highpeng/sub/electrical/bom.xlsx

Sheet: Sheet1
 |  | L | delta IL | Rsense |  | Rsense,comp | Psense | Id peak | fr | fc | Rcomp | Ccomp | Ccomp2
12.6 | 0.65 | 4.7775e-06 | 1.428571429 | 0.04958333333 |  |  |  |  | 293824.7585
9 | 0.75 | 2.8125e-06 | 2 | 0.03541666667 |  | 0.03225880592 | 0.0313985711 | 4 | 254648.124 | 20000 | 15085.78924 | 2.110000013e-09 | 100pF
Current |  |  |  |  | Vcs | 0.09000141667
0.5
 |  |  |  | 1919.937206
Mmin | Mmax | Rout
2.857142857 | 4

Sheet: BOM
 |  |  |  |  | Qty Required | Qty Ordered
v BT401, BT501 | Battery |  | ~ | 2
C201 | 0.01uF |  | ~ | 1
> C202, C204 | 10nF |  | ~ | 2
> C203, C206, C301, C302, C1101, C1103, C1105, C1107, C1109-C1115, C1117-C1120, C1124, C1125, C1202 | 0.1uF |  | ~ | 22
> C205, C207, C303, C1102, C1104, C1106, C1108, C1206, C1207 | 4.7uF |  | ~ | 9
> C208, C209 | 230nF |  | ~ | 2
> C210, C211 | 100pF, 50V |  | ~ | 2
> C401, C501, C1209, C1211-C1213 | C_Small |  | ~ | 6
> C601, C602, C611 | 22uF,35V | Capacitor_SMD:C_1210_3225Metric | 587-5853-1-ND | 3
> C603-C606, C612, C613 | 0.1uF | Capacitor_SMD:C_0402_1005Metric | 1276-1044-1-ND | 6
> C607-C610, C614, C615 | 22uF | Capacitor_SMD:C_1210_3225Metric | 1276-1851-1-ND | 6
> C701-C704, C1123 | 1.0uF |  | ~ | 5
C901 | 10uF, 25V |  | ~ | 1
C902 | 0.01uF, 16V |  | ~ | 1
> C903, C904 | 1uF, 16V |  | ~ | 2
> C1116, C1121, C1122 | 2.2uF |  | ~ | 3
C1201 | 22uF, 25V |  | ~ | 1
C1203 | 33nF |  | ~ | 1
C1204 | 6.8nF |  | ~ | 1
C1205 | 22uF, 63V, X7R |  | ~ | 1
C1208 | 0.1uF, 50V |  | ~ | 1
C1210 | CP1 |  | ~ | 1
> D201-D203, D1101 | LED |  | ~ | 4
D901 | BZX84C11 |  | ~ | 1
D902 | CMDSH-3 |  | ~ | 1
D903 | SS13 |  | ~ | 1
D1201 | 50V,4A |  | ~ | 1
D1202 | D |  | ~ | 1
F101 | 6A |  | ~ | 1
> FB201, FB202 | FB |  | ~ | 2
FL201 | 2.2mH |  | ~ | 1
J201 | Ethernet |  | ~ | 1
J301 | RS485 |  | ~ | 1
> J401-J404, J501-J504, J913 | Conn_01x02 |  | ~ | 9
> J701-J704 | PTC thermistor |  | ~ | 4
J705 | water sensor |  | ~ | 1
J706 | IMU |  | ~ | 1
> J801, J1101, J1102 | USB_B_Micro |  | ~ | 3
J802 | Cam0 |  | ~ | 1
> J803, J1104 | Micro_SD_Card_Det |  | https://www.hirose.com/product/en/download_file/key_name/DM3/category/Catalog/doc_file_id/49662/?item_id=195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 | 2
J804 | Cam1 |  | ~ | 1
> J901-J912 | Conn_01x03 |  | ~ | 12
J1001 | Raspberry_Pi_Zero |  | https://www.raspberrypi.org/documentation/hardware/raspberrypi/schematics/rpi_SCH_3bplus_1p0_reduced.pdf | 1
J1103 | JTAG |  | ~ | 1
J1201 | lidar |  | ~ | 1
J1202 | barometer |  | ~ | 1
J1203 | pinger |  | ~ | 1
J1204 | depth |  | ~ | 1
L601 | 2.0uH | holo:NR8040 | 587-1997-1-ND | 1
L602 | 3.6uH | holo:NR8040 | 587-1998-1-ND | 1
L603 | 4.7uH | holo:NR8040 | 587-1999-1-ND | 1
L901 | 6.8uH, 1.5A |  | ~ | 1
L1201 | 13.3uH, 4A |  | ~ | 1
Q1201 | 2N7002K | Package_TO_SOT_SMD:SOT-23 | https://www.diodes.com/assets/Datasheets/ds30896.pdf | 1
> R101-R104, R801, R802, R1201, R1209-R1211, R1213 | 4.7K |  | ~ | 11
R105 | 0R |  | ~ | 1
> R201, R204 | 50R |  | ~ | 2
> R202, R203 | 2K |  | ~ | 2
> R205-R207 | 470R |  | ~ | 3
> R301, R1203 | 40K |  | ~ | 2
R302 | 120R |  | ~ | 1
> R401, R501 | 0m5 |  | WSLP4026 | 2
> R601, R602, R608 | 100K | Resistor_SMD:R_0402_1005Metric | RMCS0402JT100KCT-ND | 3
R603 | 47K | Resistor_SMD:R_0402_1005Metric | 541-3966-1-ND | 1
R604 | 5.0K | Resistor_SMD:R_0402_1005Metric | 541-3972-1-ND | 1
R605 | 10.31K | Resistor_SMD:R_0402_1005Metric | RR12P10.2KDCT-ND | 1
> R606, R609 | 75K | Resistor_SMD:R_0402_1005Metric | 541-5078-1-ND | 2
R607 | 27.6K | Resistor_SMD:R_0402_1005Metric | ‎311-27.4KLRCT-ND‎ | 1
R610 | 14.46K | Resistor_SMD:R_0402_1005Metric |  | 1
> R701-R704 | SOT |  | ~ | 4
R705 | 1.0M |  | ~ | 1
> R706, R707 | 100K |  | ~ | 2
> R803-R806 | 1.8K |  | ~ | 4
> R901, R1205 | 10K |  | ~ | 2
R902 | 0R2, 0.5W |  | ~ | 1
R1101 | 8.06K, 1% |  | ~ | 1
R1102 | 330R |  | ~ | 1
R1202 | 66.5K |  | ~ | 1
R1204 | 276K |  | ~ | 1
R1206 | 10R |  | ~ | 1
> R1207, R1208 | NIP |  | ~ | 2
R1212 | 1.0K |  | ~ | 1
RL1201 | G2RL-2-ASI-DC5 | Relay_THT:Relay_DPDT_Omron_G2RL | https://omronfs.omron.com/en_US/ecb/products/pdf/en-g2rl.pdf | 1
T1201 | Transformer_SP_1S |  | ~ | 1
U201 | DP83TD510E |  |  | 1 | 2 | stock-3
U301 | MAX22500E |  |  | 1 | 0 | 0
> U401, U501 | LTC2943 |  |  | 2 | 1 | 2
> U601-U603 | RT7263A | holo:SOP-EP-8_3.9x4.9mm_P1.27mm | 1028-1217-1-ND | 3 | 5 | 10
U701 | TLV7011 |  |  | 1 | 1 | 2
U801 | RaspberryPi-CM3+ |  | https://www.raspberrypi.org/documentation/hardware/computemodule/datasheets/rpi_DATA_CM3plus_1p0.pdf | 1
> U901-U903 | 74HCT125 |  | 1727-2834-1-ND | 3 | 3 | 5
U904 | LM3405A |  |  | 1 | 1 | 2
U1101 | USB3318 |  |  | 1 | 2 | 3
U1102 | STM32F217IETx | Package_QFP:LQFP-176_24x24mm_P0.5mm | http://www.st.com/st-web-ui/static/active/en/resource/technical/document/datasheet/CD00263874.pdf | 1 | 2 | stock -3
U1201 | MP3426 |  |  | 1 | 1 | 2
U1202 | ADP165 |  |  | 1 | 1 | 2
U1203 | TUSS44x0 |  |  | 1
X1101 | ASE-13MHz | Oscillator:Oscillator_SMD_Abracon_ASE-4Pin_3.2x2.5mm | http://www.abracon.com/Oscillators/ASV.pdf | 1
X1102 | ASE-25MHz | Oscillator:Oscillator_SMD_Abracon_ASE-4Pin_3.2x2.5mm | http://www.abracon.com/Oscillators/ASV.pdf | 1

Sheet: BOM - sub, base
> BT401, BT501 | Battery | sub:AMASS_XT60-M | ~ | 2
> C1211, C1214 | SOT | Capacitor_SMD:C_0603_1608Metric | ~ | 2
C1216 | NIP | Capacitor_SMD:C_0603_1608Metric | ~ | 1
C1217 | SOT | Capacitor_SMD:C_0402_1005Metric | ~ | 1
> J401-J404, J501-J504 | thruster_esc | sub:AMASS_XT30U-F_1x02_P5.0mm_Vertical | ~ | 8
J901 | thruster_esc0 | Connector_PinHeader_2.54mm:PinHeader_1x03_P2.54mm_Vertical | ~ | 1
J902 | thruster_esc1 | Connector_PinHeader_2.54mm:PinHeader_1x03_P2.54mm_Vertical | ~ | 1
J903 | thruster_esc2 | Connector_PinHeader_2.54mm:PinHeader_1x03_P2.54mm_Vertical | ~ | 1
J904 | thruster_esc3 | Connector_PinHeader_2.54mm:PinHeader_1x03_P2.54mm_Vertical | ~ | 1
J905 | thruster_esc4 | Connector_PinHeader_2.54mm:PinHeader_1x03_P2.54mm_Vertical | ~ | 1
J906 | thruster_esc5 | Connector_PinHeader_2.54mm:PinHeader_1x03_P2.54mm_Vertical | ~ | 1
J907 | thruster_esc6 | Connector_PinHeader_2.54mm:PinHeader_1x03_P2.54mm_Vertical | ~ | 1
J908 | thruster_esc7 | Connector_PinHeader_2.54mm:PinHeader_1x03_P2.54mm_Vertical | ~ | 1
J909 | servo0 | Connector_PinHeader_2.54mm:PinHeader_1x03_P2.54mm_Vertical | ~ | 1
J910 | servo1 | Connector_PinHeader_2.54mm:PinHeader_1x03_P2.54mm_Vertical | ~ | 1
J911 | servo2 | Connector_PinHeader_2.54mm:PinHeader_1x03_P2.54mm_Vertical | ~ | 1
J912 | servo3 | Connector_PinHeader_2.54mm:PinHeader_1x03_P2.54mm_Vertical | ~ | 1
J1101 | nRPIBoot | Connector_PinHeader_1.27mm:PinHeader_1x02_P1.27mm_Vertical | ~ | 1
R105 | 0R | sub:AMASS_XT30U-F_1x02_P5.0mm_Vertical | ~ | 1
> R1101, R1103 | DNP | Resistor_SMD:R_0402_1005Metric | ~ | 2
> R1207, R1208 | NIP | Resistor_SMD:R_1206_3216Metric | ~ | 2
R1211 | NIP | Resistor_SMD:R_0603_1608Metric | ~ | 1
BT701 | Battery | sub:AMASS_XT60-M | ~ | 1
J702 | Battery charge | Connector_JST:JST_XH_B3B-XH-AM_1x03_P2.50mm_Vertical | ~ | 1
J801 | nRPIBoot | Connector_PinHeader_1.27mm:PinHeader_1x02_P1.27mm_Vertical | ~ | 1
> R801, R803 | DNP | Resistor_SMD:R_0402_1005Metric | ~ | 2
TH701 | 103AT | Connector_Hirose:Hirose_DF13C_CL535-0402-2-51_1x02-1MP_P1.25mm_Vertical | ~ | 1
> U601-U603 | RT7263A | sub:SOP-EP-8_3.9x4.9mm_P1.27mm | 1028-1217-1-ND | 3
> U601-U603 | RT7263A | sub:SOP-EP-8_3.9x4.9mm_P1.27mm | 1028-1217-1-ND | 3
BZ201 | Buzzer | sub:CPI-1375-80T | 102-CPI-1375-80T-ND | 1
> R706, R708-R710, R1102, R1213 | 1.0K | Resistor_SMD:R_0402_1005Metric | 118-CR0402AFX-1001GLFCT-ND | 6
> R209, R210, R802 | 1.0K | Resistor_SMD:R_0402_1005Metric | 118-CR0402AFX-1001GLFCT-ND | 3
> C206, C207, C303, C705, C801, C901, C902, C905, C1206, C1208, C1302, C1304, C1306, C1308, C1330 | 4.7uF | Capacitor_SMD:C_0603_1608Metric | 1276-1044-1-ND | 15
> C202, C204, C206, C208, C306, C307, C403, C501, C703 | 4.7uF | Capacitor_SMD:C_0603_1608Metric | 1276-1044-1-ND | 9
> C1316, C1321, C1322, C1326 | 2.2uF | Capacitor_SMD:C_0603_1608Metric | 1276-1134-1-ND | 4
> C211, C219, C232, C233 | 2.2uF | Capacitor_SMD:C_0603_1608Metric | 1276-1134-1-ND | 4
> C601, C606, C607, C616-C618, C907, C1201, C1218 | 10uF,25V | Capacitor_SMD:C_1206_3216Metric | 1276-1181-1-ND | 9
> C601, C602, C607-C610, C701 | 10uF,25V | Capacitor_SMD:C_1206_3216Metric | 1276-1181-1-ND | 7
> C604, C605, C612-C615 | 22uF | Capacitor_SMD:C_1210_3225Metric | 1276-1851-1-ND | 6
> C605, C606, C615-C618, C704, C707 | 22uF, 16V | Capacitor_SMD:C_1210_3225Metric | 1276-1851-1-ND | 8
> C401, C501, C701-C704, C910, C911, C1102, C1323 | 1.0uF, 16V | Capacitor_SMD:C_0603_1608Metric | 1276-6524-1-ND | 10
> C213, C214, C234, C705, C706, C801 | 1.0uF | Capacitor_SMD:C_0603_1608Metric | 1276-6524-1-ND | 6
C908 | 0.1uF,25V | Capacitor_SMD:C_01005_0402Metric | 1276-CL05B104KA54PNCCT-ND | 1
> C204, C205, C301, C302, C602, C603, C608-C611, C706, C903, C904, C906, C1103, C1202, C1301, C1303, C1305, C1307, C1309-C1315, C1317-C1320, C1324, C1325, C1327-C1329 | 0.1uF | Capacitor_SMD:C_0402_1005Metric | 1292-1630-1-ND | 36
> C201, C203, C205, C207, C209, C210, C212, C215-C218, C220-C222, C225, C235-C237, C304, C305, C401, C402, C603, C604, C611-C614, C702, C802 | 0.1uF | Capacitor_SMD:C_0402_1005Metric | 1292-1630-1-ND | 30
> C212, C213 | 100pF, 50V | Capacitor_SMD:C_0603_1608Metric | 13-CC0603KPX7R9BB101CT-ND | 2
> C312, C313 | 100pF, 50V | Capacitor_SMD:C_0603_1608Metric | 13-CC0603KPX7R9BB101CT-ND | 2
> JY201-JY204 | joystick | sub:XDCR_COM-09032 | 1568-1526-ND | 4
U1201 | MP3426 | Package_DFN_QFN:DFN-14-1EP_3x4mm_P0.5mm_EP1.7x3.3mm | 1589-1644-1-ND | 1
U204 | MP6513 | Package_TO_SOT_SMD:TSOT-23-6 | 1589-1709-1-ND | 1
U701 | MP2672A | sub:QFN-18 | 1589-MP2672AGD-0000-ZCT-ND | 1
D1202 | 1N4148 | Diode_SMD:D_SOD-123 | 1655-1360-1-ND | 1
> D703-D705 | 1N4148 | Diode_SMD:D_SOD-123 | 1655-1360-1-ND | 3
> U901-U903 | 74HCT125 | Package_SO:SO-14_3.9x8.65mm_P1.27mm | 1727-2834-1-ND | 3
U1205 | 74LVC2G17 | Package_TO_SOT_SMD:SOT-363_SC-70-6 | 1727-4122-1-ND | 1
F101 | 6A | sub:2920L | 18-2920L600/16MRCT-ND | 1
> D201-D203, D1101, D1301 | LED | LED_SMD:LED_0402_1005Metric | 1830-IN-S42BCT-ND | 5
> D201, D301-D303, D701, D702, D801 | LED | LED_SMD:LED_0402_1005Metric | 1830-IN-S42BCT-ND | 7
X1301 | 13MHz | sub:831056290 | 1923-831056290CT-ND | 1
X201 | 13MHz | sub:831056290 | 1923-831056290CT-ND | 1
> R205, R208 | 50R | Resistor_SMD:R_0402_1005Metric | 2019-RN731ETTP50R0F50CT-ND | 2
> R305, R308 | 50R | Resistor_SMD:R_0402_1005Metric | 2019-RN731ETTP50R0F50CT-ND | 2
BT201 | Battery_Cell | sub:BH-49C-1-BK | 2057-BH-49C-1-BK-ND | 1
J1303 | JTAG | Connector_IDC:IDC-Header_2x10_P2.54mm_Vertical | 2057-BHR-20-VUA-ND | 1
J206 | JTAG | Connector_IDC:IDC-Header_2x10_P2.54mm_Vertical | 2057-BHR-20-VUA-ND | 1
> J803, J1104, J1304 | Micro_SD_Card_Det | sub:MEM2061 | 2073-MEM2061-01-188-00-ACT-ND | 3
> J503, J804 | Micro_SD_Card_Det | sub:MEM2061 | 2073-MEM2061-01-188-00-ACT-ND | 2
U701 | TLV4082 | Package_TO_SOT_SMD:SOT-23-6 | 296-TLV4082QDBVRQ1CT-ND | 1
Q1201 | 2N7002K | Package_TO_SOT_SMD:SOT-23 | 2N7002KCT-ND | 1
Y201 | Crystal_Small | sub:CMJ206T | 300-8189-1-ND | 1
L701 | 2.5uH, 5A | sub:CDRH8D38 | 308-2141-1-ND | 1
> C210, C211 | 220nF,16V | Capacitor_SMD:C_0603_1608Metric | 311-1426-1-ND | 2
> C310, C311 | 220nF,16V | Capacitor_SMD:C_0603_1608Metric | 311-1426-1-ND | 2
> C1204, C1213 | 6.8nF | Capacitor_SMD:C_0402_1005Metric | 311-1719-1-ND | 2
C709 | 6.8nF | Capacitor_SMD:C_0402_1005Metric | 311-1719-1-ND | 1
R1209 | 3K, 1/4W | Resistor_SMD:R_1206_3216Metric | 311-3.00KFRCT-ND | 1
> C201-C203, C909 | 10nF, 16V | Capacitor_SMD:C_0402_1005Metric | 311-3267-1-ND | 4
> C301-C303 | 10nF, 16V | Capacitor_SMD:C_0402_1005Metric | 311-3267-1-ND | 3
R1301 | 8.06K, 1% | Resistor_SMD:R_0402_1005Metric | 311-8.06KLRCT-ND | 1
R208 | 8.06K, 1% | Resistor_SMD:R_0402_1005Metric | 311-8.06KLRCT-ND | 1
D901 | RB720M-30 | Diode_SMD:SOD-923 | 3757-RB720M-30_R1_00001CT-ND | 1
C1212 | 100uF, 63V | sub:CP_MS10 | 399-A780MS107M1JLAS030CT-ND | 1
C1210 | 0.1uF, 63V | Capacitor_SMD:C_1206_3216Metric | 399-C1206C104MMREC7210CT-ND | 1
RL1201 | EA2-5NJ | sub:EA2-5NJ | 399-EA2-5NJ-ND | 1
L901 | 6.8uH, 1.5A | Inductor_SMD:L_TDK_VLS3012 | 445-175072-1-ND | 1
> C1207, C1209 | 1nF | Capacitor_SMD:C_0402_1005Metric | 445-4924-1-ND | 2
C708 | 1nF | Capacitor_SMD:C_0402_1005Metric | 445-4924-1-ND | 1
C1203 | 33nF | Capacitor_SMD:C_0402_1005Metric | 478-12621-1-ND | 1
> C208, C209, C1101 | 10uF | Capacitor_SMD:C_0805_2012Metric | 490-10517-1-ND | 3
> C308, C309, C803 | 10uF | Capacitor_SMD:C_0805_2012Metric | 490-10517-1-ND | 3
> FB201, FB202 | FB | Resistor_SMD:R_0603_1608Metric | 490-5213-1-ND | 2
> FB301, FB302 | FB | Resistor_SMD:R_0603_1608Metric | 490-5213-1-ND | 2
> C1205, C1219 | 10uF, 63V, X7R | Capacitor_SMD:C_1210_3225Metric | 490-9971-1-ND | 2
T1201 | B78416A2232A003 | sub:XFRMR_B78416 | 495-6812-1-ND | 1
X1302 | 25MHz | sub:ASFL1 | 535-10819-1-ND | 1
X202 | 25MHz | sub:ASFL1 | 535-10819-1-ND | 1
> R206, R207 | 2K | Resistor_SMD:R_2512_6332Metric | 541-2.0KXCT-ND | 2
> R306, R307 | 2K | Resistor_SMD:R_2512_6332Metric | 541-2.0KXCT-ND | 2
R701 | 28.7K | Resistor_SMD:R_0402_1005Metric | 541-28.7KLCT-ND | 1
R603 | 5.0K | Resistor_SMD:R_0402_1005Metric | 541-3972-1-ND | 1
R603 | 5.0K | Resistor_SMD:R_0402_1005Metric | 541-3972-1-ND | 1
R610 | 14.46K | Resistor_SMD:R_0402_1005Metric | 541-4465-1-ND | 1
R610 | 14.46K | Resistor_SMD:R_0402_1005Metric | 541-4465-1-ND | 1
> R607, R609 | 75K | Resistor_SMD:R_0402_1005Metric | 541-5078-1-ND | 2
> R607, R609 | 75K | Resistor_SMD:R_0402_1005Metric | 541-5078-1-ND | 2
L601 | 2.0uH | sub:NR8040 | 587-1997-1-ND | 1
L601 | 2.0uH | sub:NR8040 | 587-1997-1-ND | 1
L602 | 3.6uH | sub:NR8040 | 587-1998-1-ND | 1
L602 | 3.6uH | sub:NR8040 | 587-1998-1-ND | 1
L603 | 4.7uH | sub:NR8040 | 587-1999-1-ND | 1
L603 | 4.7uH | sub:NR8040 | 587-1999-1-ND | 1
C1215 | 330pF, 100V | Resistor_SMD:R_0805_2012Metric | 732-12232-1-ND | 1
FL201 | 2.2mH | Inductor_SMD:L_WE_SL5 | 732-1494-1-ND | 1
FL301 | 2.2mH | Inductor_SMD:L_WE_SL5 | 732-1494-1-ND | 1
> J801, J1102, J1301, J1302 | USB_B_Micro | Connector_USB:USB_Micro-B_Wuerth_629105150521 | 732-5960-1-ND | 4
> J201, J205, J501, J701, J802 | USB_B_Micro | Connector_USB:USB_Micro-B_Wuerth_629105150521 | 732-5960-1-ND | 5
L1201 | 13.3uH, 4A | sub:L_7447706150 | 732-7447706150CT-ND | 1
U1203 | AOZ13984DI-02 | sub:DFN-12-1EP_3x3mm_P0.5mm_EP1.5x2.5mm | 785-AOZ13984DI-02CT-ND | 1
U703 | AOZ13984DI-02 | sub:DFN3x3-12L | 785-AOZ13984DI-02CT-ND | 1
U801 | RaspberryPi-CM3+L | Connector:Conn_TE-DDR2-SODIMM-0.6-200P-doublesided | A111047CT-ND | 1
U501 | MCU_Module:RaspberryPi-CM3+L | Connector:Conn_TE-DDR2-SODIMM-0.6-200P-doublesided | A111047CT-ND | 1
> R101-R104, R401, R501, R801, R802, R1201 | 4.7K | Resistor_SMD:R_0402_1005Metric | A121542CT-ND | 9
> R201-R204, R501, R502, R712, R713 | 4.7K | Resistor_SMD:R_0402_1005Metric | A121542CT-ND | 8
R1206 | 10R | Resistor_SMD:R_0603_1608Metric | A129664CT-ND | 1
R302 | 120R | Resistor_SMD:R_1206_3216Metric | A129799CT-ND | 1
R402 | 120R | Resistor_SMD:R_1206_3216Metric | A129799CT-ND | 1
U1202 | ADP165 | Package_TO_SOT_SMD:SOT-23-5 | ADP165AUJZ-3.3-R7CT-ND | 1
U1102 | AP22814AW5 | Package_TO_SOT_SMD:SOT-23-5 | AP22804AW5-7DICT-ND | 1
U802 | AP22814AW5 | Package_TO_SOT_SMD:SOT-23-5 | AP22804AW5-7DICT-ND | 1
R604 | 4.07K | Resistor_SMD:R_0402_1005Metric | CR0402-FX-4021GLFCT-ND | 1
R604 | 4.07K | Resistor_SMD:R_0402_1005Metric | CR0402-FX-4021GLFCT-ND | 1
R711 | 0.01R | Resistor_SMD:R_0805_2012Metric | CRF0805-FZ-R010ELFCT-ND | 1
U203 | DS1338 | Package_SO:SOIC-8_3.9x4.9mm_P1.27mm | DS1338Z-3+CT-ND | 1
> F1201, F1202 | 3A | sub:2016 | F8539CT-ND | 2
J1203 | Transducers | Connector_Hirose:Hirose_DF11-4DP-2DSA_2x02_P2.00mm_Vertical | H10229-ND | 1
J201 | Ethernet | Connector_Hirose:Hirose_DF13C_CL535-0402-2-51_1x02-1MP_P1.25mm_Vertical | H126391-ND | 1
J301 | RS485 | Connector_Hirose:Hirose_DF13C_CL535-0402-2-51_1x02-1MP_P1.25mm_Vertical | H126391-ND | 1
> J701-J704 | PTC thermistor | Connector_Hirose:Hirose_DF13C_CL535-0402-2-51_1x02-1MP_P1.25mm_Vertical | H126391-ND | 4
J705 | water sensor0 | Connector_Hirose:Hirose_DF13C_CL535-0402-2-51_1x02-1MP_P1.25mm_Vertical | H126391-ND | 1
J706 | water sensor1 | Connector_Hirose:Hirose_DF13C_CL535-0402-2-51_1x02-1MP_P1.25mm_Vertical | H126391-ND | 1
J913 | LED | Connector_Hirose:Hirose_DF13C_CL535-0402-2-51_1x02-1MP_P1.25mm_Vertical | H126391-ND | 1
> J202, J203 | PTC thermistor | Connector_Hirose:Hirose_DF13C_CL535-0402-2-51_1x02-1MP_P1.25mm_Vertical | H126391-ND | 2
J204 | Fan | Connector_Hirose:Hirose_DF13C_CL535-0402-2-51_1x02-1MP_P1.25mm_Vertical | H126391-ND | 1
J301 | Ethernet | Connector_Hirose:Hirose_DF13C_CL535-0402-2-51_1x02-1MP_P1.25mm_Vertical | H126391-ND | 1
J401 | RS485 | Connector_Hirose:Hirose_DF13C_CL535-0402-2-51_1x02-1MP_P1.25mm_Vertical | H126391-ND | 1
SW701 | Power | Connector_Hirose:Hirose_DF13C_CL535-0402-2-51_1x02-1MP_P1.25mm_Vertical | H126391-ND | 1
J707 | IMU | Connector_Hirose:Hirose_DF13C_CL535-0404-8-51_1x04-1MP_P1.25mm_Vertical | H126401-ND | 1
J1201 | barometer | Connector_Hirose:Hirose_DF13C_CL535-0404-8-51_1x04-1MP_P1.25mm_Vertical | H126401-ND | 1
J1202 | lidar | Connector_Hirose:Hirose_DF13C_CL535-0404-8-51_1x04-1MP_P1.25mm_Vertical | H126401-ND | 1
U1302 | STM32F217IETx | Package_QFP:LQFP-176_24x24mm_P0.5mm | http://www.st.com/st-web-ui/static/active/en/resource/technical/document/datasheet/CD00263874.pdf | 1
J1001 | Raspberry_Pi | Module:Raspberry_Pi_Zero_Socketed_THT_MountingHoles_SMT | https://www.raspberrypi.org/documentation/hardware/raspberrypi/schematics/rpi_SCH_3bplus_1p0_reduced.pdf | 1
J1401 | Raspberry_Pi | Module:MODULE_RASPBERRY_PI_3_MODEL_B+ | https://www.raspberrypi.org/documentation/hardware/raspberrypi/schematics/rpi_SCH_3bplus_1p0_reduced.pdf | 1
U904 | LM3405A | sub:VSSOP-8_3.0x3.0mm_P0.65mm-EP | LM3405AXMY/NOPBCT-ND | 1
> U401, U501 | LTC2943 | Package_DFN_QFN:DFN-8-1EP_3x3mm_P0.5mm_EP1.66x2.38mm | LTC2943CDD#TRPBFCT-ND | 2
U702 | LTC2943 | Package_DFN_QFN:DFN-8-1EP_3x3mm_P0.5mm_EP1.66x2.38mm | LTC2943CDD#TRPBFCT-ND | 1
U301 | MAX22500E | Package_DFN_QFN:DFN-10-1EP_3x3mm_P0.5mm_EP1.55x2.48mm | MAX22500EATB+-ND | 1
U401 | MAX22500E | Package_DFN_QFN:DFN-10-1EP_3x3mm_P0.5mm_EP1.55x2.48mm | MAX22500EATB+-ND | 1
D902 | 30V, 1A | Diode_SMD:DO-219AD | MSS1P3L-M3/89AGICT-ND | 1
R902 | 0R2, 0.5W | Resistor_SMD:R_0805_2012Metric | P19315CT-ND | 1
R1204 | 276K | Resistor_SMD:R_0402_1005Metric | P274KLCT-ND | 1
R602 | 30K | Resistor_SMD:R_0402_1005Metric | P30KJCT-ND | 1
R602 | 30K | Resistor_SMD:R_0402_1005Metric | P30KJCT-ND | 1
> R209-R211, R1210, R1212, R1302 | 470R | Resistor_SMD:R_0402_1005Metric | P470LCT-ND | 6
> R211, R309-R311 | 470R | Resistor_SMD:R_0402_1005Metric | P470LCT-ND | 4
R708 | 12.62K | Resistor_SMD:R_0402_1005Metric | RMCF0402FT12K7CT-ND | 1
> R803-R806, R1104, R1106, R1108-R1110 | 1.8K | Resistor_SMD:R_0402_1005Metric | RMCF0402FT1K80CT-ND | 9
> R503-R506, R804, R807-R810 | 1.8K | Resistor_SMD:R_0402_1005Metric | RMCF0402FT1K80CT-ND | 9
> R705, R707 | 1.0M | Resistor_SMD:R_0402_1005Metric | RMCF0402FT1M00CT-ND | 2
R705 | 24K | Resistor_SMD:R_0402_1005Metric | RMCF0402FT24K0CT-ND | 1
R608 | 24.32K | Resistor_SMD:R_0402_1005Metric | RMCF0402FT24K3CT-ND | 1
R608 | 24.32K | Resistor_SMD:R_0402_1005Metric | RMCF0402FT24K3CT-ND | 1
R401 | 40K | Resistor_SMD:R_0402_1005Metric | RMCF0402FT40K2CT-ND | 1
> R301, R1203 | 40K | Resistor_SMD:R_0402_1005Metric | RMCF0402FT40R2CT-ND | 2
R1202 | 66.5K | Resistor_SMD:R_0402_1005Metric | RMCF0402FT66K5CT-ND | 1
R710 | 40R, 1206 | Resistor_SMD:R_1206_3216Metric | RMCF1206FT40R2CT-ND | 1
> R601, R605, R606 | 100K | Resistor_SMD:R_0402_1005Metric | RMCS0402JT100KCT-ND | 3
> R601, R605, R606, R714 | 100K | Resistor_SMD:R_0402_1005Metric | RMCS0402JT100KCT-ND | 4
R709 | 3.63K | Resistor_SMD:R_0402_1005Metric | RR05P3.6KDCT-ND | 1
D1201 | 50V,4A | Diode_SMD:D_SMC | SK55L-TPMSCT-ND | 1
U1204 | TUSS44x0 | sub:WQFN-20 | TUSS4470TRTJT | 1
U1301 | USB3318 | sub:QFN-24-1EP_4x4mm_P0.5mm_EP2.6x2.6mm | USB3318-CP-TR | 1
U201 | USB3318 | sub:QFN-24-1EP_4x4mm_P0.5mm_EP2.6x2.6mm | USB3318-CP-TR | 1
> J802, J1103 | Cam0 | sub:Molex_200528-0150_1x15-1MP_P1.00mm_Horizontal | WM10967CT-ND | 2
> J804, J1105 | Cam1 | sub:Molex_200528-0150_1x15-1MP_P1.00mm_Horizontal | WM10967CT-ND | 2
> J502, J504, J803, J805 | Disp0 | sub:Molex_200528-0150_1x15-1MP_P1.00mm_Horizontal | WM10967CT-ND | 4
R706 | SOT | Resistor_SMD:R_0402_1005Metric | WSLP4026 | 1
> R701-R704, R901, R1205, R1303 | 10K | Resistor_SMD:R_0402_1005Metric | YAG1249CT-ND | 7
> R205-R207, R702 | 10K | Resistor_SMD:R_0402_1005Metric | YAG1249CT-ND | 4
> R201-R204, R1105, R1107 | 2.2K | Resistor_SMD:R_0402_1005Metric | YAG3467CT-ND | 6
> R301-R304, R703, R704, R805, R806 | 2.2K | Resistor_SMD:R_0402_1005Metric | YAG3467CT-ND | 8
> R402, R502 | 0m5 | Resistor_SMD:R_Shunt_Yaego_PU3921 | YAG6127CT-ND | 2
U201 | DP83TD510E | Package_DFN_QFN:TQFN-32-1EP_5x5mm_P0.5mm_EP2.1x2.1mm |  | 1
U1101 | Compute_Module_4_Connectors | Module:CM4 |  | 1
> C223, C224, C226-C231 | SOT | Capacitor_SMD:C_0402_1005Metric |  | 8
J901 | Raspberry_Pi_2_3 | Module:MODULE_RASPBERRY_PI_3_MODEL_B+ |  | 1
R707 | NIP | Resistor_SMD:R_0402_1005Metric |  | 1
U202 | STM32F217IETx | Package_QFP:LQFP-176_24x24mm_P0.5mm |  | 1
U301 | DP83TD510E | Package_DFN_QFN:TQFN-32-1EP_5x5mm_P0.5mm_EP2.1x2.1mm |  | 1
U801 | Compute_Module_4_Connectors | Module:CM4 |  | 1

Sheet: BOM - sub, base (2)
> BT401, BT501 | Battery | sub:AMASS_XT60-M | ~ | 1 | 0
> C1211, C1214 | SOT | Capacitor_SMD:C_0603_1608Metric | ~ | 2 | 0
C1216 | NIP | Capacitor_SMD:C_0603_1608Metric | ~ | 1 | 0
C1217 | SOT | Capacitor_SMD:C_0402_1005Metric | ~ | 1 | 0
> J401-J404, J501-J504 | thruster_esc | sub:AMASS_XT30U-F_1x02_P5.0mm_Vertical | ~ | 4 | 0
J902 | thruster_esc1 | Connector_PinHeader_2.54mm:PinHeader_1x03_P2.54mm_Vertical | ~ | 1 | 0
J903 | thruster_esc2 | Connector_PinHeader_2.54mm:PinHeader_1x03_P2.54mm_Vertical | ~ | 1 | 0
J904 | thruster_esc3 | Connector_PinHeader_2.54mm:PinHeader_1x03_P2.54mm_Vertical | ~ | 1 | 0
J905 | thruster_esc4 | Connector_PinHeader_2.54mm:PinHeader_1x03_P2.54mm_Vertical | ~ | 1 | 0
J906 | thruster_esc5 | Connector_PinHeader_2.54mm:PinHeader_1x03_P2.54mm_Vertical | ~ | 1 | 0
J907 | thruster_esc6 | Connector_PinHeader_2.54mm:PinHeader_1x03_P2.54mm_Vertical | ~ | 1 | 0
J908 | thruster_esc7 | Connector_PinHeader_2.54mm:PinHeader_1x03_P2.54mm_Vertical | ~ | 1 | 0
J909 | servo0 | Connector_PinHeader_2.54mm:PinHeader_1x03_P2.54mm_Vertical | ~ | 1 | 0
J910 | servo1 | Connector_PinHeader_2.54mm:PinHeader_1x03_P2.54mm_Vertical | ~ | 1 | 0
J911 | servo2 | Connector_PinHeader_2.54mm:PinHeader_1x03_P2.54mm_Vertical | ~ | 1 | 0
J912 | servo3 | Connector_PinHeader_2.54mm:PinHeader_1x03_P2.54mm_Vertical | ~ | 1 | 0
J1101 | nRPIBoot | Connector_PinHeader_1.27mm:PinHeader_1x02_P1.27mm_Vertical | ~ | 1 | 0
R105 | 0R | sub:AMASS_XT30U-F_1x02_P5.0mm_Vertical | ~ | 1 | 0
> R1101, R1103 | DNP | Resistor_SMD:R_0402_1005Metric | ~ | 2 | 0
> R1207, R1208 | NIP | Resistor_SMD:R_1206_3216Metric | ~ | 2 | 0
R1211 | NIP | Resistor_SMD:R_0603_1608Metric | ~ | 1 | 0
BT701 | Battery | sub:AMASS_XT60-M | ~ | 1 | 0
J801 | nRPIBoot | Connector_PinHeader_1.27mm:PinHeader_1x02_P1.27mm_Vertical | ~ | 1 | 0
> R801, R803 | DNP | Resistor_SMD:R_0402_1005Metric | ~ | 2 | 0
TH701 | 103AT | Connector_Hirose:Hirose_DF13C_CL535-0402-2-51_1x02-1MP_P1.25mm_Vertical | H126391-ND | 1 | 0
> U601-U603 | RT7263A | sub:SOP-EP-8_3.9x4.9mm_P1.27mm | 1028-1217-1-ND |  | 0
> R209, R210, R802 | 1.0K | Resistor_SMD:R_0402_1005Metric | 118-CR0402AFX-1001GLFCT-ND |  | 0
> C202, C204, C206, C208, C306, C307, C403, C501, C703 | 4.7uF | Capacitor_SMD:C_0603_1608Metric | 1276-1044-1-ND |  | 0
> C211, C219, C232, C233 | 2.2uF | Capacitor_SMD:C_0603_1608Metric | 1276-1134-1-ND |  | 0
> C601, C602, C607-C610, C701 | 10uF,25V | Capacitor_SMD:C_1206_3216Metric | 1276-1181-1-ND |  | 0
> C605, C606, C615-C618, C704, C707 | 22uF, 16V | Capacitor_SMD:C_1210_3225Metric | 1276-1851-1-ND |  | 0
> C213, C214, C234, C705, C706, C801 | 1.0uF | Capacitor_SMD:C_0603_1608Metric | 1276-6524-1-ND |  | 0
> C201, C203, C205, C207, C209, C210, C212, C215-C218, C220-C222, C225, C235-C237, C304, C305, C401, C402, C603, C604, C611-C614, C702, C802 | 0.1uF | Capacitor_SMD:C_0402_1005Metric | 1292-1630-1-ND |  | 0
> C312, C313 | 100pF, 50V | Capacitor_SMD:C_0603_1608Metric | 13-CC0603KPX7R9BB101CT-ND |  | 0
> D703-D705 | 1N4148 | Diode_SMD:D_SOD-123 | 1655-1360-1-ND |  | 0
> D201, D301-D303, D701, D702, D801 | LED | LED_SMD:LED_0402_1005Metric | 1830-IN-S42BCT-ND |  | 0
X201 | 13MHz | sub:831056290 | 1923-831056290CT-ND |  | 0
> R305, R308 | 50R | Resistor_SMD:R_0402_1005Metric | 2019-RN731ETTP50R0F50CT-ND |  | 0
J206 | JTAG | Connector_IDC:IDC-Header_2x10_P2.54mm_Vertical | 2057-BHR-20-VUA-ND |  | 0
> C310, C311 | 220nF,16V | Capacitor_SMD:C_0603_1608Metric | 311-1426-1-ND |  | 0
C709 | 6.8nF | Capacitor_SMD:C_0402_1005Metric | 311-1719-1-ND |  | 0
> C301-C303 | 10nF, 16V | Capacitor_SMD:C_0402_1005Metric | 311-3267-1-ND |  | 0
R208 | 8.06K, 1% | Resistor_SMD:R_0402_1005Metric | 311-8.06KLRCT-ND |  | 0
C708 | 1nF | Capacitor_SMD:C_0402_1005Metric | 445-4924-1-ND |  | 0
> C308, C309, C803 | 10uF | Capacitor_SMD:C_0805_2012Metric | 490-10517-1-ND |  | 0
> FB301, FB302 | FB | Resistor_SMD:R_0603_1608Metric | 490-5213-1-ND |  | 0
X202 | 25MHz | sub:ASFL1 | 535-10819-1-ND |  | 0
> R306, R307 | 2K | Resistor_SMD:R_2512_6332Metric | 541-2.0KXCT-ND |  | 0
R603 | 5.0K | Resistor_SMD:R_0402_1005Metric | 541-3972-1-ND | 0 | 0
R603 | 5.0K | Resistor_SMD:R_0402_1005Metric | 541-3972-1-ND |  | 0
R610 | 14.46K | Resistor_SMD:R_0402_1005Metric | 541-4465-1-ND |  | 0
> R607, R609 | 75K | Resistor_SMD:R_0402_1005Metric | 541-5078-1-ND |  | 0
L601 | 2.0uH | sub:NR8040 | 587-1997-1-ND | 0 | 0
L601 | 2.0uH | sub:NR8040 | 587-1997-1-ND |  | 0
L602 | 3.6uH | sub:NR8040 | 587-1998-1-ND |  | 0
L603 | 4.7uH | sub:NR8040 | 587-1999-1-ND |  | 0
FL301 | 2.2mH | Inductor_SMD:L_WE_SL5 | 732-1494-1-ND |  | 0
U703 | AOZ13984DI-02 | sub:DFN3x3-12L | 785-AOZ13984DI-02CT-ND |  | 0
U801 | RaspberryPi-CM3+L | Connector:Conn_TE-DDR2-SODIMM-0.6-200P-doublesided | A111047CT-ND | 0 | 0
> R201-R204, R501, R502, R712, R713 | 4.7K | Resistor_SMD:R_0402_1005Metric | A121542CT-ND |  | 0
R302 | 120R | Resistor_SMD:R_1206_3216Metric | A129799CT-ND | 0 | 0
U1102 | AP22814AW5 | Package_TO_SOT_SMD:SOT-23-5 | AP22804AW5-7DICT-ND | 0 | 0
U802 | AP22814AW5 | Package_TO_SOT_SMD:SOT-23-5 | AP22804AW5-7DICT-ND |  | 0
R604 | 4.07K | Resistor_SMD:R_0402_1005Metric | CR0402-FX-4021GLFCT-ND | 0 | 0
R604 | 4.07K | Resistor_SMD:R_0402_1005Metric | CR0402-FX-4021GLFCT-ND |  | 0
J301 | RS485 | Connector_Hirose:Hirose_DF13C_CL535-0402-2-51_1x02-1MP_P1.25mm_Vertical | H126391-ND |  | 0
> J701-J704 | PTC thermistor | Connector_Hirose:Hirose_DF13C_CL535-0402-2-51_1x02-1MP_P1.25mm_Vertical | H126391-ND |  | 0
J705 | water sensor0 | Connector_Hirose:Hirose_DF13C_CL535-0402-2-51_1x02-1MP_P1.25mm_Vertical | H126391-ND |  | 0
J706 | water sensor1 | Connector_Hirose:Hirose_DF13C_CL535-0402-2-51_1x02-1MP_P1.25mm_Vertical | H126391-ND |  | 0
J913 | LED | Connector_Hirose:Hirose_DF13C_CL535-0402-2-51_1x02-1MP_P1.25mm_Vertical | H126391-ND |  | 0
> J202, J203 | PTC thermistor | Connector_Hirose:Hirose_DF13C_CL535-0402-2-51_1x02-1MP_P1.25mm_Vertical | H126391-ND |  | 0
J204 | Fan | Connector_Hirose:Hirose_DF13C_CL535-0402-2-51_1x02-1MP_P1.25mm_Vertical | H126391-ND |  | 0
J301 | Ethernet | Connector_Hirose:Hirose_DF13C_CL535-0402-2-51_1x02-1MP_P1.25mm_Vertical | H126391-ND |  | 0
J401 | RS485 | Connector_Hirose:Hirose_DF13C_CL535-0402-2-51_1x02-1MP_P1.25mm_Vertical | H126391-ND |  | 0
SW701 | Power | Connector_Hirose:Hirose_DF13C_CL535-0402-2-51_1x02-1MP_P1.25mm_Vertical | H126391-ND |  | 0
J1201 | barometer | Connector_Hirose:Hirose_DF13C_CL535-0404-8-51_1x04-1MP_P1.25mm_Vertical | H126401-ND |  | 0
J1202 | lidar | Connector_Hirose:Hirose_DF13C_CL535-0404-8-51_1x04-1MP_P1.25mm_Vertical | H126401-ND |  | 0
J1401 | Raspberry_Pi | Module:MODULE_RASPBERRY_PI_3_MODEL_B+ | https://www.raspberrypi.org/documentation/hardware/raspberrypi/schematics/rpi_SCH_3bplus_1p0_reduced.pdf | 0 | 0
U702 | LTC2943 | Package_DFN_QFN:DFN-8-1EP_3x3mm_P0.5mm_EP1.66x2.38mm | LTC2943CDD#TRPBFCT-ND |  | 0
U301 | MAX22500E | Package_DFN_QFN:DFN-10-1EP_3x3mm_P0.5mm_EP1.55x2.48mm | MAX22500EATB+-ND | 0 | 0
U401 | MAX22500E | Package_DFN_QFN:DFN-10-1EP_3x3mm_P0.5mm_EP1.55x2.48mm | MAX22500EATB+-ND |  | 0
R602 | 30K | Resistor_SMD:R_0402_1005Metric | P30KJCT-ND | 0 | 0
R602 | 30K | Resistor_SMD:R_0402_1005Metric | P30KJCT-ND |  | 0
> R211, R309-R311 | 470R | Resistor_SMD:R_0402_1005Metric | P470LCT-ND |  | 0
> R503-R506, R804, R807-R810 | 1.8K | Resistor_SMD:R_0402_1005Metric | RMCF0402FT1K80CT-ND |  | 0
R608 | 24.32K | Resistor_SMD:R_0402_1005Metric | RMCF0402FT24K3CT-ND |  | 0
R401 | 40K | Resistor_SMD:R_0402_1005Metric | RMCF0402FT40K2CT-ND | 0 | 0
> R601, R605, R606, R714 | 100K | Resistor_SMD:R_0402_1005Metric | RMCS0402JT100KCT-ND |  | 0
U201 | USB3318 | sub:QFN-24-1EP_4x4mm_P0.5mm_EP2.6x2.6mm | USB3318-CP-TR |  | 0
> J802, J1103 | Cam0 | sub:Molex_200528-0150_1x15-1MP_P1.00mm_Horizontal | WM10967CT-ND | 0 | 0
> J804, J1105 | Cam1 | sub:Molex_200528-0150_1x15-1MP_P1.00mm_Horizontal | WM10967CT-ND |  | 0
> J502, J504, J803, J805 | Disp0 | sub:Molex_200528-0150_1x15-1MP_P1.00mm_Horizontal | WM10967CT-ND |  | 0
R706 | SOT | Resistor_SMD:R_0402_1005Metric | WSLP4026 |  | 0
> R205-R207, R702 | 10K | Resistor_SMD:R_0402_1005Metric | YAG1249CT-ND |  | 0
> R301-R304, R703, R704, R805, R806 | 2.2K | Resistor_SMD:R_0402_1005Metric | YAG3467CT-ND |  | 0
U1101 | Compute_Module_4_Connectors | Module:CM4 |  | 0 | 0
J901 | Raspberry_Pi_2_3 | Module:MODULE_RASPBERRY_PI_3_MODEL_B+ |  | 1 | 0
R707 | NIP | Resistor_SMD:R_0402_1005Metric |  | 1 | 0
U801 | Compute_Module_4_Connectors | Module:CM4 |  | 1 | 0
J901 | thruster_esc0 | Connector_PinHeader_2.54mm:PinHeader_1x03_P2.54mm_Vertical | S1012EC-36-ND | 1 | 1
J702 | Battery charge | Connector_JST:JST_XH_B3B-XH-AM_1x03_P2.50mm_Vertical | 455-2231-ND | 1 | 1
BZ201 | Buzzer | sub:CPI-1375-80T | 102-CPI-1375-80T-ND | 1 | 1
U1201 | MP3426 | Package_DFN_QFN:DFN-14-1EP_3x4mm_P0.5mm_EP1.7x3.3mm | 1589-1644-1-ND | 1 | 1
U204 | MP6513 | Package_TO_SOT_SMD:TSOT-23-6 | 1589-1709-1-ND | 1 | 1
U701 | MP2672A | sub:QFN-18 | 1589-MP2672AGD-0000-ZCT-ND | 1 | 1
U1205 | 74LVC2G17 | Package_TO_SOT_SMD:SOT-363_SC-70-6 | 1727-4122-1-ND | 1 | 1
F101 | 6A | sub:2920L | 18-2920L600/16MRCT-ND | 1 | 1
BT201 | Battery_Cell | sub:BH-49C-1-BK | 2057-BH-49C-1-BK-ND | 1 | 1
> J803, J1104, J1304 | Micro_SD_Card_Det | sub:MEM2061 | 2073-MEM2061-01-188-00-ACT-ND | 1 | 1
U701 | TLV4082 | Package_TO_SOT_SMD:SOT-23-6 | 296-TLV4082QDBVRQ1CT-ND | 1 | 1
Q1201 | 2N7002K | Package_TO_SOT_SMD:SOT-23 | 2N7002KCT-ND | 1 | 1
Y201 | Crystal_Small | sub:CMJ206T | 300-8189-1-ND | 1 | 1
L701 | 2.5uH, 5A | sub:CDRH8D38 | 308-2141-1-ND | 1 | 1
R1209 | 3K, 1/4W | Resistor_SMD:R_1206_3216Metric | 311-3.00KFRCT-ND | 1 | 1
D901 | RB720M-30 | Diode_SMD:SOD-923 | 3757-RB720M-30_R1_00001CT-ND | 1 | 1
C1212 | 100uF, 63V | sub:CP_MS10 | 399-A780MS107M1JLAS030CT-ND | 1 | 1
C1210 | 0.1uF, 63V | Capacitor_SMD:C_1206_3216Metric | 399-C1206C104MMREC7210CT-ND | 1 | 1
RL1201 | EA2-5NJ | sub:EA2-5NJ | 399-EA2-5NJ-ND | 1 | 1
L901 | 6.8uH, 1.5A | Inductor_SMD:L_TDK_VLS3012 | 445-175072-1-ND | 1 | 1
C1203 | 33nF | Capacitor_SMD:C_0402_1005Metric | 478-12621-1-ND | 1 | 1
T1201 | B78416A2232A003 | sub:XFRMR_B78416 | 495-6812-1-ND | 1 | 1
R701 | 28.7K | Resistor_SMD:R_0402_1005Metric | 541-28.7KLCT-ND | 1 | 1
C1215 | 330pF, 100V | Resistor_SMD:R_0805_2012Metric | 732-12232-1-ND | 1 | 1
L1201 | 13.3uH, 4A | sub:L_7447706150 | 732-7447706150CT-ND | 1 | 1
R1206 | 10R | Resistor_SMD:R_0603_1608Metric | A129664CT-ND | 1 | 1
U1202 | ADP165 | Package_TO_SOT_SMD:SOT-23-5 | ADP165AUJZ-3.3-R7CT-ND | 1 | 1
R711 | 0.01R | Resistor_SMD:R_0805_2012Metric | CRF0805-FZ-R010ELFCT-ND | 1 | 1
U203 | DS1338 | Package_SO:SOIC-8_3.9x4.9mm_P1.27mm | DS1338Z-3+CT-ND | 1 | 1
J1203 | Transducers | Connector_Hirose:Hirose_DF11-4DP-2DSA_2x02_P2.00mm_Vertical | H10229-ND | 1 | 1
U1302 | STM32F217IETx | Package_QFP:LQFP-176_24x24mm_P0.5mm | http://www.st.com/st-web-ui/static/active/en/resource/technical/document/datasheet/CD00263874.pdf | 1 | 1
U904 | LM3405A | sub:VSSOP-8_3.0x3.0mm_P0.65mm-EP | LM3405AXMY/NOPBCT-ND | 1 | 1
D902 | 30V, 1A | Diode_SMD:DO-219AD | MSS1P3L-M3/89AGICT-ND | 1 | 1
R902 | 0R2, 0.5W | Resistor_SMD:R_0805_2012Metric | P19315CT-ND | 1 | 1
R1204 | 276K | Resistor_SMD:R_0402_1005Metric | P274KLCT-ND | 1 | 1
R708 | 12.62K | Resistor_SMD:R_0402_1005Metric | RMCF0402FT12K7CT-ND | 1 | 1
R705 | 24K | Resistor_SMD:R_0402_1005Metric | RMCF0402FT24K0CT-ND | 1 | 1
R1202 | 66.5K | Resistor_SMD:R_0402_1005Metric | RMCF0402FT66K5CT-ND | 1 | 1
R710 | 40R, 1206 | Resistor_SMD:R_1206_3216Metric | RMCF1206FT40R2CT-ND | 1 | 1
R709 | 3.63K | Resistor_SMD:R_0402_1005Metric | RR05P3.6KDCT-ND | 1 | 1
D1201 | 50V,4A | Diode_SMD:D_SMC | SK55L-TPMSCT-ND | 1 | 1
U1204 | TUSS44x0 | sub:WQFN-20 | TUSS4470TRTJT | 1 | 1
> R402, R502 | 0m5 | Resistor_SMD:R_Shunt_Yaego_PU3921 | YAG6127CT-ND | 1 | 1
U201 | DP83TD510E | Package_DFN_QFN:TQFN-32-1EP_5x5mm_P0.5mm_EP2.1x2.1mm |  | 1 | 1
U202 | STM32F217IETx | Package_QFP:LQFP-176_24x24mm_P0.5mm |  | 1 | 1
U301 | DP83TD510E | Package_DFN_QFN:TQFN-32-1EP_5x5mm_P0.5mm_EP2.1x2.1mm |  | 1 | 1
X1301 | 13MHz | sub:831056290 | 1923-831056290CT-ND | 2 | 2
J1303 | JTAG | Connector_IDC:IDC-Header_2x10_P2.54mm_Vertical | 2057-BHR-20-VUA-ND | 2 | 2
R1301 | 8.06K, 1% | Resistor_SMD:R_0402_1005Metric | 311-8.06KLRCT-ND | 2 | 2
> C1205, C1219 | 10uF, 63V, X7R | Capacitor_SMD:C_1210_3225Metric | 490-9971-1-ND | 2 | 2
X1302 | 25MHz | sub:ASFL1 | 535-10819-1-ND | 2 | 2
R610 | 14.46K | Resistor_SMD:R_0402_1005Metric | 541-4465-1-ND | 2 | 2
L602 | 3.6uH | sub:NR8040 | 587-1998-1-ND | 2 | 2
L603 | 4.7uH | sub:NR8040 | 587-1999-1-ND | 2 | 2
FL201 | 2.2mH | Inductor_SMD:L_WE_SL5 | 732-1494-1-ND | 2 | 2
U1203 | AOZ13984DI-02 | sub:DFN-12-1EP_3x3mm_P0.5mm_EP1.5x2.5mm | 785-AOZ13984DI-02CT-ND | 2 | 2
> F1201, F1202 | 3A | sub:2016 | F8539CT-ND | 2 | 2
 | LED |  | 1672-1161-ND | 2 | 2
J1001 | Raspberry_Pi | Module:Raspberry_Pi_Zero_Socketed_THT_MountingHoles_SMT | S5690-ND | 2 | 2
> R705, R707 | 1.0M | Resistor_SMD:R_0402_1005Metric | RMCF0402FT1M00CT-ND | 2 | 2
R608 | 24.32K | Resistor_SMD:R_0402_1005Metric | RMCF0402FT24K3CT-ND | 2 | 2
> R301, R1203 | 40K | Resistor_SMD:R_0402_1005Metric | RMCF0402FT40R2CT-ND | 2 | 2
U1301 | USB3318 | sub:QFN-24-1EP_4x4mm_P0.5mm_EP2.6x2.6mm | USB3318-CP-TR | 2 | 2
> U901-U903 | 74HCT125 | Package_SO:SO-14_3.9x8.65mm_P1.27mm | 1727-2834-1-ND | 3 | 3
> C1204, C1213 | 6.8nF | Capacitor_SMD:C_0402_1005Metric | 311-1719-1-ND | 3 | 3
> C1207, C1209 | 1nF | Capacitor_SMD:C_0402_1005Metric | 445-4924-1-ND | 3 | 3
J707 | IMU | Connector_Hirose:Hirose_DF13C_CL535-0404-8-51_1x04-1MP_P1.25mm_Vertical | H126401-ND | 3 | 3
> U401, U501 | LTC2943 | Package_DFN_QFN:DFN-8-1EP_3x3mm_P0.5mm_EP1.66x2.38mm | LTC2943CDD#TRPBFCT-ND | 3 | 3
> C212, C213 | 100pF, 50V | Capacitor_SMD:C_0603_1608Metric | 13-CC0603KPX7R9BB101CT-ND | 4 | 4
> JY201-JY204 | joystick | sub:XDCR_COM-09032 | 1568-1526-ND | 4 | 4
D1202 | 1N4148 | Diode_SMD:D_SOD-123 | 1655-1360-1-ND | 4 | 4
> R205, R208 | 50R | Resistor_SMD:R_0402_1005Metric | 2019-RN731ETTP50R0F50CT-ND | 4 | 4
> C210, C211 | 220nF,16V | Capacitor_SMD:C_0603_1608Metric | 311-1426-1-ND | 4 | 4
> C208, C209, C1101 | 10uF | Capacitor_SMD:C_0805_2012Metric | 490-10517-1-ND | 4 | 4
> FB201, FB202 | FB | Resistor_SMD:R_0603_1608Metric | 490-5213-1-ND | 4 | 4
> R206, R207 | 2K | Resistor_SMD:R_2512_6332Metric | 541-2.0KXCT-ND | 4 | 4
> R607, R609 | 75K | Resistor_SMD:R_0402_1005Metric | 541-5078-1-ND | 4 | 4
 | Thermistor |  | 490-18143-1-ND | 4 | 4
> J801, J1102, J1301, J1302 | USB_B_Micro | Connector_USB:USB_Micro-B_Wuerth_629105150521 | 732-5960-1-ND | 5 | 5
> U601-U603 | RT7263A | sub:SOP-EP-8_3.9x4.9mm_P1.27mm | 1028-1217-1-ND | 6 | 6
> R601, R605, R606 | 100K | Resistor_SMD:R_0402_1005Metric | RMCS0402JT100KCT-ND | 6 | 6
> C201-C203, C909 | 10nF, 16V | Capacitor_SMD:C_0402_1005Metric | 311-3267-1-ND | 7 | 7
> C1316, C1321, C1322, C1326 | 2.2uF | Capacitor_SMD:C_0603_1608Metric | 1276-1134-1-ND | 8 | 8
> C223, C224, C226-C231 | SOT | Capacitor_SMD:C_0402_1005Metric |  | 8 | 8
> R706, R708-R710, R1102, R1213 | 1.0K | Resistor_SMD:R_0402_1005Metric | 118-CR0402AFX-1001GLFCT-ND | 9 | 9
> R803-R806, R1104, R1106, R1108-R1110 | 1.8K | Resistor_SMD:R_0402_1005Metric | RMCF0402FT1K80CT-ND | 9 | 9
> C604, C605, C612-C615 | 22uF | Capacitor_SMD:C_1210_3225Metric | 1276-1851-1-ND | 10 | 10
> C401, C501, C701-C704, C910, C911, C1102, C1323 | 1.0uF, 16V | Capacitor_SMD:C_0603_1608Metric | 1276-6524-1-ND | 10 | 10
> D201-D203, D1101, D1301 | LED | LED_SMD:LED_0402_1005Metric | 1830-IN-S42BCT-ND | 10 | 10
> R209-R211, R1210, R1212, R1302 | 470R | Resistor_SMD:R_0402_1005Metric | P470LCT-ND | 10 | 10
> R201-R204, R1105, R1107 | 2.2K | Resistor_SMD:R_0402_1005Metric | YAG3467CT-ND | 10 | 10
> R701-R704, R901, R1205, R1303 | 10K | Resistor_SMD:R_0402_1005Metric | YAG1249CT-ND | 11 | 11
> C601, C606, C607, C616-C618, C907, C1201, C1218 | 10uF,25V | Capacitor_SMD:C_1206_3216Metric | 1276-1181-1-ND | 12 | 12
J201 | Ethernet | Connector_Hirose:Hirose_DF13C_CL535-0402-2-51_1x02-1MP_P1.25mm_Vertical | H126391-ND | 12 | 12
> R101-R104, R401, R501, R801, R802, R1201 | 4.7K | Resistor_SMD:R_0402_1005Metric | A121542CT-ND | 17 | 17
> C206, C207, C303, C705, C801, C901, C902, C905, C1206, C1208, C1302, C1304, C1306, C1308, C1330 | 4.7uF | Capacitor_SMD:C_0603_1608Metric | 1276-1044-1-ND | 20 | 20
> C204, C205, C301, C302, C602, C603, C608-C611, C706, C903, C904, C906, C1103, C1202, C1301, C1303, C1305, C1307, C1309-C1315, C1317-C1320, C1324, C1325, C1327-C1329 | 0.1uF | Capacitor_SMD:C_0402_1005Metric | 1292-1630-1-ND | 64 | 64
 |  |  |  |  | Digikey
> J503, J804 | Micro_SD_Card_Det | sub:MEM2061 | 2073-MEM2061-01-188-00-ACT-ND
> J201, J205, J501, J701, J802 | USB_B_Micro | Connector_USB:USB_Micro-B_Wuerth_629105150521 | 732-5960-1-ND
U501 | MCU_Module:RaspberryPi-CM3+L | Connector:Conn_TE-DDR2-SODIMM-0.6-200P-doublesided | A111047CT-ND
R402 | 120R | Resistor_SMD:R_1206_3216Metric | A129799CT-ND

Sheet: Digikey
C1203 | 33nF | Capacitor_SMD:C_0402_1005Metric | 1 | 478-12621-1-ND
> C1204, C1213 | 6.8nF | Capacitor_SMD:C_0402_1005Metric | 3 | 311-1719-1-ND
> C1207, C1209 | 1nF | Capacitor_SMD:C_0402_1005Metric | 3 | 445-4924-1-ND
> C201-C203, C909 | 10nF, 16V | Capacitor_SMD:C_0402_1005Metric | 7 | 311-3267-1-ND
> C204, C205, C301, C302, C602, C603, C608-C611, C706, C903, C904, C906, C1103, C1202, C1301, C1303, C1305, C1307, C1309-C1315, C1317-C1320, C1324, C1325, C1327-C1329 | 0.1uF | Capacitor_SMD:C_0402_1005Metric | 64 | 1292-1630-1-ND
> C212, C213 | 100pF, 50V | Capacitor_SMD:C_0603_1608Metric | 4 | 13-CC0603KPX7R9BB101CT-ND
> C210, C211 | 220nF,16V | Capacitor_SMD:C_0603_1608Metric | 4 | 311-1426-1-ND
> C1316, C1321, C1322, C1326 | 2.2uF | Capacitor_SMD:C_0603_1608Metric | 8 | 1276-1134-1-ND
> C401, C501, C701-C704, C910, C911, C1102, C1323 | 1.0uF, 16V | Capacitor_SMD:C_0603_1608Metric | 10 | 1276-6524-1-ND
> C206, C207, C303, C705, C801, C901, C902, C905, C1206, C1208, C1302, C1304, C1306, C1308, C1330 | 4.7uF | Capacitor_SMD:C_0603_1608Metric | 20 | 1276-1044-1-ND
> C208, C209, C1101 | 10uF | Capacitor_SMD:C_0805_2012Metric | 4 | 490-10517-1-ND
C1210 | 0.1uF, 63V | Capacitor_SMD:C_1206_3216Metric | 1 | 399-C1206C104MMREC7210CT-ND
> C601, C606, C607, C616-C618, C907, C1201, C1218 | 10uF,25V | Capacitor_SMD:C_1206_3216Metric | 12 | 1276-1181-1-ND
> C1205, C1219 | 10uF, 63V, X7R | Capacitor_SMD:C_1210_3225Metric | 2 | 490-9971-1-ND
> C604, C605, C612-C615 | 22uF | Capacitor_SMD:C_1210_3225Metric | 10 | 1276-1851-1-ND
J1203 | Transducers | Connector_Hirose:Hirose_DF11-4DP-2DSA_2x02_P2.00mm_Vertical | 1 | H10229-ND
J201 | Ethernet | Connector_Hirose:Hirose_DF13C_CL535-0402-2-51_1x02-1MP_P1.25mm_Vertical | 12 | H126391-ND
J707 | IMU | Connector_Hirose:Hirose_DF13C_CL535-0404-8-51_1x04-1MP_P1.25mm_Vertical | 3 | H126401-ND
J1303 | JTAG | Connector_IDC:IDC-Header_2x10_P2.54mm_Vertical | 2 | 2057-BHR-20-VUA-ND
J702 | Battery charge | Connector_JST:JST_XH_B3B-XH-AM_1x03_P2.50mm_Vertical | 1 | 455-2231-ND
J901 | thruster_esc0 | Connector_PinHeader_2.54mm:PinHeader_1x03_P2.54mm_Vertical | 1 | S1012EC-36-ND
> J801, J1102, J1301, J1302 | USB_B_Micro | Connector_USB:USB_Micro-B_Wuerth_629105150521 | 5 | 732-5960-1-ND
D1201 | 50V,4A | Diode_SMD:D_SMC | 1 | SK55L-TPMSCT-ND
D1202 | 1N4148 | Diode_SMD:D_SOD-123 | 4 | 1655-1360-1-ND
D902 | 30V, 1A | Diode_SMD:DO-219AD | 1 | MSS1P3L-M3/89AGICT-ND
D901 | RB720M-30 | Diode_SMD:SOD-923 | 1 | 3757-RB720M-30_R1_00001CT-ND
L901 | 6.8uH, 1.5A | Inductor_SMD:L_TDK_VLS3012 | 1 | 445-175072-1-ND
FL201 | 2.2mH | Inductor_SMD:L_WE_SL5 | 2 | 732-1494-1-ND
> D201-D203, D1101, D1301 | LED | LED_SMD:LED_0402_1005Metric | 10 | 1830-IN-S42BCT-ND
J1001 | Raspberry_Pi | Module:Raspberry_Pi_Zero_Socketed_THT_MountingHoles_SMT | 2 | S5690-ND
U1201 | MP3426 | Package_DFN_QFN:DFN-14-1EP_3x4mm_P0.5mm_EP1.7x3.3mm | 1 | 1589-1644-1-ND
> U401, U501 | LTC2943 | Package_DFN_QFN:DFN-8-1EP_3x3mm_P0.5mm_EP1.66x2.38mm | 3 | LTC2943CDD#TRPBFCT-ND
> U901-U903 | 74HCT125 | Package_SO:SO-14_3.9x8.65mm_P1.27mm | 3 | 1727-2834-1-ND
U203 | DS1338 | Package_SO:SOIC-8_3.9x4.9mm_P1.27mm | 1 | DS1338Z-3+CT-ND
Q1201 | 2N7002K | Package_TO_SOT_SMD:SOT-23 | 1 | 2N7002KCT-ND
U1202 | ADP165 | Package_TO_SOT_SMD:SOT-23-5 | 1 | ADP165AUJZ-3.3-R7CT-ND
U701 | TLV4082 | Package_TO_SOT_SMD:SOT-23-6 | 1 | 296-TLV4082QDBVRQ1CT-ND
U1205 | 74LVC2G17 | Package_TO_SOT_SMD:SOT-363_SC-70-6 | 1 | 1727-4122-1-ND
U204 | MP6513 | Package_TO_SOT_SMD:TSOT-23-6 | 1 | 1589-1709-1-ND
R701 | 28.7K | Resistor_SMD:R_0402_1005Metric | 1 | 541-28.7KLCT-ND
R1204 | 276K | Resistor_SMD:R_0402_1005Metric | 1 | P274KLCT-ND
R708 | 12.62K | Resistor_SMD:R_0402_1005Metric | 1 | RMCF0402FT12K7CT-ND
R705 | 24K | Resistor_SMD:R_0402_1005Metric | 1 | RMCF0402FT24K0CT-ND
R1202 | 66.5K | Resistor_SMD:R_0402_1005Metric | 1 | RMCF0402FT66K5CT-ND
R709 | 3.63K | Resistor_SMD:R_0402_1005Metric | 1 | RR05P3.6KDCT-ND
R1301 | 8.06K, 1% | Resistor_SMD:R_0402_1005Metric | 2 | 311-8.06KLRCT-ND
R610 | 14.46K | Resistor_SMD:R_0402_1005Metric | 2 | 541-4465-1-ND
> R705, R707 | 1.0M | Resistor_SMD:R_0402_1005Metric | 2 | RMCF0402FT1M00CT-ND
R608 | 24.32K | Resistor_SMD:R_0402_1005Metric | 2 | RMCF0402FT24K3CT-ND
> R301, R1203 | 40K | Resistor_SMD:R_0402_1005Metric | 2 | RMCF0402FT40R2CT-ND
> R205, R208 | 50R | Resistor_SMD:R_0402_1005Metric | 4 | 2019-RN731ETTP50R0F50CT-ND
> R607, R609 | 75K | Resistor_SMD:R_0402_1005Metric | 4 | 541-5078-1-ND
> R601, R605, R606 | 100K | Resistor_SMD:R_0402_1005Metric | 6 | RMCS0402JT100KCT-ND
> R706, R708-R710, R1102, R1213 | 1.0K | Resistor_SMD:R_0402_1005Metric | 9 | 118-CR0402AFX-1001GLFCT-ND
> R803-R806, R1104, R1106, R1108-R1110 | 1.8K | Resistor_SMD:R_0402_1005Metric | 9 | RMCF0402FT1K80CT-ND
> R209-R211, R1210, R1212, R1302 | 470R | Resistor_SMD:R_0402_1005Metric | 10 | P470LCT-ND
> R201-R204, R1105, R1107 | 2.2K | Resistor_SMD:R_0402_1005Metric | 10 | YAG3467CT-ND
> R701-R704, R901, R1205, R1303 | 10K | Resistor_SMD:R_0402_1005Metric | 11 | YAG1249CT-ND
> R101-R104, R401, R501, R801, R802, R1201 | 4.7K | Resistor_SMD:R_0402_1005Metric | 17 | A121542CT-ND
R1206 | 10R | Resistor_SMD:R_0603_1608Metric | 1 | A129664CT-ND
> FB201, FB202 | FB | Resistor_SMD:R_0603_1608Metric | 4 | 490-5213-1-ND
C1215 | 330pF, 100V | Resistor_SMD:R_0805_2012Metric | 1 | 732-12232-1-ND
R711 | 0.01R | Resistor_SMD:R_0805_2012Metric | 1 | CRF0805-FZ-R010ELFCT-ND
R902 | 0R2, 0.5W | Resistor_SMD:R_0805_2012Metric | 1 | P19315CT-ND
R1209 | 3K, 1/4W | Resistor_SMD:R_1206_3216Metric | 1 | 311-3.00KFRCT-ND
R710 | 40R, 1206 | Resistor_SMD:R_1206_3216Metric | 1 | RMCF1206FT40R2CT-ND
> R206, R207 | 2K | Resistor_SMD:R_2512_6332Metric | 4 | 541-2.0KXCT-ND
> R402, R502 | 0m5 | Resistor_SMD:R_Shunt_Yaego_PU3921 | 1 | YAG6127CT-ND
> F1201, F1202 | 3A | sub:2016 | 2 | F8539CT-ND
F101 | 6A | sub:2920L | 1 | 18-2920L600/16MRCT-ND
X1301 | 13MHz | sub:831056290 | 2 | 1923-831056290CT-ND
X1302 | 25MHz | sub:ASFL1 | 2 | 535-10819-1-ND
BT201 | Battery_Cell | sub:BH-49C-1-BK | 1 | 2057-BH-49C-1-BK-ND
L701 | 2.5uH, 5A | sub:CDRH8D38 | 1 | 308-2141-1-ND
Y201 | Crystal_Small | sub:CMJ206T | 1 | 300-8189-1-ND
C1212 | 100uF, 63V | sub:CP_MS10 | 1 | 399-A780MS107M1JLAS030CT-ND
BZ201 | Buzzer | sub:CPI-1375-80T | 1 | 102-CPI-1375-80T-ND
U1203 | AOZ13984DI-02 | sub:DFN-12-1EP_3x3mm_P0.5mm_EP1.5x2.5mm | 2 | 785-AOZ13984DI-02CT-ND
RL1201 | EA2-5NJ | sub:EA2-5NJ | 1 | 399-EA2-5NJ-ND
L1201 | 13.3uH, 4A | sub:L_7447706150 | 1 | 732-7447706150CT-ND
> J803, J1104, J1304 | Micro_SD_Card_Det | sub:MEM2061 | 1 | 2073-MEM2061-01-188-00-ACT-ND
L602 | 3.6uH | sub:NR8040 | 2 | 587-1998-1-ND
L603 | 4.7uH | sub:NR8040 | 2 | 587-1999-1-ND
U701 | MP2672A | sub:QFN-18 | 1 | 1589-MP2672AGD-0000-ZCT-ND
U1301 | USB3318 | sub:QFN-24-1EP_4x4mm_P0.5mm_EP2.6x2.6mm | 2 | USB3318-CP-TR
> U601-U603 | RT7263A | sub:SOP-EP-8_3.9x4.9mm_P1.27mm | 6 | 1028-1217-1-ND
U904 | LM3405A | sub:VSSOP-8_3.0x3.0mm_P0.65mm-EP | 1 | LM3405AXMY/NOPBCT-ND
U1204 | TUSS44x0 | sub:WQFN-20 | 1 | TUSS4470TRTJT
> JY201-JY204 | joystick | sub:XDCR_COM-09032 | 4 | 1568-1526-ND
T1201 | B78416A2232A003 | sub:XFRMR_B78416 | 1 | 495-6812-1-ND
 | LED |  | 2 | 1672-1161-ND
 | Thermistor |  | 4 | 490-18143-1-ND
