highpeng/sub/electrical/base board 5.99/base board.kicad_pcb

## KiCad design electrical/base board 5.99/base board.kicad_pcb (2021-10-24)

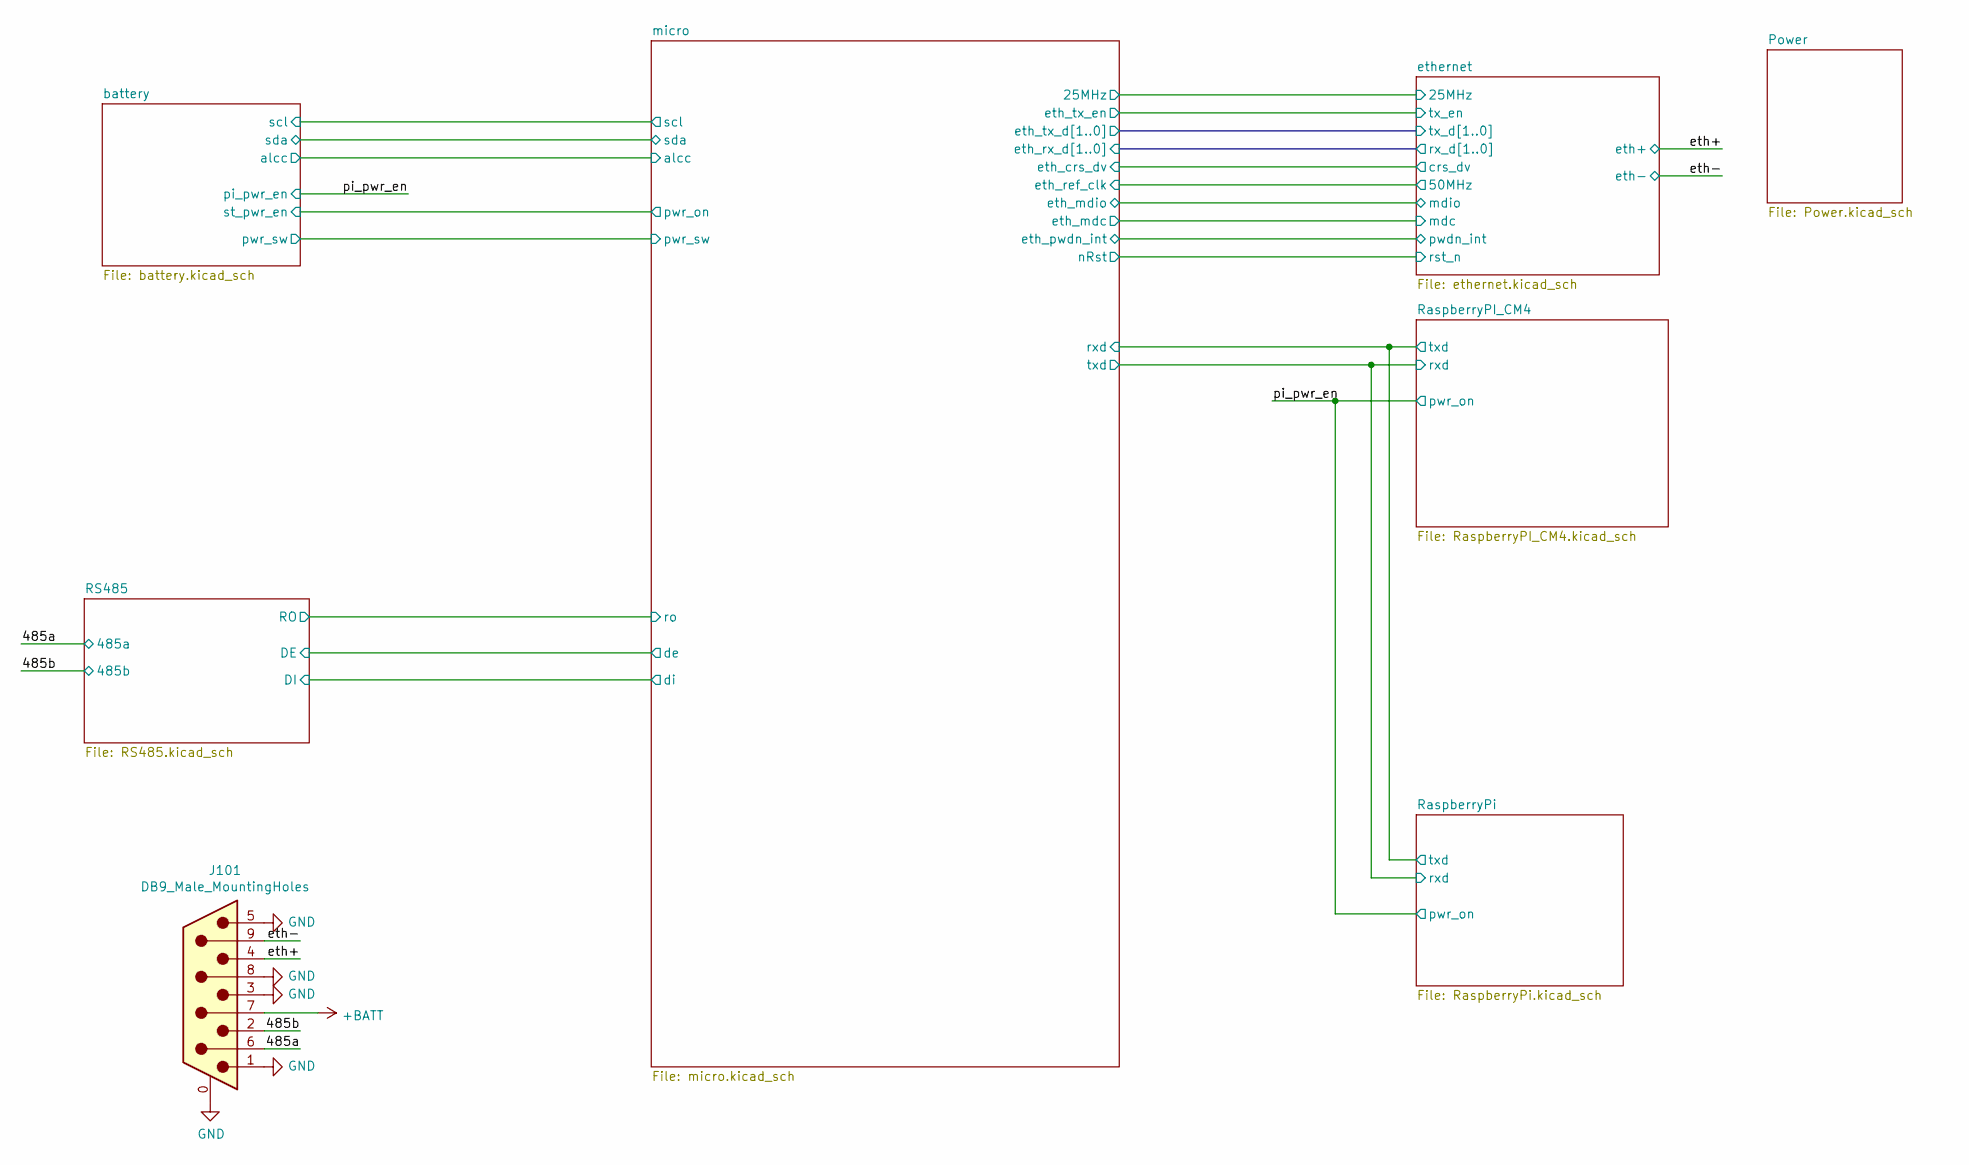
[picture p1: schematic base board.kicad_sch]

Parts:
J101: DB9_Male_MountingHoles; DSUB-9_Male_Horizontal_P2.77x2.84mm_EdgePinOffset9.90mm_Hou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

Connections:
+BATT: J101.7; also elsewhere on the board
/485a: J101.6; also elsewhere on the board
/485b: J101.2; also elsewhere on the board
/eth+: J101.4; also elsewhere on the board
/eth-: J101.9; also elsewhere on the board
GND: J101.0 (PAD), J101.1, J101.3, J101.5, J101.8; also elsewhere on the board

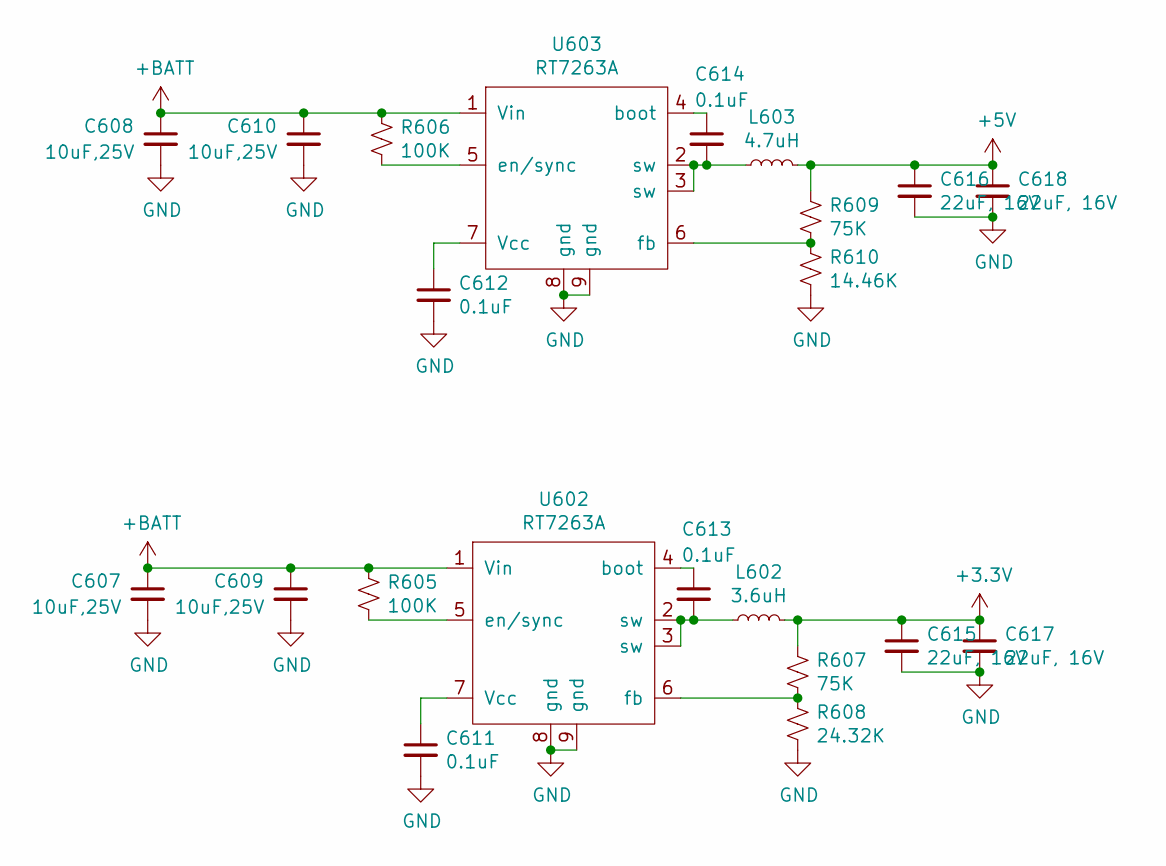
[picture p2: schematic Power.kicad_sch]

Parts:
C607, C608, C609, C610: 10uF,25V; C_1206_3216Metric
C611, C612, C613, C614: 0.1uF; C_0402_1005Metric
C615, C616, C617, C618: 22uF, 16V; C_1210_3225Metric
L602: 3.6uH; NR8040
L603: 4.7uH; NR8040
R605, R606: 100K; R_0402_1005Metric
R607, R609: 75K; R_0402_1005Metric
R608: 24.32K; R_0402_1005Metric
R610: 14.46K; R_0402_1005Metric
U602, U603: RT7263A; SOP-EP-8_3.9x4.9mm_P1.27mm

Connections:
+3V3: C615.1, C617.1, L602.2, R607.1; also elsewhere on the board
+5V: C616.1, C618.1, L603.2, R609.1; also elsewhere on the board
+BATT: C607.1, C608.1, C609.1, C610.1, R605.1, R606.1, U602.1 (Vin), U603.1 (Vin); also elsewhere on the board
GND: C607.2, C608.2, C609.2, C610.2, C611.2, C612.2, C615.2, C616.2, C617.2, C618.2, R608.2, R610.2, U602.8 (gnd), U602.9 (gnd), U603.8 (gnd), U603.9 (gnd); also elsewhere on the board
unnamed: C611.1, U602.7 (Vcc)
unnamed: C612.1, U603.7 (Vcc)
unnamed: C613.1, U602.4 (boot)
unnamed: C613.2, L602.1, U602.2 (sw), U602.3 (sw)
unnamed: C614.1, U603.4 (boot)
unnamed: C614.2, L603.1, U603.2 (sw), U603.3 (sw)
unnamed: R605.2, U602.5 (en/sync)
unnamed: R606.2, U603.5 (en/sync)
unnamed: R607.2, R608.1, U602.6 (fb)
unnamed: R609.2, R610.1, U603.6 (fb)

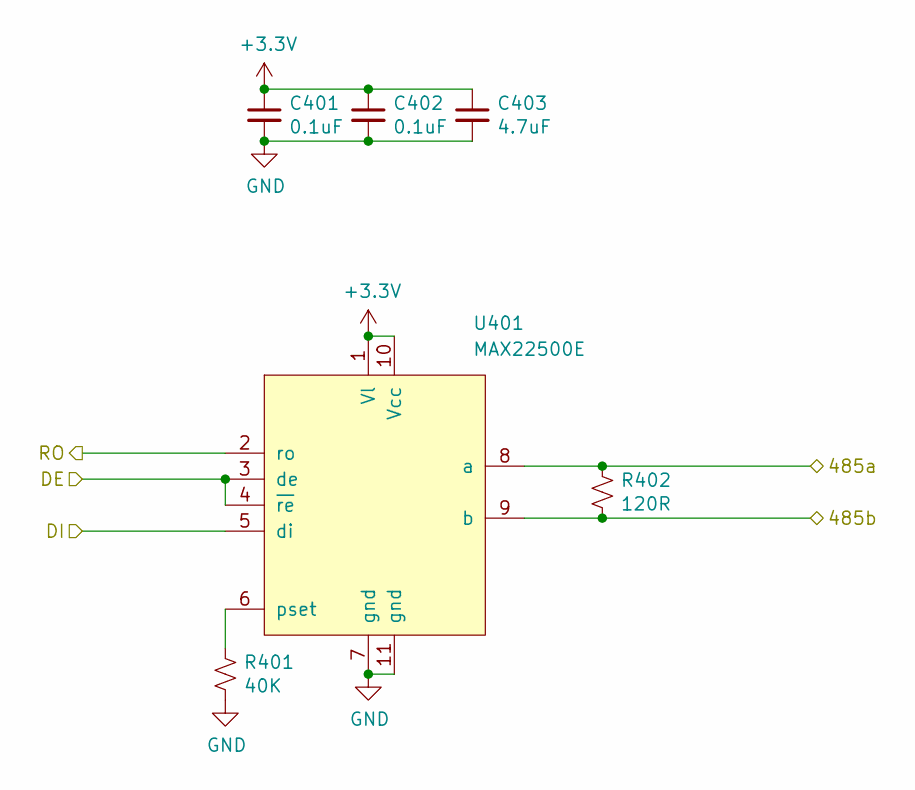
[picture p3: schematic RS485.kicad_sch]

Parts:
C401, C402: 0.1uF; C_0402_1005Metric
C403: 4.7uF; C_0603_1608Metric
R401: 40K; R_0402_1005Metric
R402: 120R; R_1206_3216Metric
U401: MAX22500E; DFN-10-1EP_3x3mm_P0.5mm_EP1.55x2.48mm

Connections:
+3V3: C401.1, C402.1, C403.1, U401.1 (Vl), U401.10 (Vcc); also elsewhere on the board
/485a: R402.1, U401.8 (a); also elsewhere on the board
/485b: R402.2, U401.9 (b); also elsewhere on the board
/RS485/DE: U401.3 (de~), U401.4 (~re); also elsewhere on the board
/RS485/DI: U401.5 (di); also elsewhere on the board
/RS485/RO: U401.2 (ro); also elsewhere on the board
GND: C401.2, C402.2, C403.2, R401.2, U401.7 (gnd), U401.11 (gnd); also elsewhere on the board
unnamed: R401.1, U401.6 (pset)

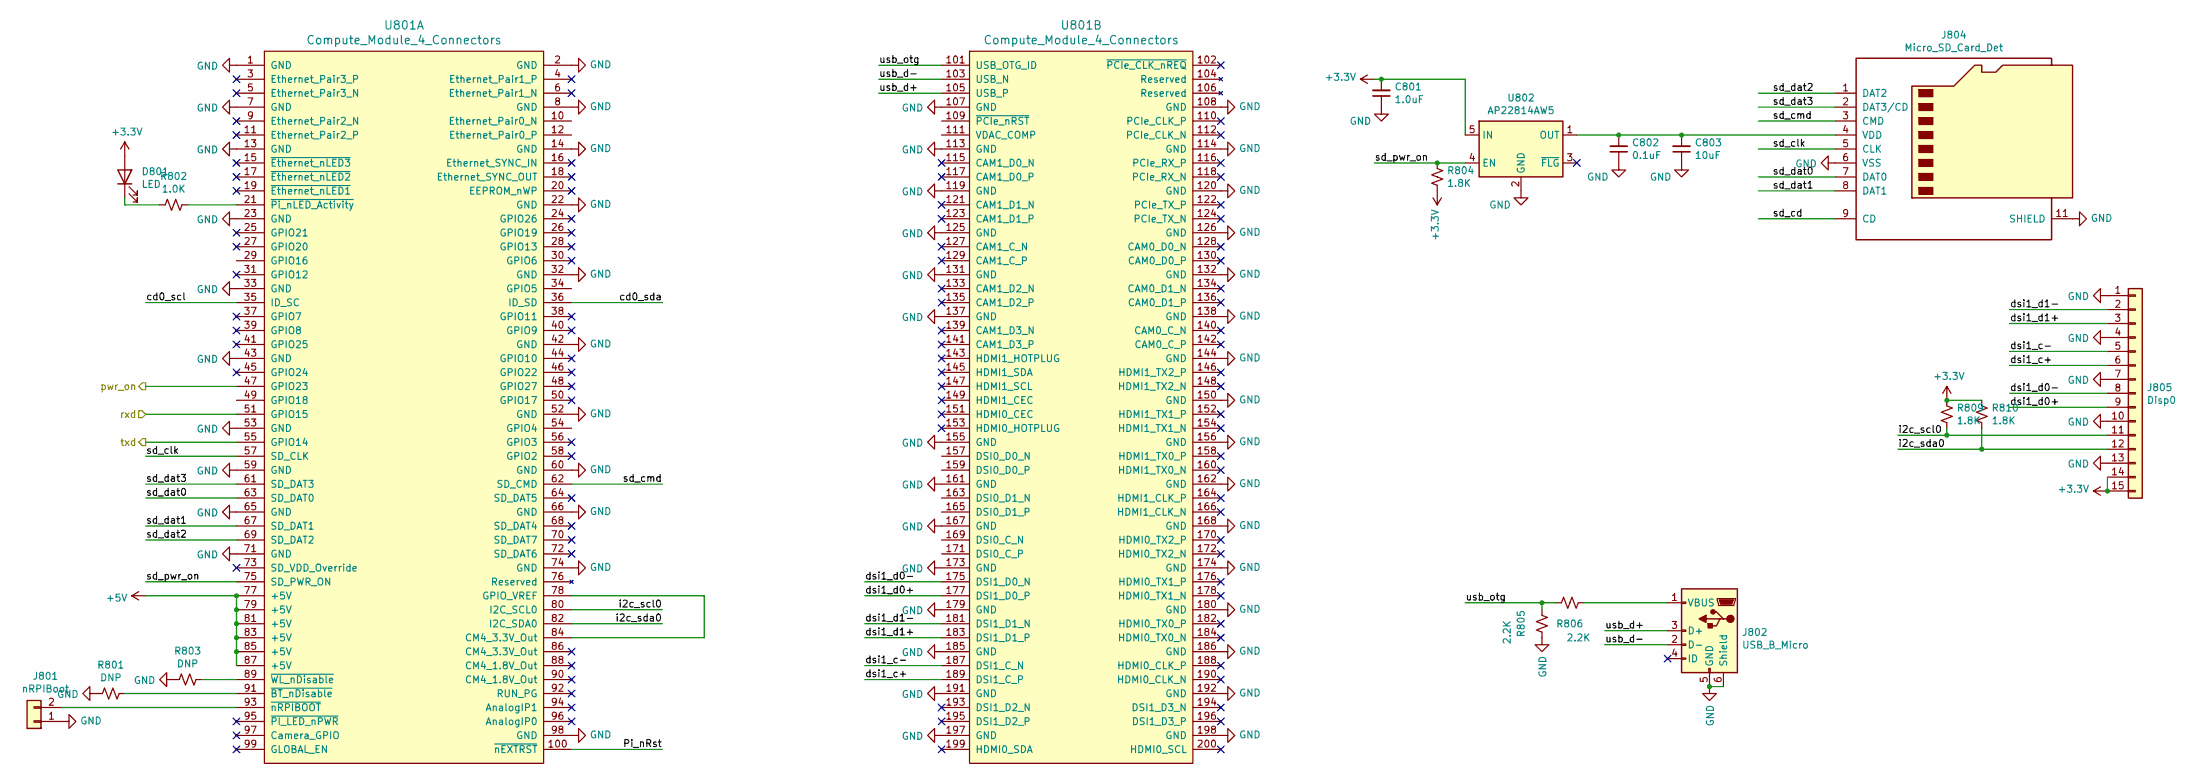
[picture p4: schematic RaspberryPI_CM4.kicad_sch]

Parts:
C801: 1.0uF; C_0603_1608Metric
C802: 0.1uF; C_0402_1005Metric
C803: 10uF; C_0805_2012Metric
D801: LED; LED_0402_1005Metric
J801: nRPIBoot; PinHeader_1x02_P1.27mm_Vertical
J802: USB_B_Micro; USB_Micro-B_Wuerth_629105150521
J804: Micro_SD_Card_Det; MEM2061
J805: Disp0; Molex_200528-0150_1x15-1MP_P1.00mm_Horizontal
R801, R803: DNP; R_0402_1005Metric
R802: 1.0K; R_0402_1005Metric
R804, R809, R810: 1.8K; R_0402_1005Metric
R805, R806: 2.2K; R_0402_1005Metric
U801: Compute_Module_4_Connectors; CM4
U802: AP22814AW5; SOT-23-5

Connections:
+3V3: C801.2, D801.2 (A), J805.14, J805.15, R804.2, R809.1, R810.1, U802.5 (IN); also elsewhere on the board
+5V: U801.77 (+5V), U801.79 (+5V), U801.81 (+5V), U801.83 (+5V), U801.85 (+5V), U801.87 (+5V); also elsewhere on the board
/RaspberryPI_CM4/Pi_nRst: U801.100 (~nEXTRST)
/RaspberryPI_CM4/cd0_scl: U801.35 (ID_SC)
/RaspberryPI_CM4/cd0_sda: U801.36 (ID_SD)
/RaspberryPI_CM4/dsi1_c+: J805.6, U801.189 (DSI1_C_P)
/RaspberryPI_CM4/dsi1_c-: J805.5, U801.187 (DSI1_C_N)
/RaspberryPI_CM4/dsi1_d0+: J805.9, U801.177 (DSI1_D0_P)
/RaspberryPI_CM4/dsi1_d0-: J805.8, U801.175 (DSI1_D0_N)
/RaspberryPI_CM4/dsi1_d1+: J805.3, U801.183 (DSI1_D1_P)
/RaspberryPI_CM4/dsi1_d1-: J805.2, U801.181 (DSI1_D1_N)
/RaspberryPI_CM4/i2c_scl0: J805.11, R809.2, U801.80 (I2C_SCL0)
/RaspberryPI_CM4/i2c_sda0: J805.12, R810.2, U801.82 (I2C_SDA0)
/RaspberryPI_CM4/rxd: U801.51 (GPIO15); also elsewhere on the board
/RaspberryPI_CM4/sd_cd: J804.9 (CD)
/RaspberryPI_CM4/sd_clk: J804.5 (CLK), U801.57 (SD_CLK)
/RaspberryPI_CM4/sd_cmd: J804.3 (CMD), U801.62 (SD_CMD)
/RaspberryPI_CM4/sd_dat0: J804.7 (DAT0), U801.63 (SD_DAT0)
/RaspberryPI_CM4/sd_dat1: J804.8 (DAT1), U801.67 (SD_DAT1)
/RaspberryPI_CM4/sd_dat2: J804.1 (DAT2), U801.69 (SD_DAT2)
/RaspberryPI_CM4/sd_dat3: J804.2 (DAT3/CD), U801.61 (SD_DAT3)
/RaspberryPI_CM4/sd_pwr_on: R804.1, U801.75 (SD_PWR_ON), U802.4 (EN)
/RaspberryPI_CM4/txd: U801.55 (GPIO14); also elsewhere on the board
/RaspberryPI_CM4/usb_d+: J802.3 (D+), U801.105 (USB_P)
/RaspberryPI_CM4/usb_d-: J802.2 (D-), U801.103 (USB_N)
/RaspberryPI_CM4/usb_otg: R805.1, R806.1, U801.101 (USB_OTG_ID)
/pi_pwr_en: U801.47 (GPIO23); also elsewhere on the board
GND: C801.1, C802.1, C803.1, J801.1, J802.5 (GND), J802.6 (Shield), J804.6 (VSS), J804.11 (SHIELD), J805.1, J805.4, J805.7, J805.10, J805.13, R801.2, R803.2, R805.2, U801.1 (GND), U801.2 (GND), U801.7 (GND), U801.8 (GND), U801.13 (GND), U801.14 (GND), U801.22 (GND), U801.23 (GND), U801.32 (GND), U801.33 (GND), U801.42 (GND), U801.43 (GND), U801.52 (GND), U801.53 (GND), U801.59 (GND), U801.60 (GND), U801.65 (GND), U801.66 (GND), U801.71 (GND), U801.74 (GND), U801.98 (GND), U801.107 (GND), U801.108 (GND), U801.113 (GND), U801.114 (GND), U801.119 (GND), U801.120 (GND), U801.125 (GND), U801.126 (GND), U801.131 (GND), U801.132 (GND), U801.137 (GND), U801.138 (GND), U801.144 (GND), U801.150 (GND), U801.155 (GND), U801.156 (GND), U801.161 (GND), U801.162 (GND), U801.167 (GND), U801.168 (GND), U801.173 (GND), U801.174 (GND), U801.179 (GND), U801.180 (GND), U801.185 (GND), U801.186 (GND), U801.191 (GND), U801.192 (GND), U801.197 (GND), U801.198 (GND), U802.2 (GND); also elsewhere on the board
unnamed: C802.2, C803.2, J804.4 (VDD), U802.1 (OUT)
unnamed: D801.1 (K), R802.2
unnamed: J801.2, U801.93 (~nRPIBOOT)
unnamed: J802.1 (VBUS), R806.2
unnamed: R801.1, U801.91 (~BT_nDisable)
unnamed: R802.1, U801.21 (~Pi_nLED_Activity)
unnamed: R803.1, U801.89 (~WL_nDisable)
unnamed: U801.78 (GPIO_VREF), U801.84 (CM4_3.3V_Out)

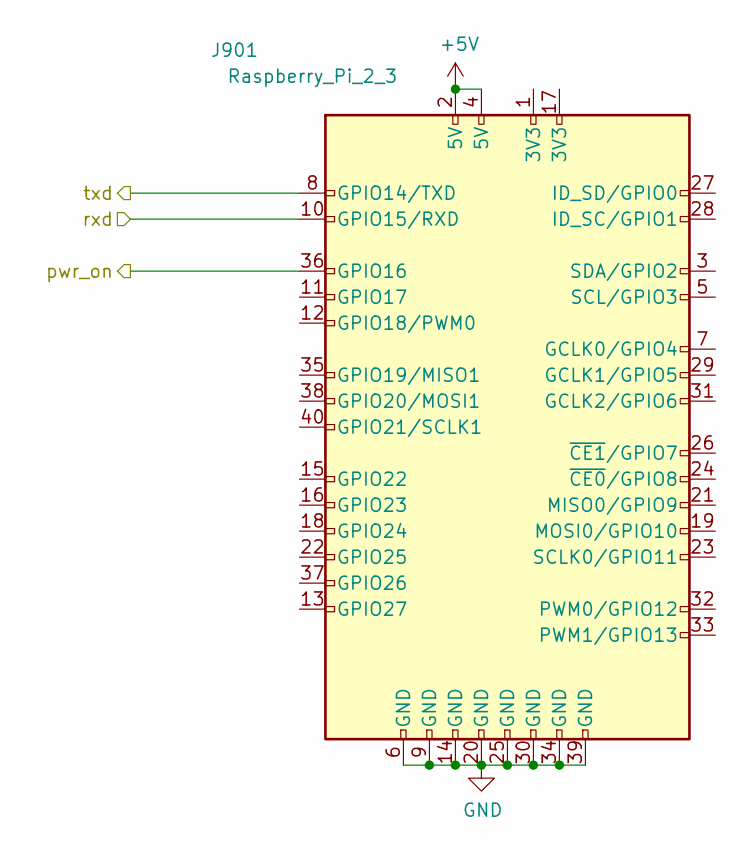
[picture p5: schematic RaspberryPi.kicad_sch]

Parts:
J901: Raspberry_Pi_2_3; MODULE_RASPBERRY_PI_3_MODEL_B+

Connections:
+5V: J901.2 (5V), J901.4 (5V); also elsewhere on the board
/RaspberryPI_CM4/rxd: J901.10 (GPIO15/RXD); also elsewhere on the board
/RaspberryPI_CM4/txd: J901.8 (GPIO14/TXD); also elsewhere on the board
/pi_pwr_en: J901.36 (GPIO16); also elsewhere on the board
GND: J901.6 (GND), J901.9 (GND), J901.14 (GND), J901.20 (GND), J901.25 (GND), J901.30 (GND), J901.34 (GND), J901.39 (GND); also elsewhere on the board

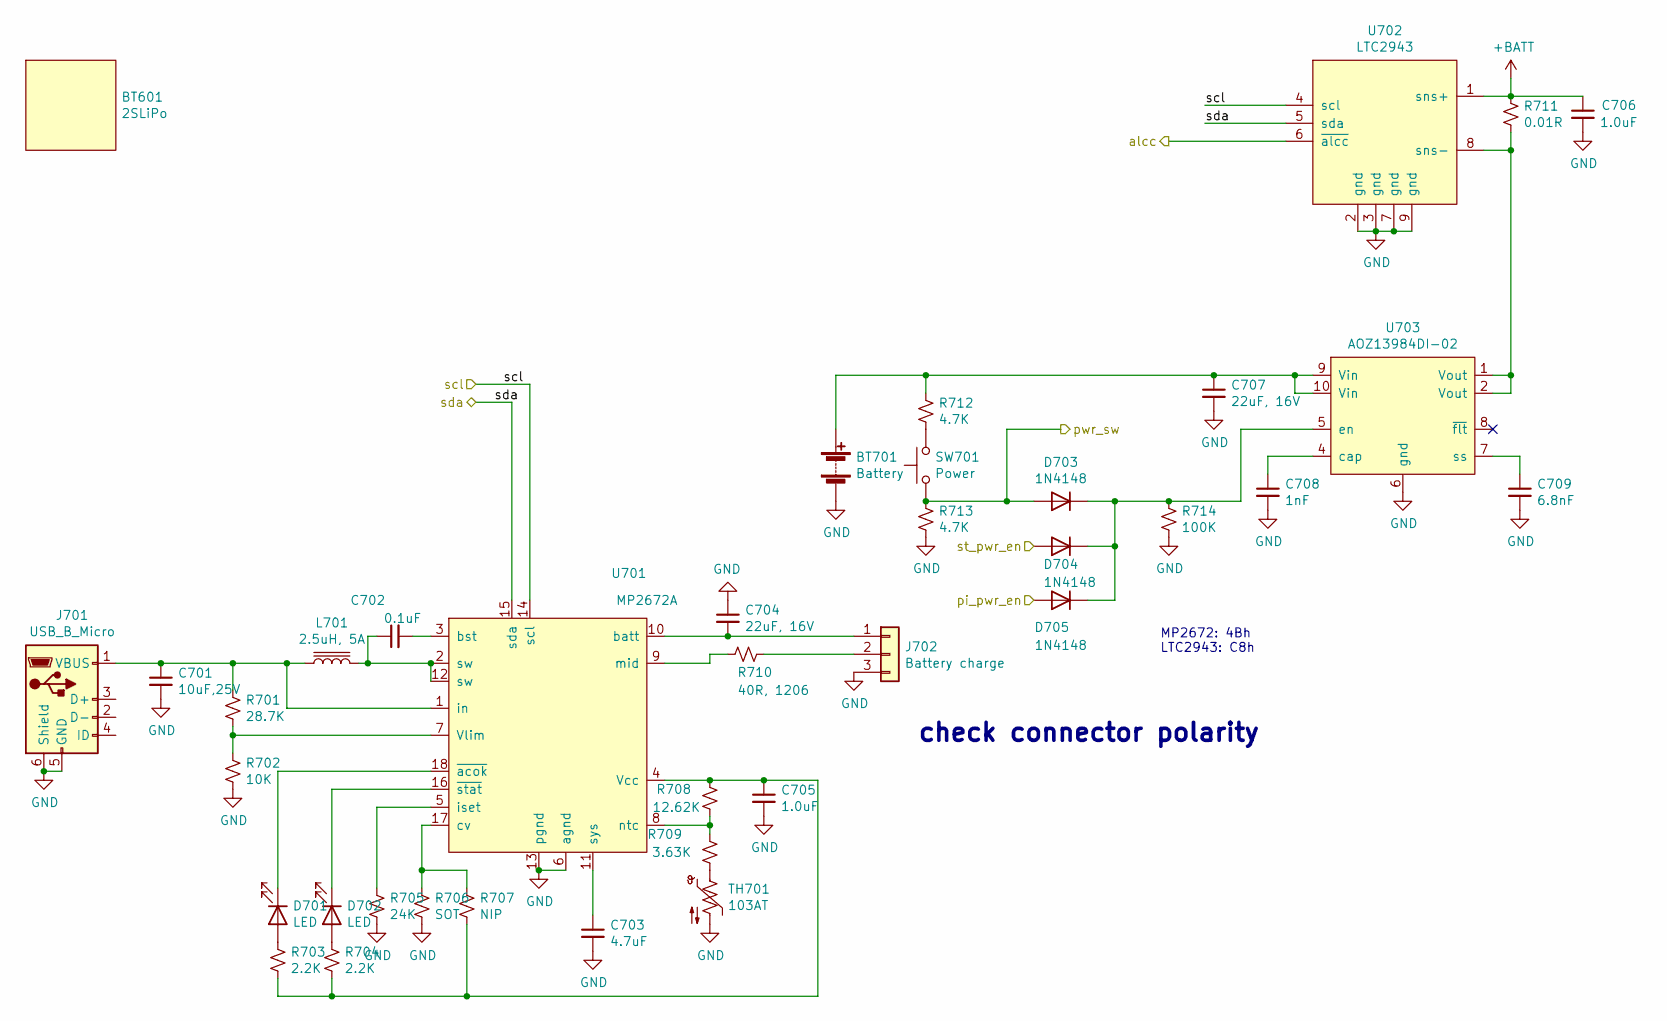
[picture p6: schematic battery.kicad_sch]

Parts:
BT601: 2SLiPo
BT701: Battery; AMASS_XT60-M
C701: 10uF,25V; C_1206_3216Metric
C702: 0.1uF; C_0402_1005Metric
C703: 4.7uF; C_0603_1608Metric
C704, C707: 22uF, 16V; C_1210_3225Metric
C705, C706: 1.0uF; C_0603_1608Metric
C708: 1nF; C_0402_1005Metric
C709: 6.8nF; C_0402_1005Metric
D701, D702: LED; LED_0402_1005Metric
D703, D704, D705: 1N4148; D_SOD-123
J701: USB_B_Micro; USB_Micro-B_Wuerth_629105150521
J702: Battery charge; JST_XH_B3B-XH-AM_1x03_P2.50mm_Vertical
L701: 2.5uH, 5A; CDRH8D38
R701: 28.7K; R_0402_1005Metric
R702: 10K; R_0402_1005Metric
R703, R704: 2.2K; R_0402_1005Metric
R705: 24K; R_0402_1005Metric
R706: SOT; R_0402_1005Metric
R707: NIP; R_0402_1005Metric
R708: 12.62K; R_0402_1005Metric
R709: 3.63K; R_0402_1005Metric
R710: 40R, 1206; R_1206_3216Metric
R711: 0.01R; R_0805_2012Metric
R712, R713: 4.7K; R_0402_1005Metric
R714: 100K; R_0402_1005Metric
SW701: Power; evqpf
TH701: 103AT; Hirose_DF13C_CL535-0402-2-51_1x02-1MP_P1.25mm_Vertical
U701: MP2672A; QFN-18
U702: LTC2943; DFN-8-1EP_3x3mm_P0.5mm_EP1.66x2.38mm
U703: AOZ13984DI-02; DFN3x3-12L

Connections:
+BATT: C706.1, R711.1, U702.1 (sns+); also elsewhere on the board
/battery/alcc: U702.6 (~alcc); also elsewhere on the board
/battery/pwr_sw: D703.2 (A), R713.1, SW701.1; also elsewhere on the board
/battery/scl: U701.14 (scl), U702.4 (scl); also elsewhere on the board
/battery/sda: U701.15 (sda), U702.5 (sda); also elsewhere on the board
/battery/st_pwr_en: D704.2 (A); also elsewhere on the board
/pi_pwr_en: D705.2 (A); also elsewhere on the board
GND: BT701.2 (-), C701.2, C703.2, C704.1, C705.2, C706.2, C707.2, C708.2, C709.2, J701.5 (GND), J701.6 (Shield), J702.3, R702.2, R705.2, R706.2, R713.2, R714.2, TH701.2, U701.6 (agnd), U701.13 (pgnd), U702.2 (gnd), U702.3 (gnd), U702.7 (gnd), U702.9 (gnd), U703.6 (gnd); also elsewhere on the board
unnamed: BT701.1 (+), C707.1, R712.1, U703.9 (Vin), U703.10 (Vin)
unnamed: C701.1, J701.1 (VBUS), L701.1, R701.1, U701.1 (in)
unnamed: C702.1, L701.2, U701.2 (sw), U701.12 (sw)
unnamed: C702.2, U701.3 (bst)
unnamed: C703.1, U701.11 (sys)
unnamed: C704.2, J702.1, U701.10 (batt)
unnamed: C705.1, R703.2, R704.2, R707.2, R708.2, U701.4 (Vcc)
unnamed: C708.1, U703.4 (cap)
unnamed: C709.1, U703.7 (ss)
unnamed: D701.1 (K), U701.18 (~acok)
unnamed: D701.2 (A), R703.1
unnamed: D702.1 (K), U701.16 (~stat)
unnamed: D702.2 (A), R704.1
unnamed: D703.1 (K), D704.1 (K), D705.1 (K), R714.1, U703.5 (en)
unnamed: J702.2, R710.1
unnamed: R701.2, R702.1, U701.7 (Vlim)
unnamed: R705.1, U701.5 (iset)
unnamed: R706.1, R707.1, U701.17 (cv)
unnamed: R708.1, R709.2, U701.8 (ntc)
unnamed: R709.1, TH701.1
unnamed: R710.2, U701.9 (mid)
unnamed: R711.2, U702.8 (sns-), U703.1 (Vout), U703.2 (Vout)
unnamed: R712.2, SW701.2

Notes on the sheet:
check connector polarity
MP2672: 4Bh LTC2943: C8h

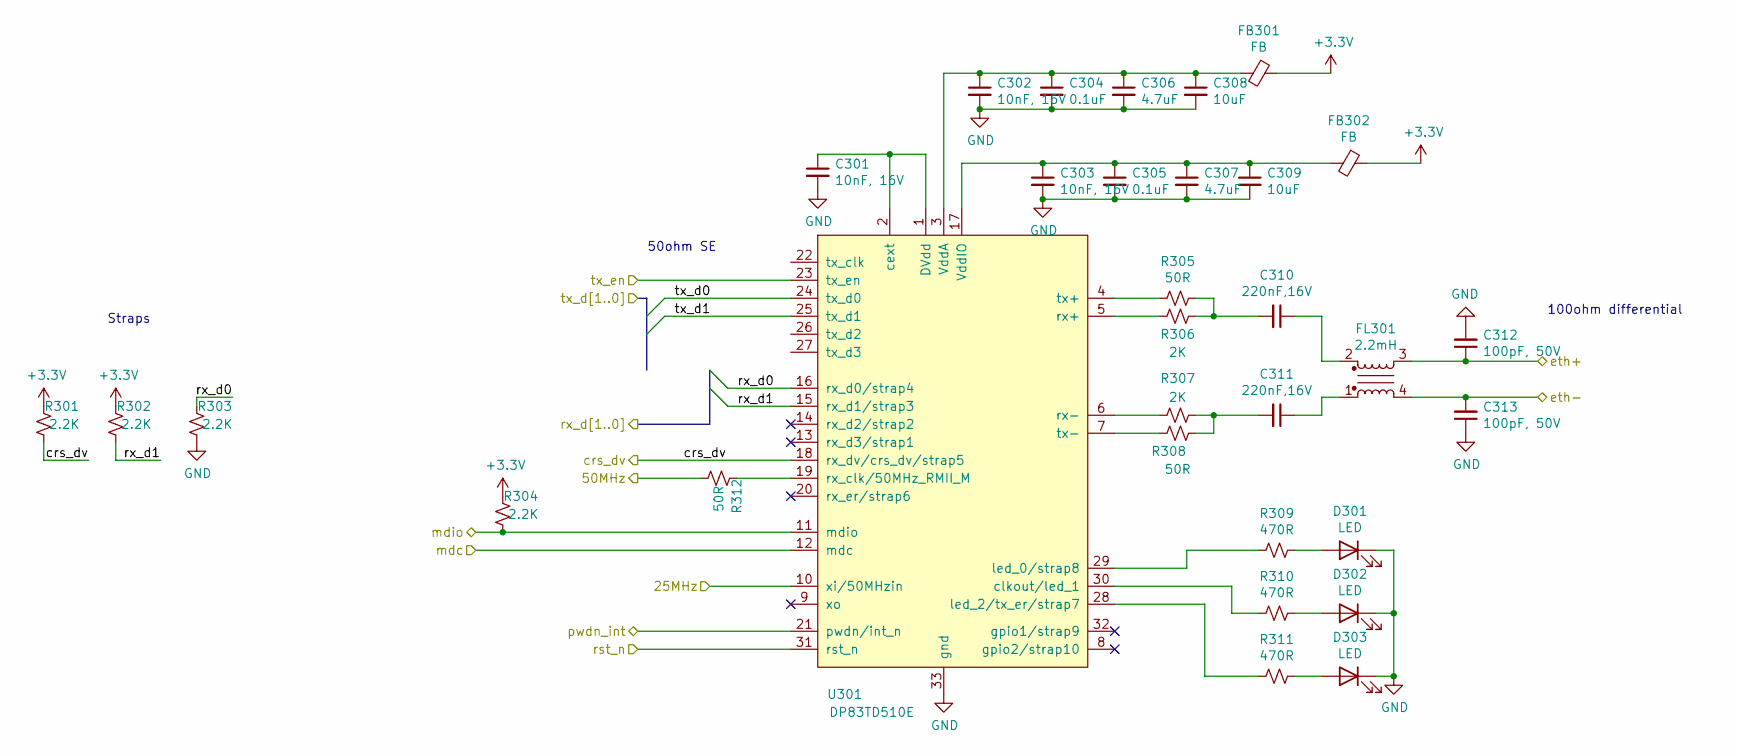
[picture p7: schematic ethernet.kicad_sch]

Parts:
C301, C302, C303: 10nF, 16V; C_0402_1005Metric
C304, C305: 0.1uF; C_0402_1005Metric
C306, C307: 4.7uF; C_0603_1608Metric
C308, C309: 10uF; C_0805_2012Metric
C310, C311: 220nF,16V; C_0603_1608Metric
C312, C313: 100pF, 50V; C_0603_1608Metric
D301, D302, D303: LED; LED_0402_1005Metric
FB301, FB302: FB; R_0603_1608Metric
FL301: 2.2mH; L_WE_SL5
R301, R302, R303, R304: 2.2K; R_0402_1005Metric
R305, R308, R312: 50R; R_0402_1005Metric
R306, R307: 2K; R_2512_6332Metric
R309, R310, R311: 470R; R_0402_1005Metric
U301: DP83TD510E; TQFN-32-1EP_5x5mm_P0.5mm_EP2.1x2.1mm

Connections:
+3V3: FB301.1, FB302.1, R301.2, R302.2, R304.2; also elsewhere on the board
/eth+: C312.1, FL301.3; also elsewhere on the board
/eth-: C313.2, FL301.4; also elsewhere on the board
/ethernet/25MHz: U301.10 (xi/50MHzin); also elsewhere on the board
/ethernet/50MHz: R312.1; also elsewhere on the board
/ethernet/crs_dv: R301.1, U301.18 (rx_dv/crs_dv/strap5); also elsewhere on the board
/ethernet/mdc: U301.12 (mdc); also elsewhere on the board
/ethernet/mdio: R304.1, U301.11 (mdio); also elsewhere on the board
/ethernet/pwdn_int: U301.21 (pwdn/int_n); also elsewhere on the board
/ethernet/tx_en: U301.23 (tx_en); also elsewhere on the board
/micro/eth_rx_d0: R303.2, U301.16 (rx_d0/strap4); also elsewhere on the board
/micro/eth_rx_d1: R302.1, U301.15 (rx_d1/strap3); also elsewhere on the board
/micro/eth_tx_d0: U301.24 (tx_d0); also elsewhere on the board
/micro/eth_tx_d1: U301.25 (tx_d1); also elsewhere on the board
/micro/nrst: U301.31 (rst_n); also elsewhere on the board
GND: C301.2, C302.2, C303.2, C304.2, C305.2, C306.2, C307.2, C308.2, C309.2, C312.2, C313.1, D301.1 (K), D302.1 (K), D303.1 (K), R303.1, U301.33 (gnd); also elsewhere on the board
unnamed: C301.1, U301.1 (DVdd), U301.2 (cext)
unnamed: C302.1, C304.1, C306.1, C308.1, FB301.2, U301.3 (VddA)
unnamed: C303.1, C305.1, C307.1, C309.1, FB302.2, U301.17 (VddIO)
unnamed: C310.1, FL301.2
unnamed: C310.2, R305.1, R306.1
unnamed: C311.1, FL301.1
unnamed: C311.2, R307.1, R308.1
unnamed: R305.2, U301.4 (tx+)
unnamed: R306.2, U301.5 (rx+)
unnamed: R307.2, U301.6 (rx-)
unnamed: R308.2, U301.7 (tx-)
unnamed: D301.2 (A), R309.1
unnamed: D302.2 (A), R310.1
unnamed: D303.2 (A), R311.1
unnamed: R312.2, U301.19 (rx_clk/50MHz_RMII_M)
unnamed: R311.2, U301.28 (led_2/tx_er/strap7)
unnamed: R309.2, U301.29 (led_0/strap8)
unnamed: R310.2, U301.30 (clkout/led_1)

Notes on the sheet:
Straps
50ohm SE
100ohm differential
