highpeng/sub/electrical/base board 5.99/base board.kicad_pcb

## KiCad design electrical/base board 5.99/base board.kicad_pcb (continued)

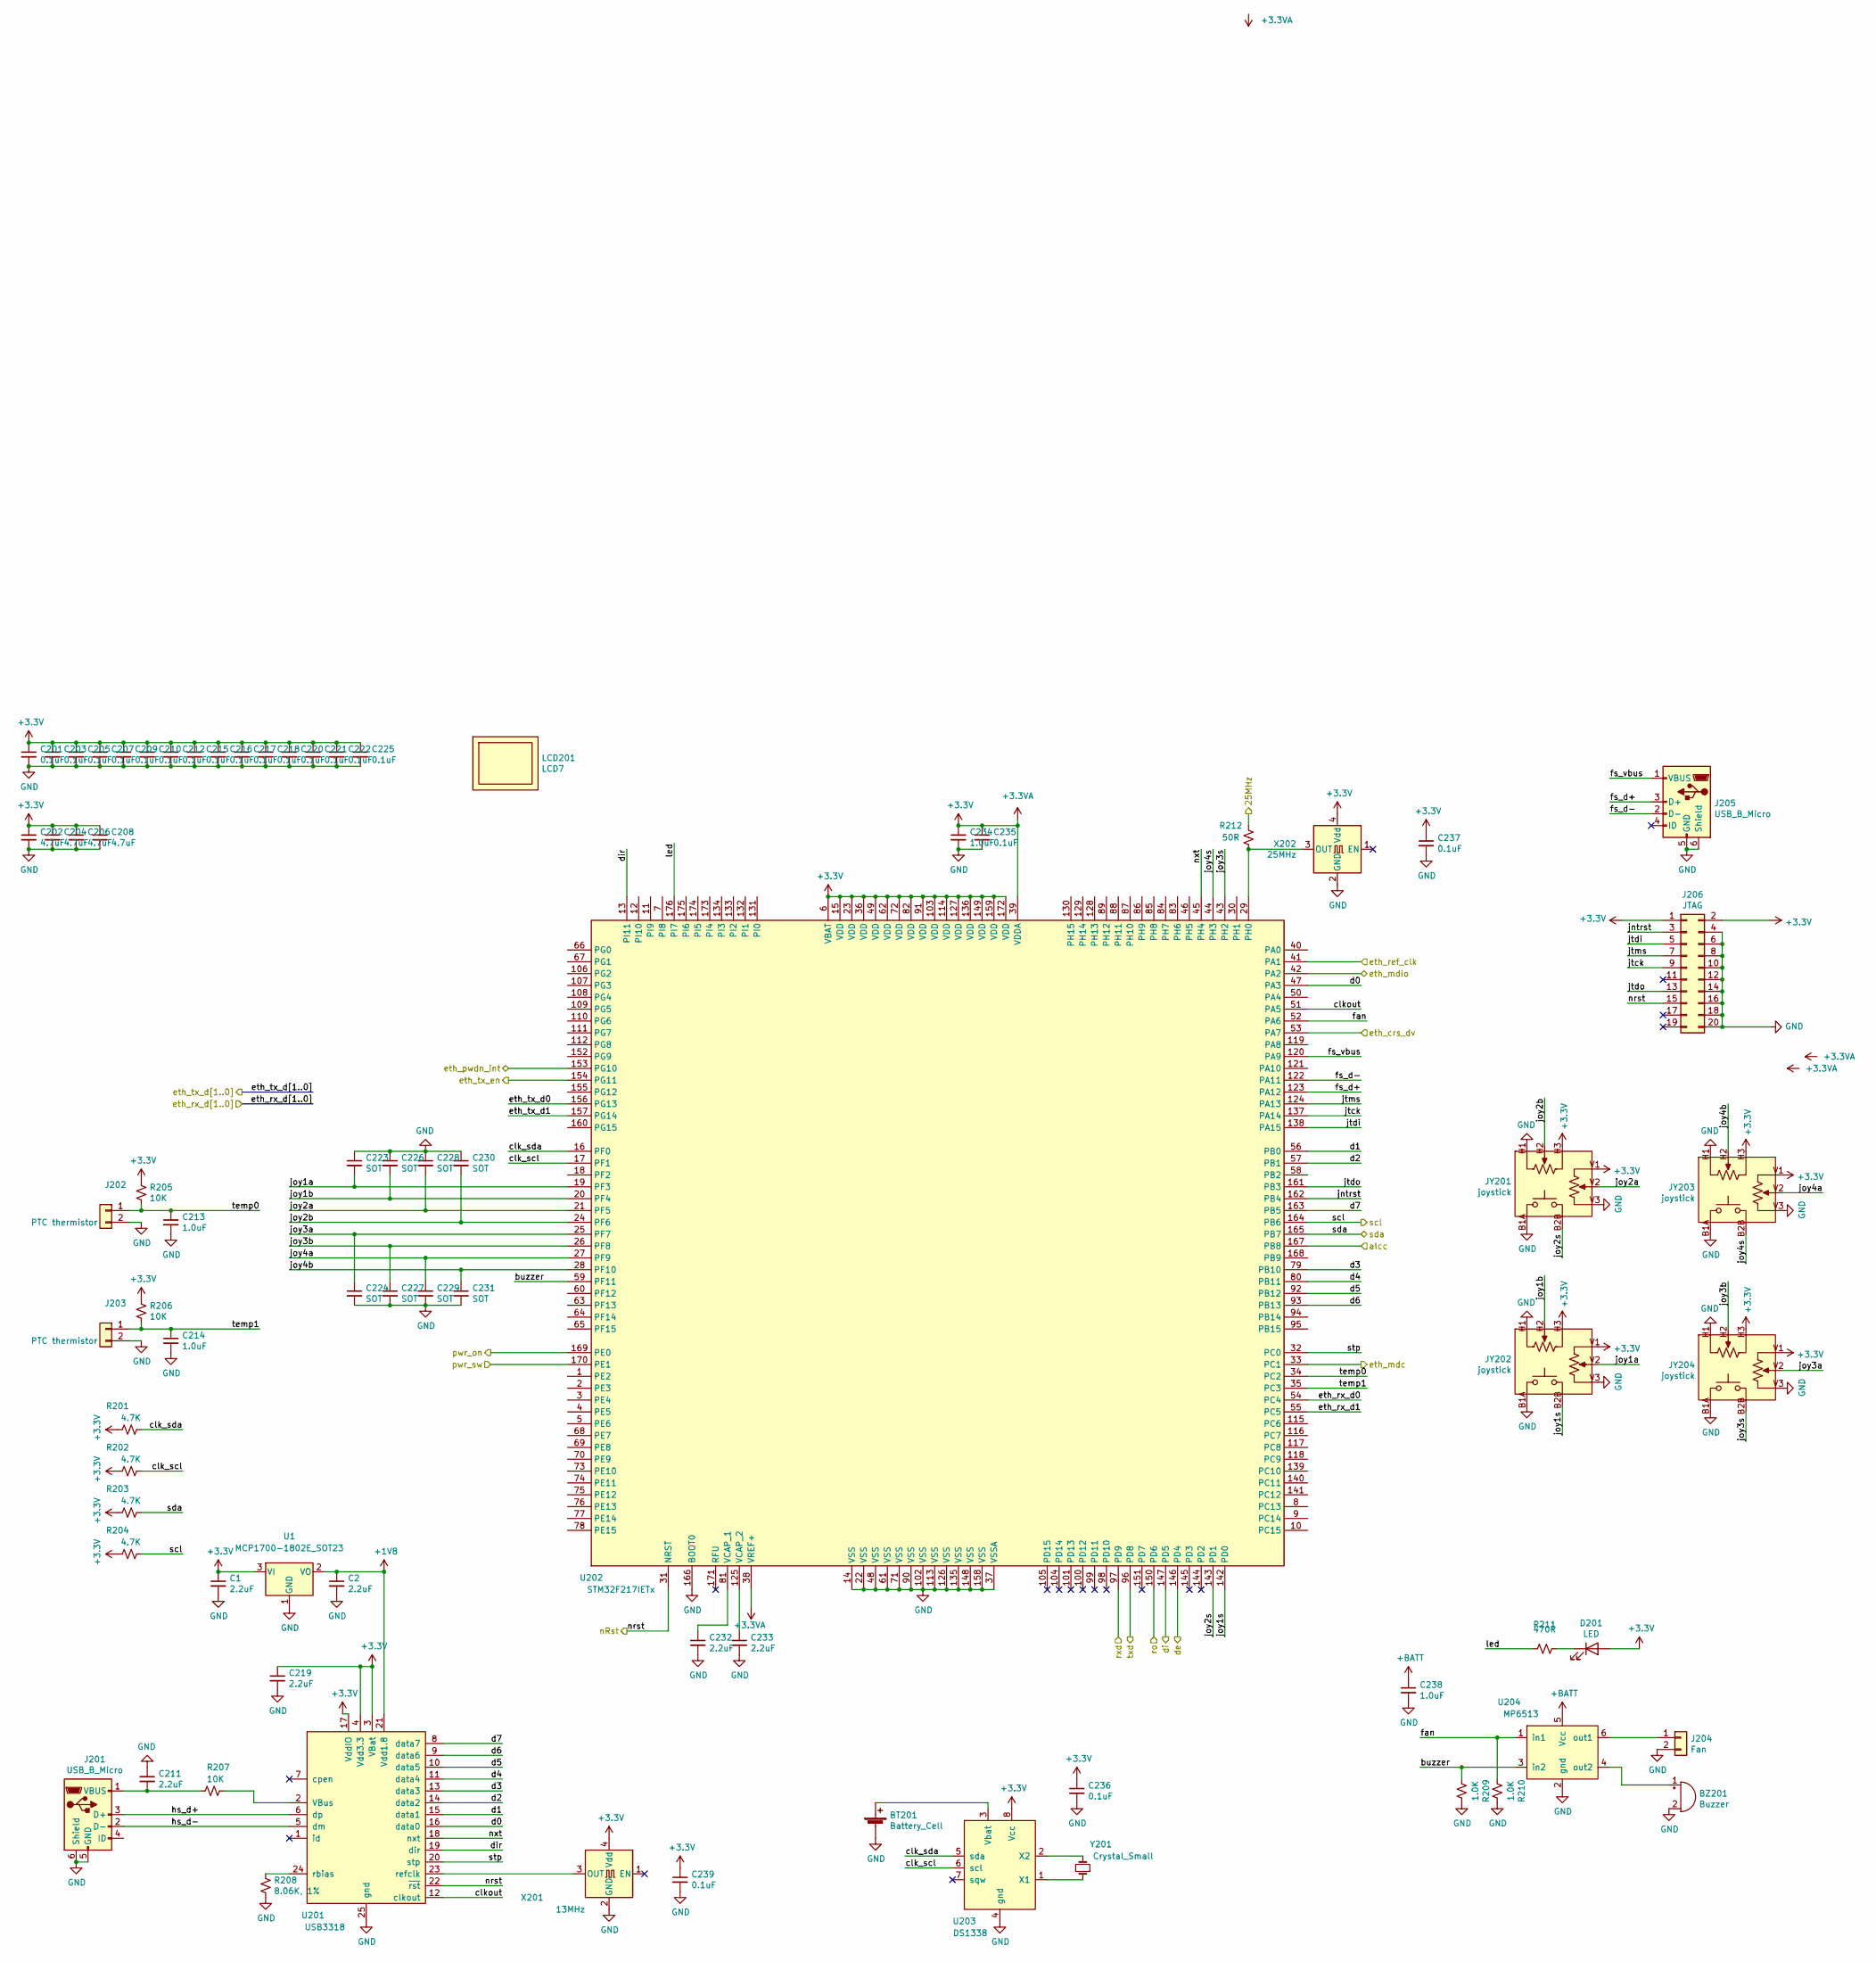
[picture p8: schematic micro.kicad_sch]

Parts:
BT201: Battery_Cell; BH-49C-1-BK
BZ201: Buzzer; CPI-1375-80T
C1, C2, C211, C219, C232, C233: 2.2uF; C_0603_1608Metric
C201, C203, C205, C207, C209, C210, C212, C215, C216, C217, C218, C220, C221, C222, C225, C235, C236, C237, C239: 0.1uF; C_0402_1005Metric
C202, C204, C206, C208: 4.7uF; C_0603_1608Metric
C213, C214, C234, C238: 1.0uF; C_0603_1608Metric
C223, C224, C226, C227, C228, C229, C230, C231: SOT; C_0402_1005Metric
D201: LED; LED_0402_1005Metric
J201, J205: USB_B_Micro; USB_Micro-B_Wuerth_629105150521
J202, J203: PTC thermistor; Hirose_DF13C_CL535-0402-2-51_1x02-1MP_P1.25mm_Vertical
J204: Fan; Hirose_DF13C_CL535-0402-2-51_1x02-1MP_P1.25mm_Vertical
J206: JTAG; IDC-Header_2x10_P2.54mm_Vertical
JY201, JY202, JY203, JY204: joystick; XDCR_COM-09032
LCD201: LCD7
R201, R202, R203, R204: 4.7K; R_0402_1005Metric
R205, R206, R207: 10K; R_0402_1005Metric
R208: 8.06K, 1%; R_0402_1005Metric
R209, R210: 1.0K; R_0402_1005Metric
R211: 470R; R_0402_1005Metric
R212: 50R; R_0402_1005Metric
U1: MCP1700-1802E_SOT23; SOT-23
U201: USB3318; QFN-24-1EP_4x4mm_P0.5mm_EP2.6x2.6mm
U202: STM32F217IETx; LQFP-176_24x24mm_P0.5mm
U203: DS1338; SOIC-8_3.9x4.9mm_P1.27mm
U204: MP6513; TSOT-23-6
X201: 13MHz; 831056290
X202: 25MHz; ASFL1
Y201: Crystal_Small; CMJ206T

Connections:
+1V8: C2.1, U1.2 (VO), U201.21 (Vdd1.8)
+3V3: C1.1, C201.1, C202.1, C203.1, C204.1, C205.1, C206.1, C207.1, C208.1, C209.1, C210.1, C212.1, C215.1, C216.1, C217.1, C218.1, C219.1, C220.1, C221.1, C222.1, C225.1, C234.1, C235.1, C236.1, C237.1, C239.1, D201.2 (A), J206.1, J206.2, JY201.H3, JY201.V1, JY202.H3, JY202.V1, JY203.H3, JY203.V1, JY204.H3, JY204.V1, R201.1, R202.1, R203.1, R204.1, R205.1, R206.1, U1.3 (VI), U201.3 (VBat~), U201.4 (Vdd3.3), U201.17 (VddIO), U202.6 (VBAT), U202.15 (VDD), U202.23 (VDD), U202.36 (VDD), U202.38 (VREF+), U202.39 (VDDA), U202.49 (VDD), U202.62 (VDD), U202.72 (VDD), U202.82 (VDD), U202.91 (VDD), U202.103 (VDD), U202.114 (VDD), U202.127 (VDD), U202.136 (VDD), U202.149 (VDD), U202.159 (VDD), U202.172 (VDD), U203.8 (Vcc), X201.4 (Vdd), X202.4 (Vdd); also elsewhere on the board
+BATT: C238.1, U204.5 (Vcc); also elsewhere on the board
/RS485/DE: U202.146 (PD4); also elsewhere on the board
/RS485/DI: U202.147 (PD5); also elsewhere on the board
/RS485/RO: U202.150 (PD6); also elsewhere on the board
/RaspberryPI_CM4/rxd: U202.96 (PD8); also elsewhere on the board
/RaspberryPI_CM4/txd: U202.97 (PD9); also elsewhere on the board
/battery/alcc: U202.167 (PB8); also elsewhere on the board
/battery/pwr_sw: U202.170 (PE1); also elsewhere on the board
/battery/scl: R204.2, U202.164 (PB6); also elsewhere on the board
/battery/sda: R203.2, U202.165 (PB7); also elsewhere on the board
/battery/st_pwr_en: U202.169 (PE0); also elsewhere on the board
/ethernet/25MHz: R212.2; also elsewhere on the board
/ethernet/50MHz: U202.41 (PA1); also elsewhere on the board
/ethernet/crs_dv: U202.53 (PA7); also elsewhere on the board
/ethernet/mdc: U202.33 (PC1); also elsewhere on the board
/ethernet/mdio: U202.42 (PA2); also elsewhere on the board
/ethernet/pwdn_int: U202.153 (PG10); also elsewhere on the board
/ethernet/tx_en: U202.154 (PG11); also elsewhere on the board
/micro/buzzer: R209.2, U202.59 (PF11), U204.3 (in2)
/micro/clk_scl: R202.2, U202.17 (PF1), U203.6 (scl)
/micro/clk_sda: R201.2, U202.16 (PF0), U203.5 (sda)
/micro/clkout: U201.12 (clkout), U202.51 (PA5)
/micro/d0: U201.16 (data0), U202.47 (PA3)
/micro/d1: U201.15 (data1), U202.56 (PB0)
/micro/d2: U201.14 (data2), U202.57 (PB1)
/micro/d3: U201.13 (data3), U202.79 (PB10)
/micro/d4: U201.11 (data4), U202.80 (PB11)
/micro/d5: U201.10 (data5), U202.92 (PB12)
/micro/d6: U201.9 (data6), U202.93 (PB13)
/micro/d7: U201.8 (data7), U202.163 (PB5)
/micro/dir: U201.19 (dir), U202.13 (PI11)
/micro/eth_rx_d0: U202.54 (PC4); also elsewhere on the board
/micro/eth_rx_d1: U202.55 (PC5); also elsewhere on the board
/micro/eth_tx_d0: U202.156 (PG13); also elsewhere on the board
/micro/eth_tx_d1: U202.157 (PG14); also elsewhere on the board
/micro/fan: R210.2, U202.52 (PA6), U204.1 (in1)
/micro/fs_d+: J205.3 (D+), U202.123 (PA12)
/micro/fs_d-: J205.2 (D-), U202.122 (PA11)
/micro/fs_vbus: J205.1 (VBUS), U202.120 (PA9)
/micro/hs_d+: J201.3 (D+), U201.6 (dp)
/micro/hs_d-: J201.2 (D-), U201.5 (dm)
/micro/jntrst: J206.3, U202.162 (PB4)
/micro/joy1a: C223.2, JY202.V2, U202.19 (PF3)
/micro/joy1b: C226.2, JY202.H2, U202.20 (PF4)
/micro/joy1s: JY202.B2B, U202.142 (PD0)
/micro/joy2a: C228.2, JY201.V2, U202.21 (PF5)
/micro/joy2b: C230.2, JY201.H2, U202.24 (PF6)
/micro/joy2s: JY201.B2B, U202.143 (PD1)
/micro/joy3a: C224.1, JY204.V2, U202.25 (PF7)
/micro/joy3b: C227.1, JY204.H2, U202.26 (PF8)
/micro/joy3s: JY204.B2B, U202.43 (PH2)
/micro/joy4a: C229.1, JY203.V2, U202.27 (PF9)
/micro/joy4b: C231.1, JY203.H2, U202.28 (PF10)
/micro/joy4s: JY203.B2B, U202.44 (PH3)
/micro/jtck: J206.9, U202.137 (PA14)
/micro/jtdi: J206.5, U202.138 (PA15)
/micro/jtdo: J206.13, U202.161 (PB3)
/micro/jtms: J206.7, U202.124 (PA13)
/micro/led: R211.2, U202.176 (PI7)
/micro/nrst: J206.15, U201.22 (~rst), U202.31 (NRST); also elsewhere on the board
/micro/nxt: U201.18 (nxt), U202.45 (PH4)
/micro/stp: U201.20 (stp), U202.32 (PC0)
/micro/temp0: C213.1, J202.1, R205.2, U202.34 (PC2)
/micro/temp1: C214.1, J203.1, R206.2, U202.35 (PC3)
GND: BT201.2 (-), BZ201.2 (+), C1.2, C2.2, C201.2, C202.2, C203.2, C204.2, C205.2, C206.2, C207.2, C208.2, C209.2, C210.2, C211.1, C212.2, C213.2, C214.2, C215.2, C216.2, C217.2, C218.2, C219.2, C220.2, C221.2, C222.2, C223.1, C224.2, C225.2, C226.1, C227.2, C228.1, C229.2, C230.1, C231.2, C232.2, C233.2, C234.2, C235.2, C236.2, C237.2, C238.2, C239.2, J201.5 (GND), J201.6 (Shield), J202.2, J203.2, J204.2, J205.5 (GND), J205.6 (Shield), J206.4, J206.6, J206.8, J206.10, J206.12, J206.14, J206.16, J206.18, J206.20, JY201.B1A, JY201.H1, JY201.V3, JY202.B1A, JY202.H1, JY202.V3, JY203.B1A, JY203.H1, JY203.V3, JY204.B1A, JY204.H1, JY204.V3, R208.1, R209.1, R210.1, U1.1 (GND), U201.25 (gnd), U202.14 (VSS), U202.22 (VSS), U202.37 (VSSA), U202.48 (VSS), U202.61 (VSS), U202.71 (VSS), U202.90 (VSS), U202.102 (VSS), U202.113 (VSS), U202.126 (VSS), U202.135 (VSS), U202.148 (VSS), U202.158 (VSS), U202.166 (BOOT0), U203.4 (gnd), U204.2 (gnd), X201.2 (GND), X202.2 (GND); also elsewhere on the board
unnamed: BT201.1 (+), U203.3 (Vbat)
unnamed: BZ201.1 (-), U204.4 (out2)
unnamed: C211.2, J201.1 (VBUS), R207.2
unnamed: C232.1, U202.81 (VCAP_1)
unnamed: C233.1, U202.125 (VCAP_2)
unnamed: J204.1, U204.6 (out1)
unnamed: R207.1, U201.2 (VBus)
unnamed: R208.2, U201.24 (rbias)
unnamed: D201.1 (K), R211.1
unnamed: R212.1, U202.29 (PH0), X202.3 (OUT)
unnamed: U201.23 (refclk), X201.3 (OUT)
unnamed: U203.1 (X1), Y201.1
unnamed: U203.2 (X2), Y201.2

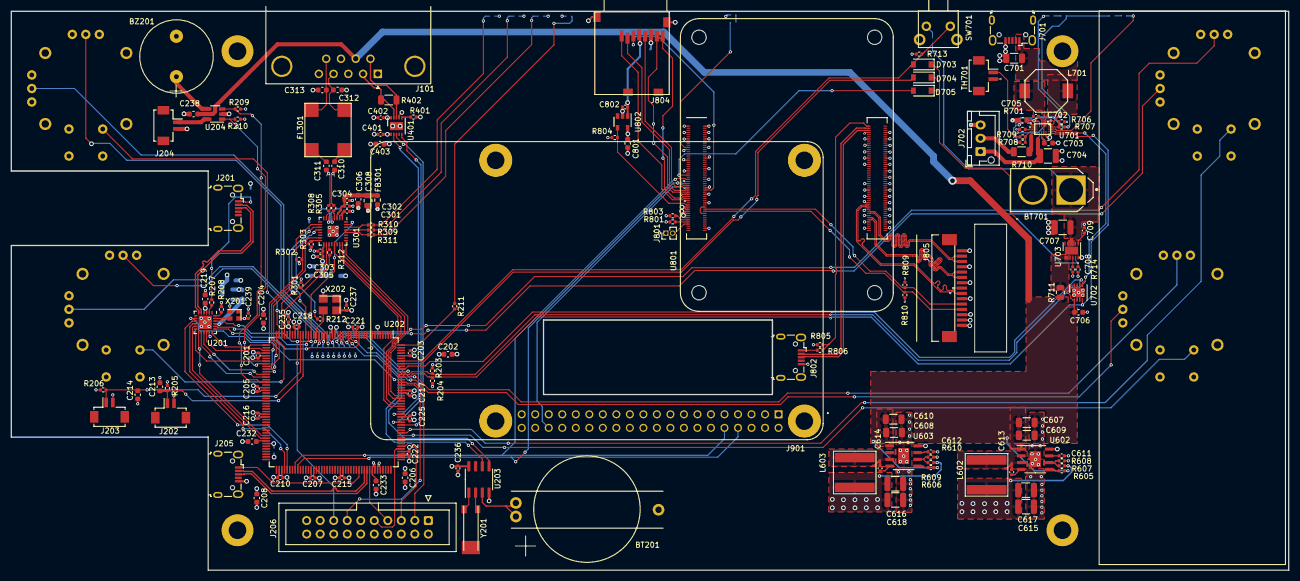
[picture p9: board base board.kicad_pcb from above]

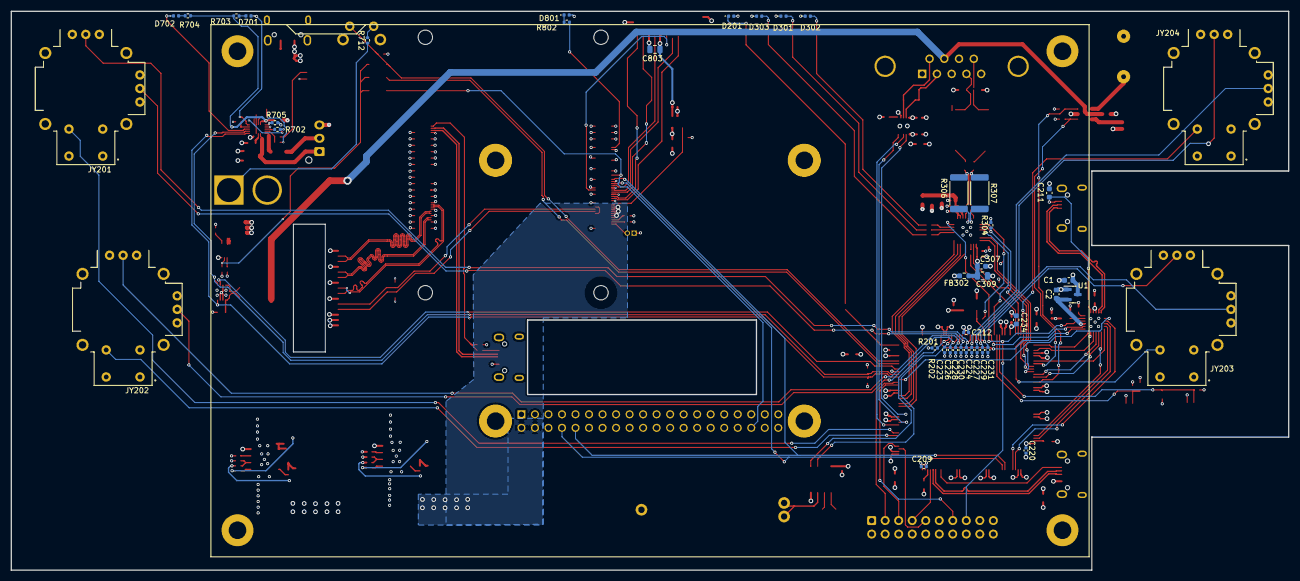
[picture p10: board base board.kicad_pcb from below]

Board: 4 copper layers, 240.0 x 105.0 mm, 193 parts (43 on the bottom side), 164 nets.
