highpeng/sub/electrical/sub board 5.99/board/board.kicad_pcb

## KiCad design electrical/sub board 5.99/board/board.kicad_pcb (2021-10-24)

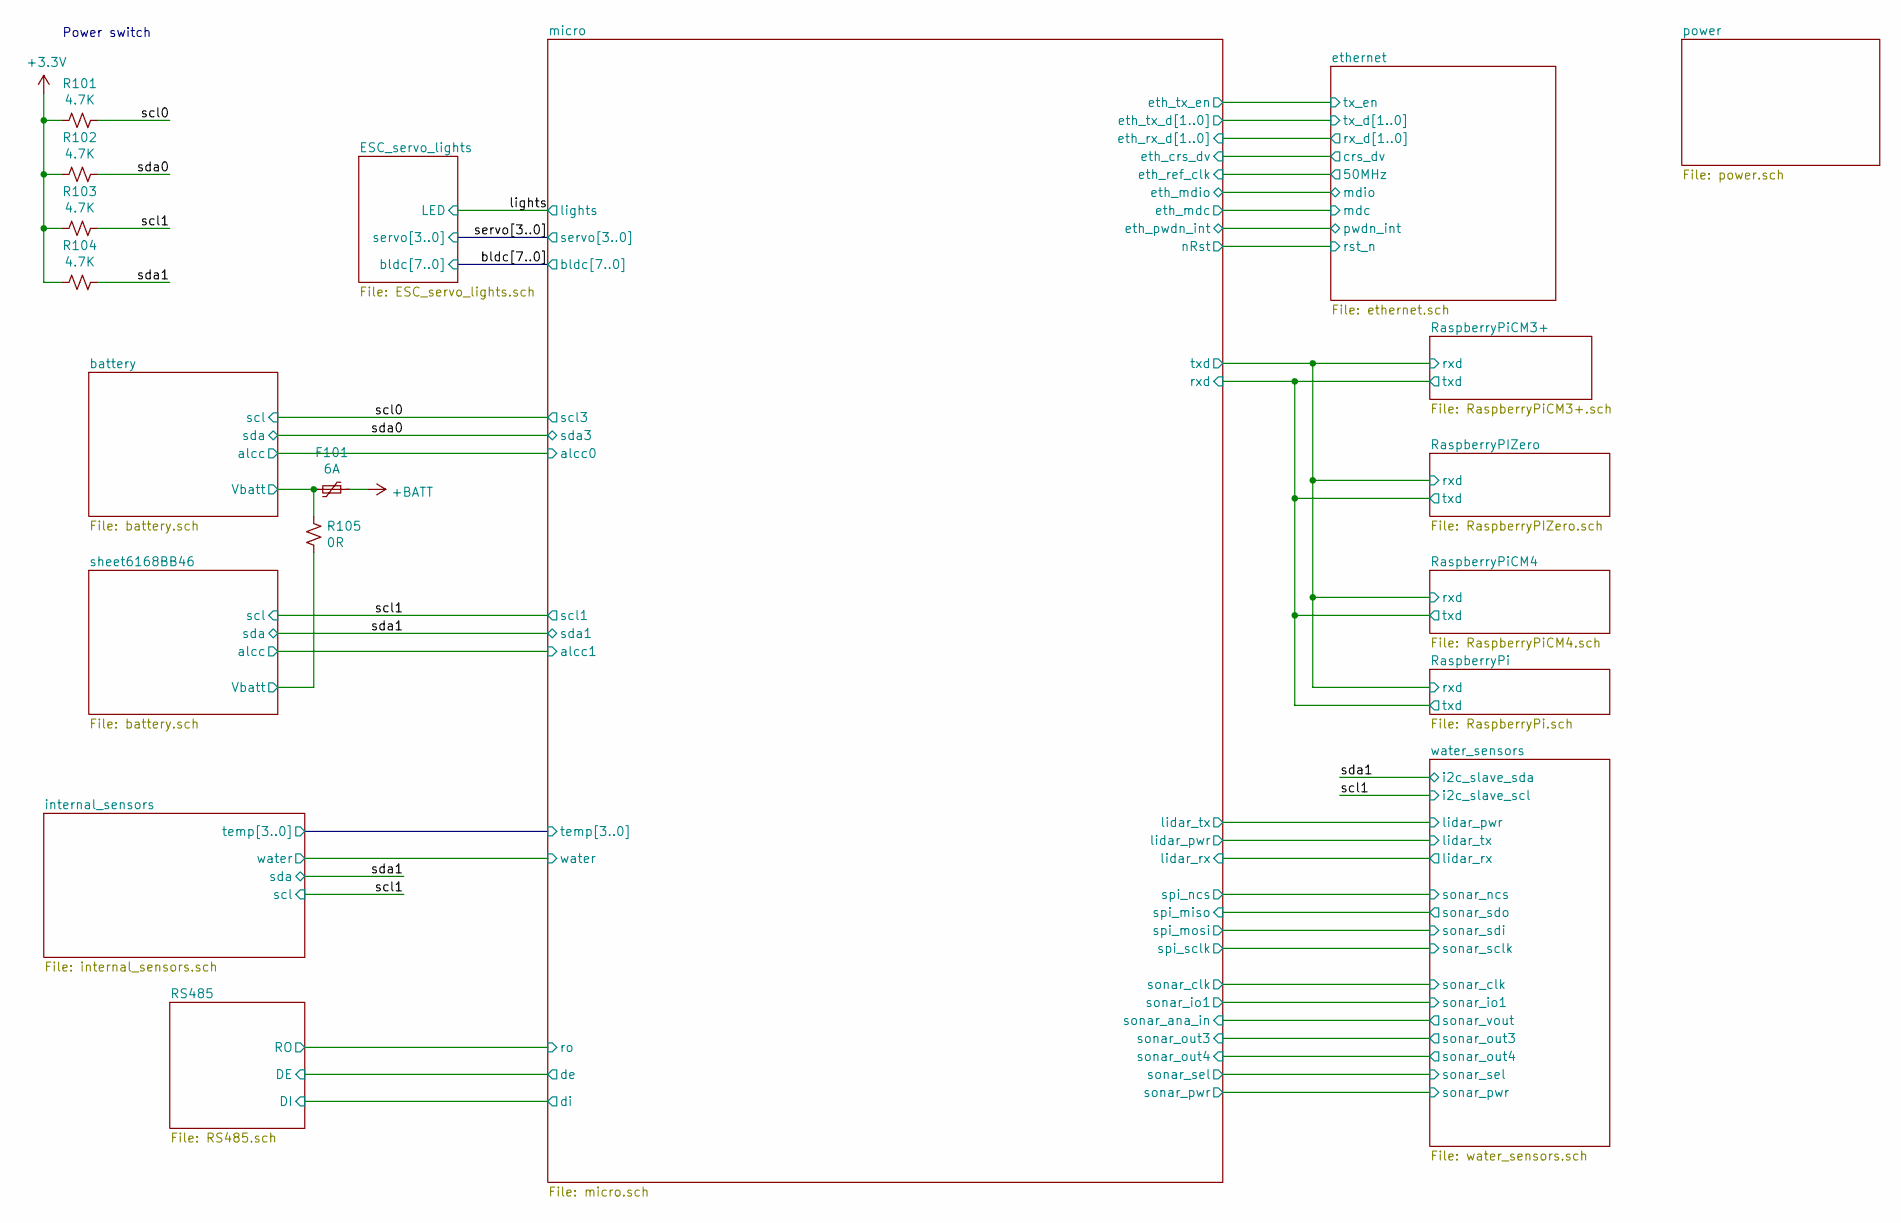
[picture p11: schematic board.sch]

Parts:
F101: 6A; 2920L
R101, R102, R103, R104: 4.7K; R_0402_1005Metric
R105: 0R; AMASS_XT30U-F_1x02_P5.0mm_Vertical

Connections:
+BATT: F101.1; also elsewhere on the board
/battery/Vbatt: F101.2, R105.1; also elsewhere on the board
/scl0: R101.1; also elsewhere on the board
/scl1: R103.1; also elsewhere on the board
/sda0: R102.1; also elsewhere on the board
/sda1: R104.1; also elsewhere on the board
/sheet6168BB46/Vbatt: R105.2; also elsewhere on the board

Notes on the sheet:
Power switch

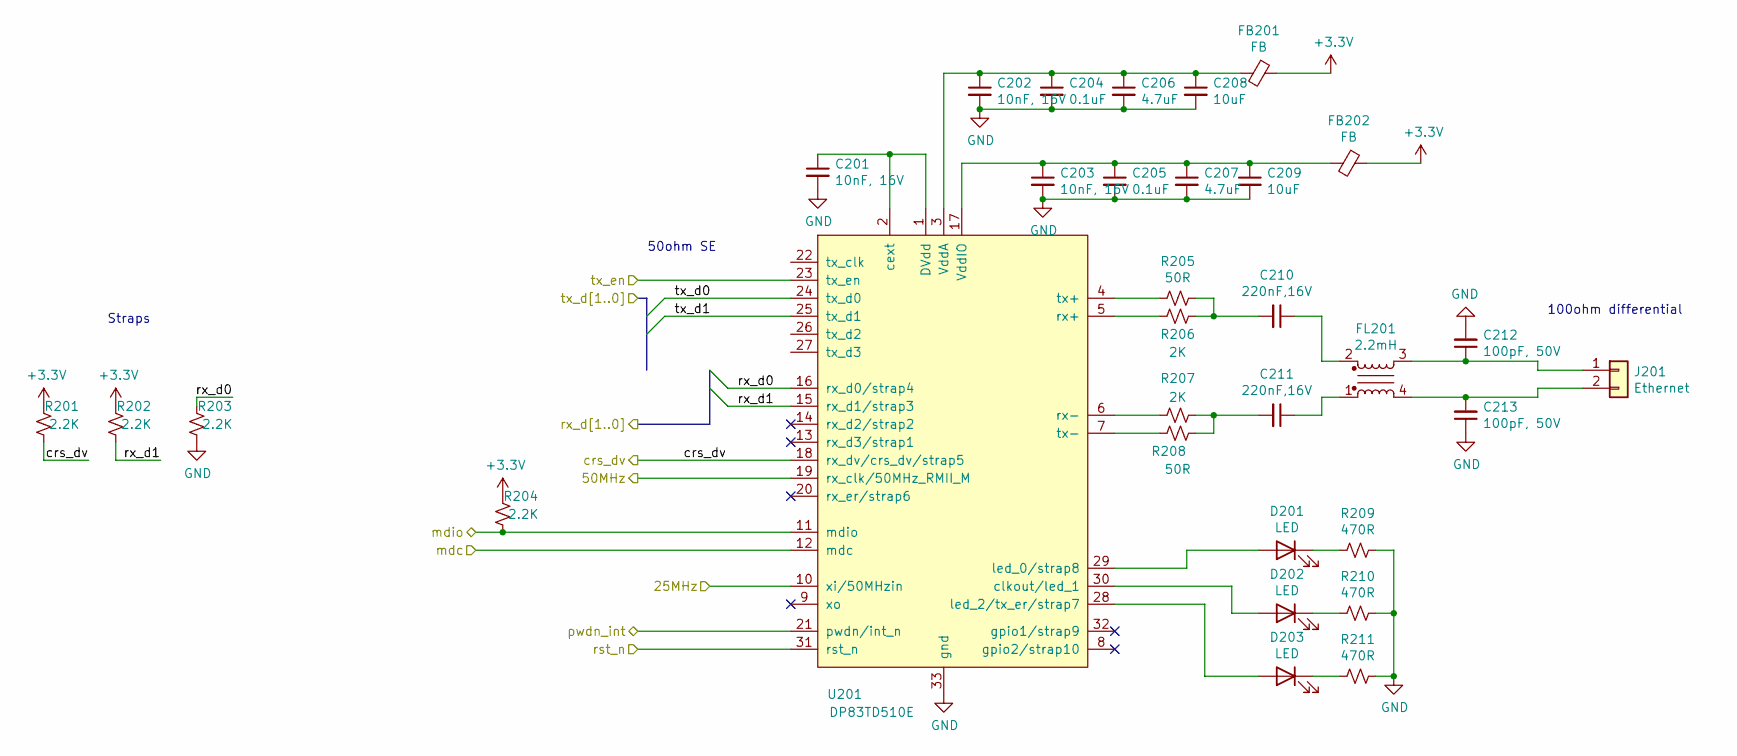
[picture p12: schematic ethernet.sch]

Parts:
C201, C202, C203: 10nF, 16V; C_0402_1005Metric
C204, C205: 0.1uF; C_0402_1005Metric
C206, C207: 4.7uF; C_0603_1608Metric
C208, C209: 10uF; C_0805_2012Metric
C210, C211: 220nF,16V; C_0603_1608Metric
C212, C213: 100pF, 50V; C_0603_1608Metric
D201, D202, D203: LED; LED_0402_1005Metric
FB201, FB202: FB; R_0603_1608Metric
FL201: 2.2mH; L_WE_SL5
J201: Ethernet; Hirose_DF13C_CL535-0402-2-51_1x02-1MP_P1.25mm_Vertical
R201, R202, R203, R204: 2.2K; R_0402_1005Metric
R205, R208: 50R; R_0402_1005Metric
R206, R207: 2K; R_2512_6332Metric
R209, R210, R211: 470R; R_0402_1005Metric
U201: DP83TD510E; TQFN-32-1EP_5x5mm_P0.5mm_EP2.1x2.1mm

Connections:
/ethernet/25MHz: U201.10 (xi/50MHzin)
/ethernet/50MHz: U201.19 (rx_clk/50MHz_RMII_M); also elsewhere on the board
/ethernet/crs_dv: R201.1, U201.18 (rx_dv/crs_dv/strap5); also elsewhere on the board
/ethernet/rx_d0: R203.2, U201.16 (rx_d0/strap4)
/ethernet/rx_d1: R202.1, U201.15 (rx_d1/strap3)
/ethernet/tx_d0: U201.24 (tx_d0)
/ethernet/tx_d1: U201.25 (tx_d1)
/micro/eth_mdc: U201.12 (mdc); also elsewhere on the board
/micro/eth_mdio: R204.1, U201.11 (mdio); also elsewhere on the board
/micro/eth_pwdn_int: U201.21 (pwdn/int_n); also elsewhere on the board
/micro/eth_tx_en: U201.23 (tx_en); also elsewhere on the board
/micro/nRst: U201.31 (rst_n); also elsewhere on the board
unnamed: C201.1, U201.1 (DVdd), U201.2 (cext)
unnamed: C202.1, C204.1, C206.1, C208.1, FB201.2, U201.3 (VddA)
unnamed: C203.1, C205.1, C207.1, C209.1, FB202.2, U201.17 (VddIO)
unnamed: C210.1, FL201.2
unnamed: C210.2, R205.1, R206.1
unnamed: C211.1, FL201.1
unnamed: C211.2, R207.1, R208.1
unnamed: C212.1, FL201.3, J201.1
unnamed: C213.2, FL201.4, J201.2
unnamed: D201.1 (K), R209.2
unnamed: D201.2 (A), U201.29 (led_0/strap8)
unnamed: D202.1 (K), R210.2
unnamed: D202.2 (A), U201.30 (clkout/led_1)
unnamed: D203.1 (K), R211.2
unnamed: D203.2 (A), U201.28 (led_2/tx_er/strap7)
unnamed: R205.2, U201.4 (tx+)
unnamed: R206.2, U201.5 (rx+)
unnamed: R207.2, U201.6 (rx-)
unnamed: R208.2, U201.7 (tx-)

Notes on the sheet:
Straps
100ohm differential
50ohm SE

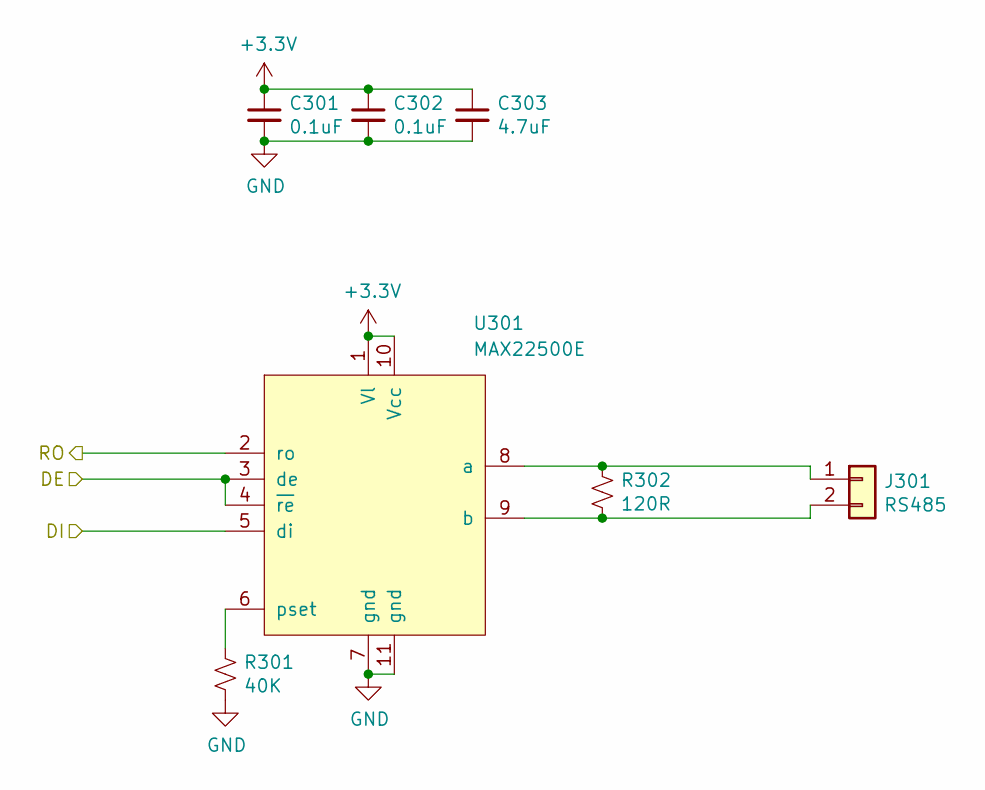
[picture p13: schematic RS485.sch]

Parts:
C301, C302: 0.1uF; C_0402_1005Metric
C303: 4.7uF; C_0603_1608Metric
J301: RS485; Hirose_DF13C_CL535-0402-2-51_1x02-1MP_P1.25mm_Vertical
R301: 40K; R_0402_1005Metric
R302: 120R; R_1206_3216Metric
U301: MAX22500E; DFN-10-1EP_3x3mm_P0.5mm_EP1.55x2.48mm

Connections:
/RS485/DE: U301.3 (de~), U301.4 (~re); also elsewhere on the board
/RS485/DI: U301.5 (di); also elsewhere on the board
/RS485/RO: U301.2 (ro); also elsewhere on the board
unnamed: J301.1, R302.1, U301.8 (a)
unnamed: J301.2, R302.2, U301.9 (b)
unnamed: R301.1, U301.6 (pset)

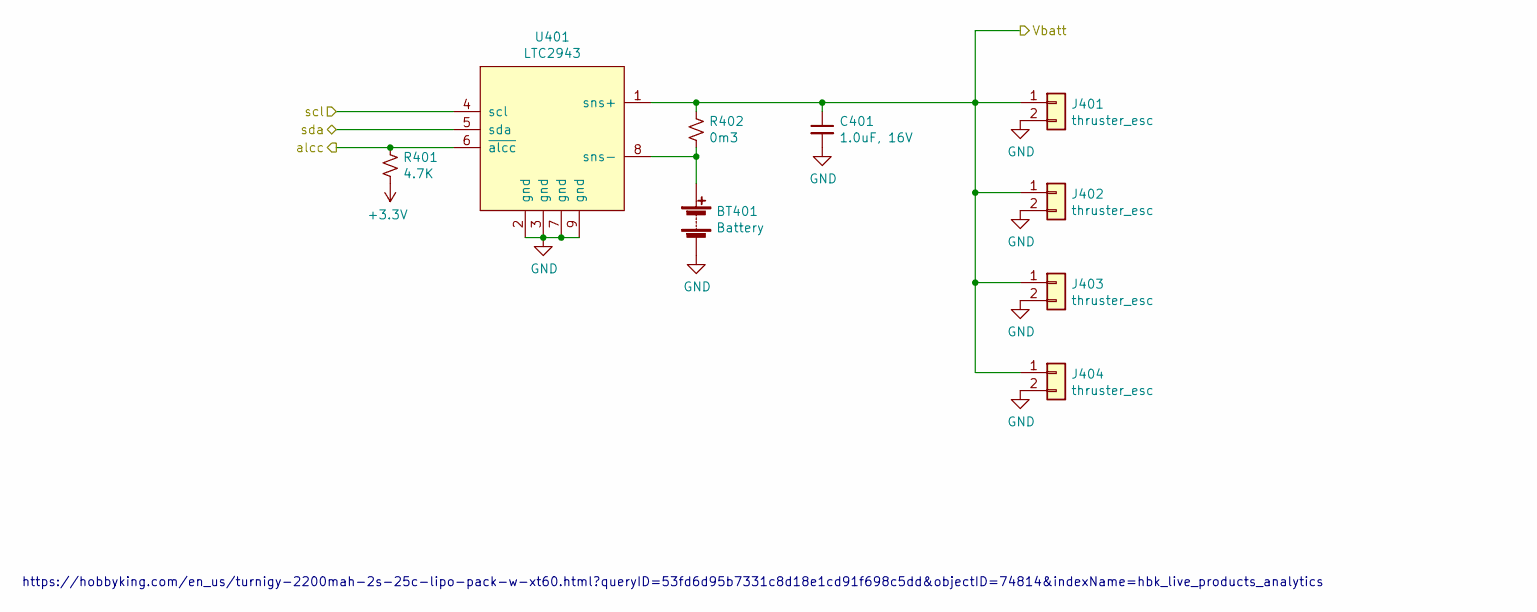
[picture p14: schematic battery.sch]

Parts:
BT401: Battery; AMASS_XT60-M
C401: 1.0uF, 16V; C_0603_1608Metric
J401, J402, J403, J404: thruster_esc; AMASS_XT30U-F_1x02_P5.0mm_Vertical
R401: 4.7K; R_0402_1005Metric
R402: 0m3; PSL2
U401: LTC2943; DFN-8-1EP_3x3mm_P0.5mm_EP1.66x2.38mm

Connections:
/battery/Vbatt: C401.1, J401.1, J402.1, J403.1, J404.1, R402.1, U401.1 (sns+); also elsewhere on the board
/battery/alcc: R401.1, U401.6 (~alcc); also elsewhere on the board
/scl0: U401.4 (scl); also elsewhere on the board
/sda0: U401.5 (sda); also elsewhere on the board
unnamed: BT401.1 (+), R402.2, U401.8 (sns-)

Parts of its further copies:
BT501: Battery; AMASS_XT60-M
C501: 1.0uF, 16V; C_0603_1608Metric
J501, J502, J503, J504: thruster_esc; AMASS_XT30U-F_1x02_P5.0mm_Vertical
R501: 4.7K; R_0402_1005Metric
U501: LTC2943; DFN-8-1EP_3x3mm_P0.5mm_EP1.66x2.38mm

Connections of its further copies:
/scl1: U501.4 (scl); also elsewhere on the board
/sda1: U501.5 (sda); also elsewhere on the board
/sheet6168BB46/Vbatt: C501.1, J501.1, J502.1, J503.1, J504.1, U501.1 (sns+); also elsewhere on the board
/sheet6168BB46/alcc: R501.1, U501.6 (~alcc); also elsewhere on the board
unnamed 153: BT501.1 (+), U501.8 (sns-); also elsewhere on the board

Notes on the sheet:
https://hobbyking.com/en_us/turnigy-2200mah-2s-25c-lipo-pack-w-xt60.html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

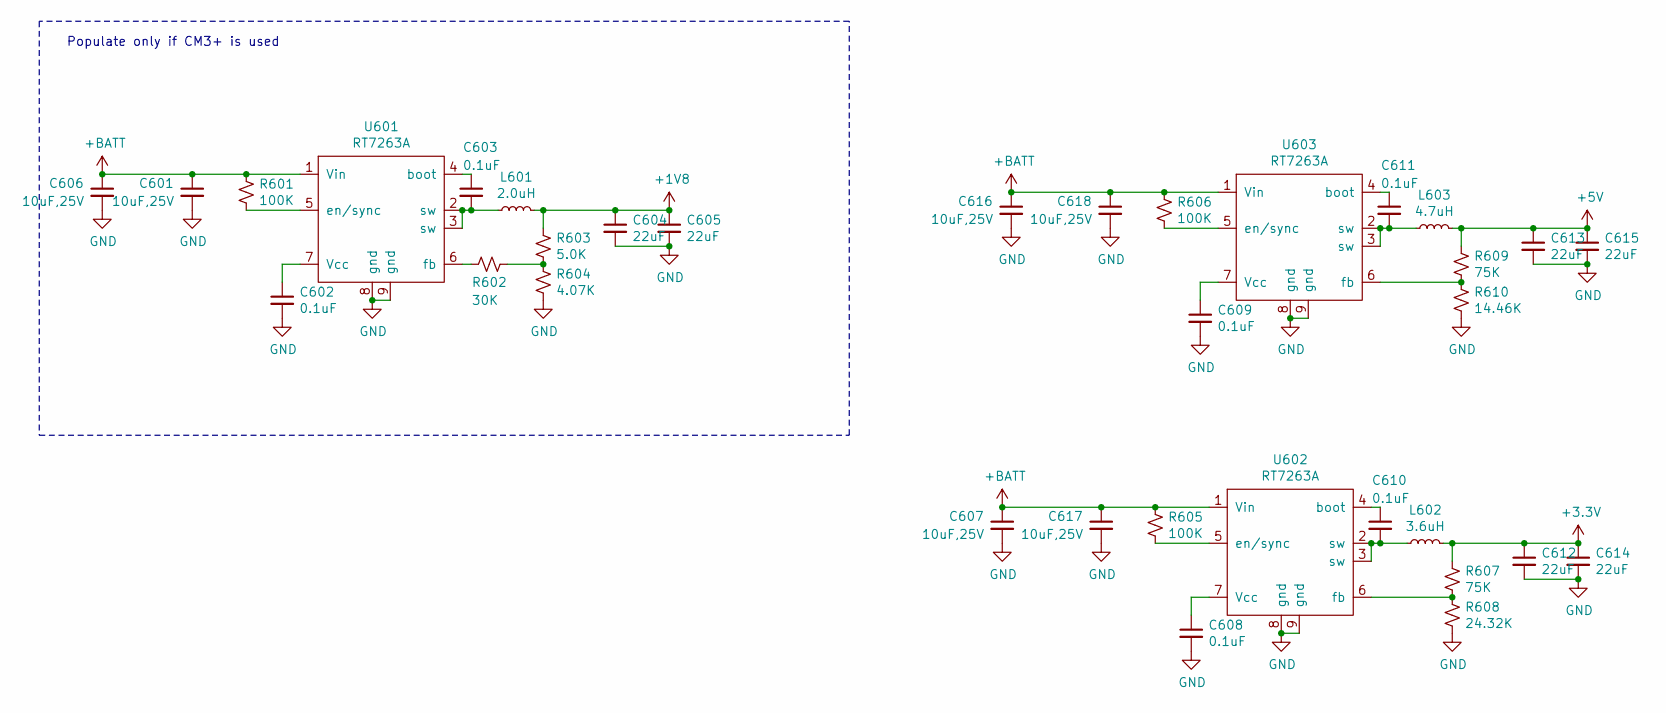
[picture p15: schematic power.sch]

Parts:
C601, C606, C607, C616, C617, C618: 10uF,25V; C_1206_3216Metric
C602, C603, C608, C609, C610, C611: 0.1uF; C_0402_1005Metric
C604, C605, C612, C613, C614, C615: 22uF; C_1210_3225Metric
L601: 2.0uH; NR8040
L602: 3.6uH; NR8040
L603: 4.7uH; NR8040
R601, R605, R606: 100K; R_0402_1005Metric
R602: 30K; R_0402_1005Metric
R603: 5.0K; R_0402_1005Metric
R604: 4.07K; R_0402_1005Metric
R607, R609: 75K; R_0402_1005Metric
R608: 24.32K; R_0402_1005Metric
R610: 14.46K; R_0402_1005Metric
U601, U602, U603: RT7263A; SOP-EP-8_3.9x4.9mm_P1.27mm

Connections:
+1V8: C604.1, C605.1, L601.2, R603.1; also elsewhere on the board
+5V: C613.1, C615.1, L603.2, R609.1; also elsewhere on the board
+BATT: C601.1, C606.1, C607.1, C616.1, C617.1, C618.1, R601.1, R605.1, R606.1, U601.1 (Vin), U602.1 (Vin), U603.1 (Vin); also elsewhere on the board
unnamed: C602.1, U601.7 (Vcc)
unnamed: C603.1, U601.4 (boot)
unnamed: C603.2, L601.1, U601.2 (sw), U601.3 (sw)
unnamed: C608.1, U602.7 (Vcc)
unnamed: C609.1, U603.7 (Vcc)
unnamed: C610.1, U602.4 (boot)
unnamed: C610.2, L602.1, U602.2 (sw), U602.3 (sw)
unnamed: C611.1, U603.4 (boot)
unnamed: C611.2, L603.1, U603.2 (sw), U603.3 (sw)
unnamed: R601.2, U601.5 (en/sync)
unnamed: R602.1, R603.2, R604.1
unnamed: R602.2, U601.6 (fb)
unnamed: R605.2, U602.5 (en/sync)
unnamed: R606.2, U603.5 (en/sync)
unnamed: R607.2, R608.1, U602.6 (fb)
unnamed: R609.2, R610.1, U603.6 (fb)

Notes on the sheet:
Populate only if CM3+ is used

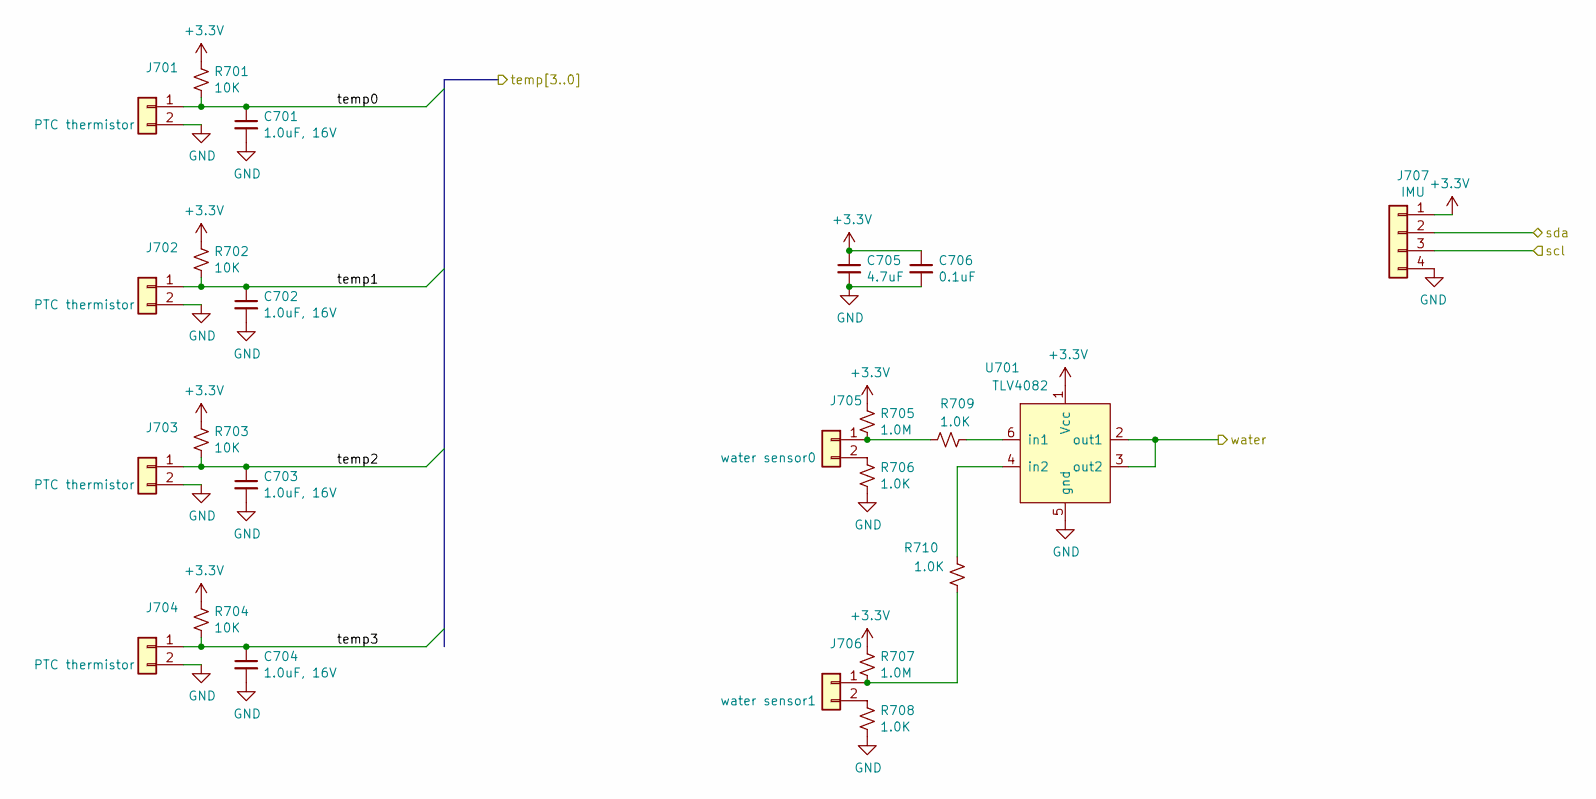
[picture p16: schematic internal_sensors.sch]

Parts:
C701, C702, C703, C704: 1.0uF, 16V; C_0603_1608Metric
C705: 4.7uF; C_0603_1608Metric
C706: 0.1uF; C_0402_1005Metric
J701, J702, J703, J704: PTC thermistor; Hirose_DF13C_CL535-0402-2-51_1x02-1MP_P1.25mm_Vertical
J705: water sensor0; Hirose_DF13C_CL535-0402-2-51_1x02-1MP_P1.25mm_Vertical
J706: water sensor1; Hirose_DF13C_CL535-0402-2-51_1x02-1MP_P1.25mm_Vertical
J707: IMU; Hirose_DF13C_CL535-0404-8-51_1x04-1MP_P1.25mm_Vertical
R701, R702, R703, R704: 10K; R_0402_1005Metric
R705, R707: 1.0M; R_0402_1005Metric
R706, R708, R709, R710: 1.0K; R_0402_1005Metric
U701: TLV4082; SOT-23-6

Connections:
/internal_sensors/temp0: C701.1, J701.1, R701.2; also elsewhere on the board
/internal_sensors/temp1: C702.1, J702.1, R702.2; also elsewhere on the board
/internal_sensors/temp2: C703.1, J703.1, R703.2; also elsewhere on the board
/internal_sensors/temp3: C704.1, J704.1, R704.2; also elsewhere on the board
/internal_sensors/water: U701.2 (out1), U701.3 (out2); also elsewhere on the board
/scl1: J707.3; also elsewhere on the board
/sda1: J707.2; also elsewhere on the board
unnamed: J705.1, R705.1, R709.1
unnamed: J705.2, R706.2
unnamed: J706.1, R707.1, R710.2
unnamed: J706.2, R708.2
unnamed: R709.2, U701.6 (in1)
unnamed: R710.1, U701.4 (in2)
