highpeng/sub/electrical/sub board 5.99/board/board.kicad_pcb

## KiCad design electrical/sub board 5.99/board/board.kicad_pcb (continued)

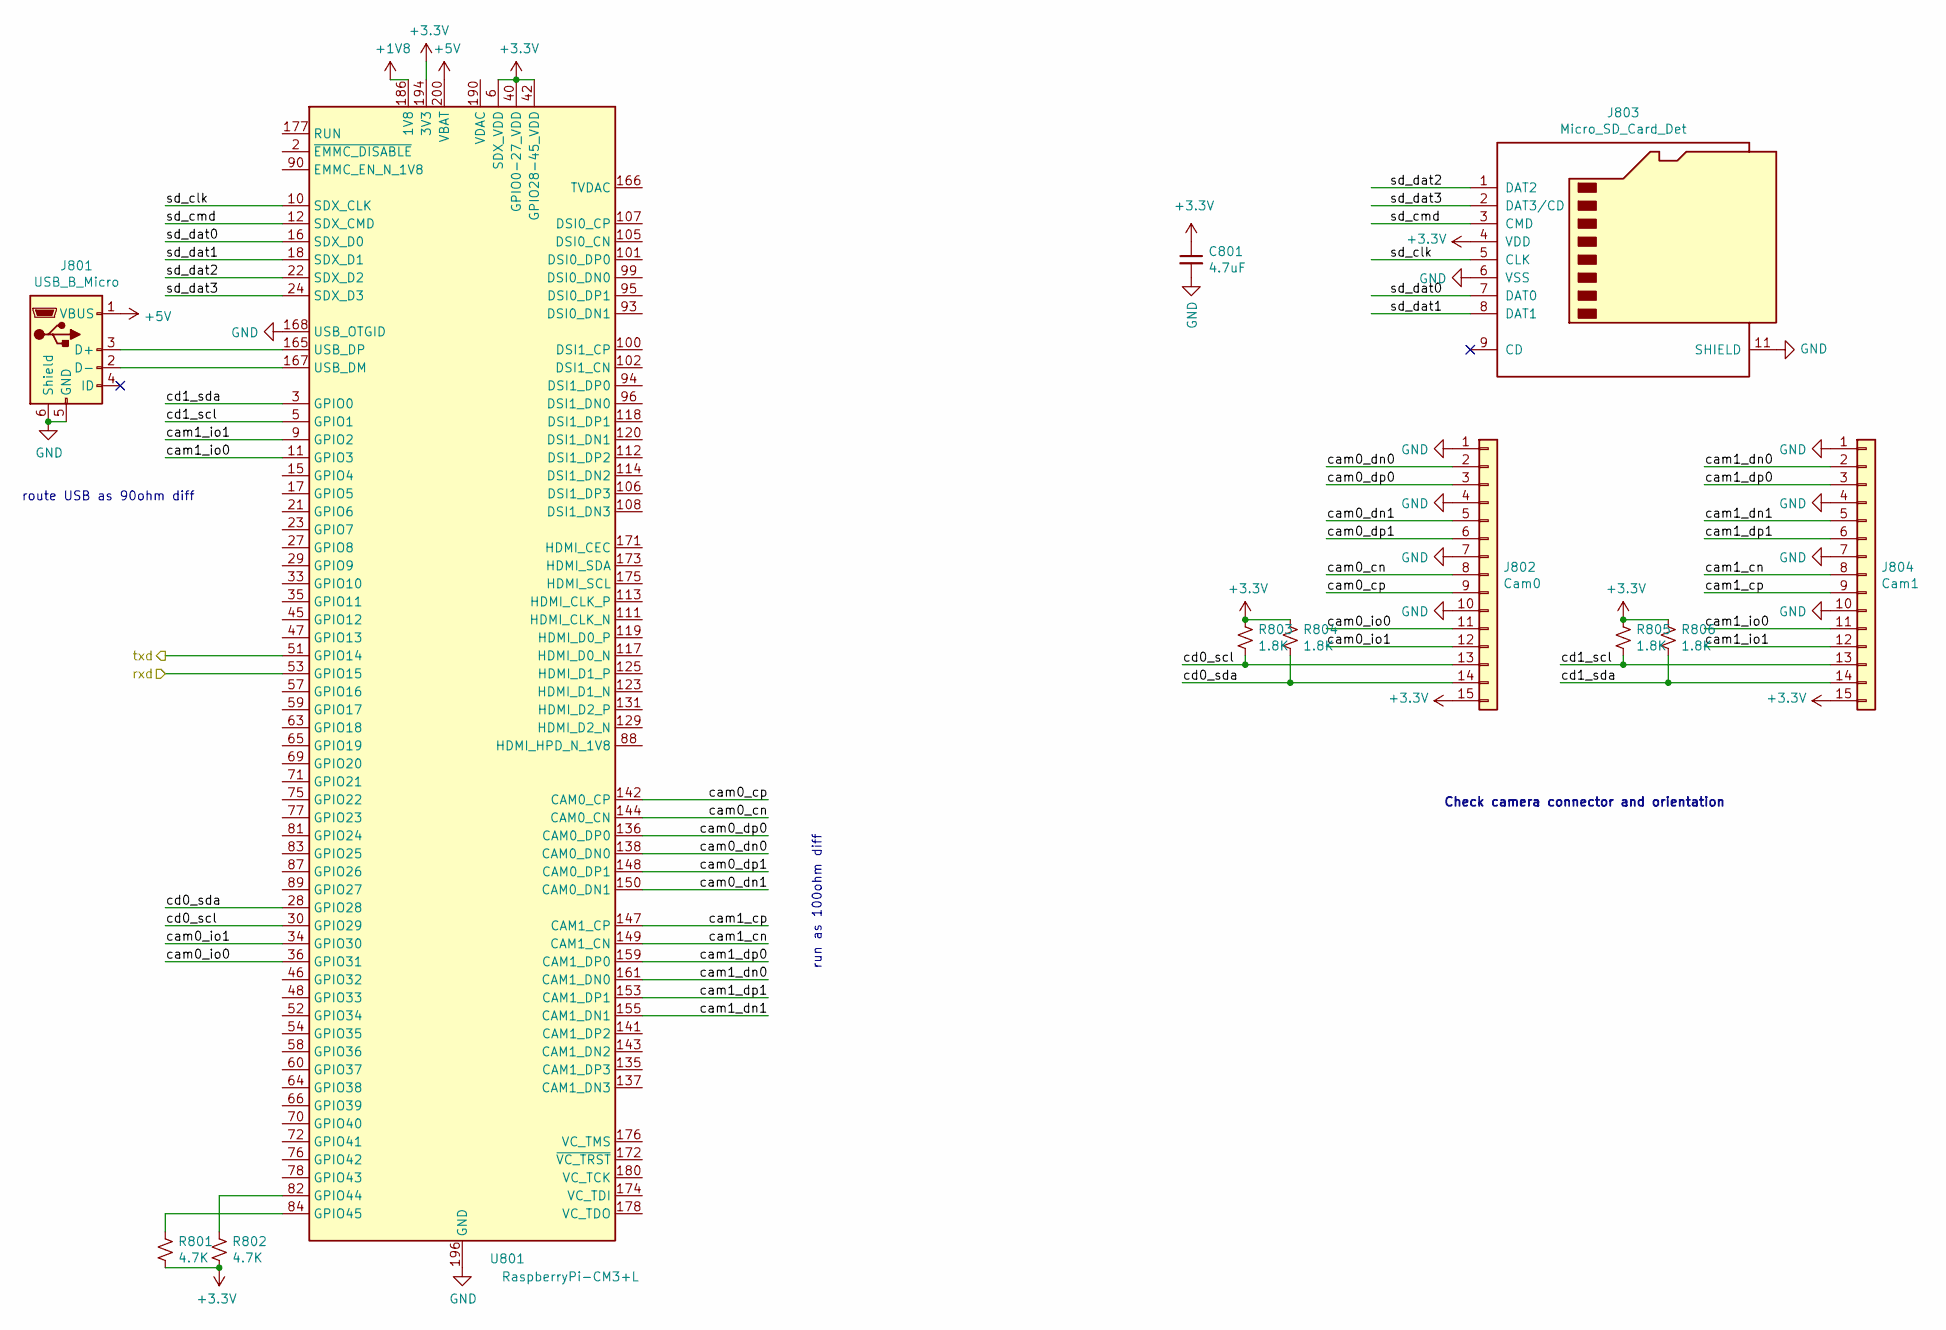
[picture p17: schematic RaspberryPiCM3+.sch]

Parts:
C801: 4.7uF; C_0603_1608Metric
J801: USB_B_Micro; USB_Micro-B_Wuerth_629105150521
J802: Cam0; Molex_200528-0150_1x15-1MP_P1.00mm_Horizontal
J803: Micro_SD_Card_Det; MEM2061
J804: Cam1; Molex_200528-0150_1x15-1MP_P1.00mm_Horizontal
R801, R802: 4.7K; R_0402_1005Metric
R803, R804, R805, R806: 1.8K; R_0402_1005Metric
U801: RaspberryPi-CM3+L; Conn_TE-DDR2-SODIMM-0.6-200P-doublesided

Connections:
+1V8: U801.183 (1V8), U801.184 (1V8), U801.185 (1V8), U801.186 (1V8); also elsewhere on the board
+5V: J801.1 (VBUS), U801.197 (VBAT), U801.198 (VBAT), U801.199 (VBAT), U801.200 (VBAT); also elsewhere on the board
/RaspberryPIZero/rxd: U801.53 (GPIO15); also elsewhere on the board
/RaspberryPiCM3+/cam0_cn: J802.8, U801.144 (CAM0_CN)
/RaspberryPiCM3+/cam0_cp: J802.9, U801.142 (CAM0_CP)
/RaspberryPiCM3+/cam0_dn0: J802.2, U801.138 (CAM0_DN0)
/RaspberryPiCM3+/cam0_dn1: J802.5, U801.150 (CAM0_DN1)
/RaspberryPiCM3+/cam0_dp0: J802.3, U801.136 (CAM0_DP0)
/RaspberryPiCM3+/cam0_dp1: J802.6, U801.148 (CAM0_DP1)
/RaspberryPiCM3+/cam0_io0: J802.11, U801.36 (GPIO31)
/RaspberryPiCM3+/cam0_io1: J802.12, U801.34 (GPIO30)
/RaspberryPiCM3+/cam1_cn: J804.8, U801.149 (CAM1_CN)
/RaspberryPiCM3+/cam1_cp: J804.9, U801.147 (CAM1_CP)
/RaspberryPiCM3+/cam1_dn0: J804.2, U801.161 (CAM1_DN0)
/RaspberryPiCM3+/cam1_dn1: J804.5, U801.155 (CAM1_DN1)
/RaspberryPiCM3+/cam1_dp0: J804.3, U801.159 (CAM1_DP0)
/RaspberryPiCM3+/cam1_dp1: J804.6, U801.153 (CAM1_DP1)
/RaspberryPiCM3+/cam1_io0: J804.11, U801.11 (GPIO3)
/RaspberryPiCM3+/cam1_io1: J804.12, U801.9 (GPIO2)
/RaspberryPiCM3+/cd0_scl: J802.13, R803.2, U801.30 (GPIO29)
/RaspberryPiCM3+/cd0_sda: J802.14, R804.2, U801.28 (GPIO28)
/RaspberryPiCM3+/cd1_scl: J804.13, R805.2, U801.5 (GPIO1)
/RaspberryPiCM3+/cd1_sda: J804.14, R806.2, U801.3 (GPIO0)
/RaspberryPiCM3+/sd_clk: J803.5 (CLK), U801.10 (SDX_CLK)
/RaspberryPiCM3+/sd_cmd: J803.3 (CMD), U801.12 (SDX_CMD)
/RaspberryPiCM3+/sd_dat0: J803.7 (DAT0), U801.16 (SDX_D0)
/RaspberryPiCM3+/sd_dat1: J803.8 (DAT1), U801.18 (SDX_D1)
/RaspberryPiCM3+/sd_dat2: J803.1 (DAT2), U801.22 (SDX_D2)
/RaspberryPiCM3+/sd_dat3: J803.2 (DAT3/CD), U801.24 (SDX_D3)
/micro/rxd: U801.51 (GPIO14); also elsewhere on the board
unnamed: J801.2 (D-), U801.167 (USB_DM)
unnamed: J801.3 (D+), U801.165 (USB_DP)
unnamed: R801.1, U801.84 (GPIO45)
unnamed: R802.1, U801.82 (GPIO44)
unnamed: U801.189 (VDAC), U801.190 (VDAC)

Notes on the sheet:
route USB as 90ohm diff
run as 100ohm diff
Check camera connector and orientation

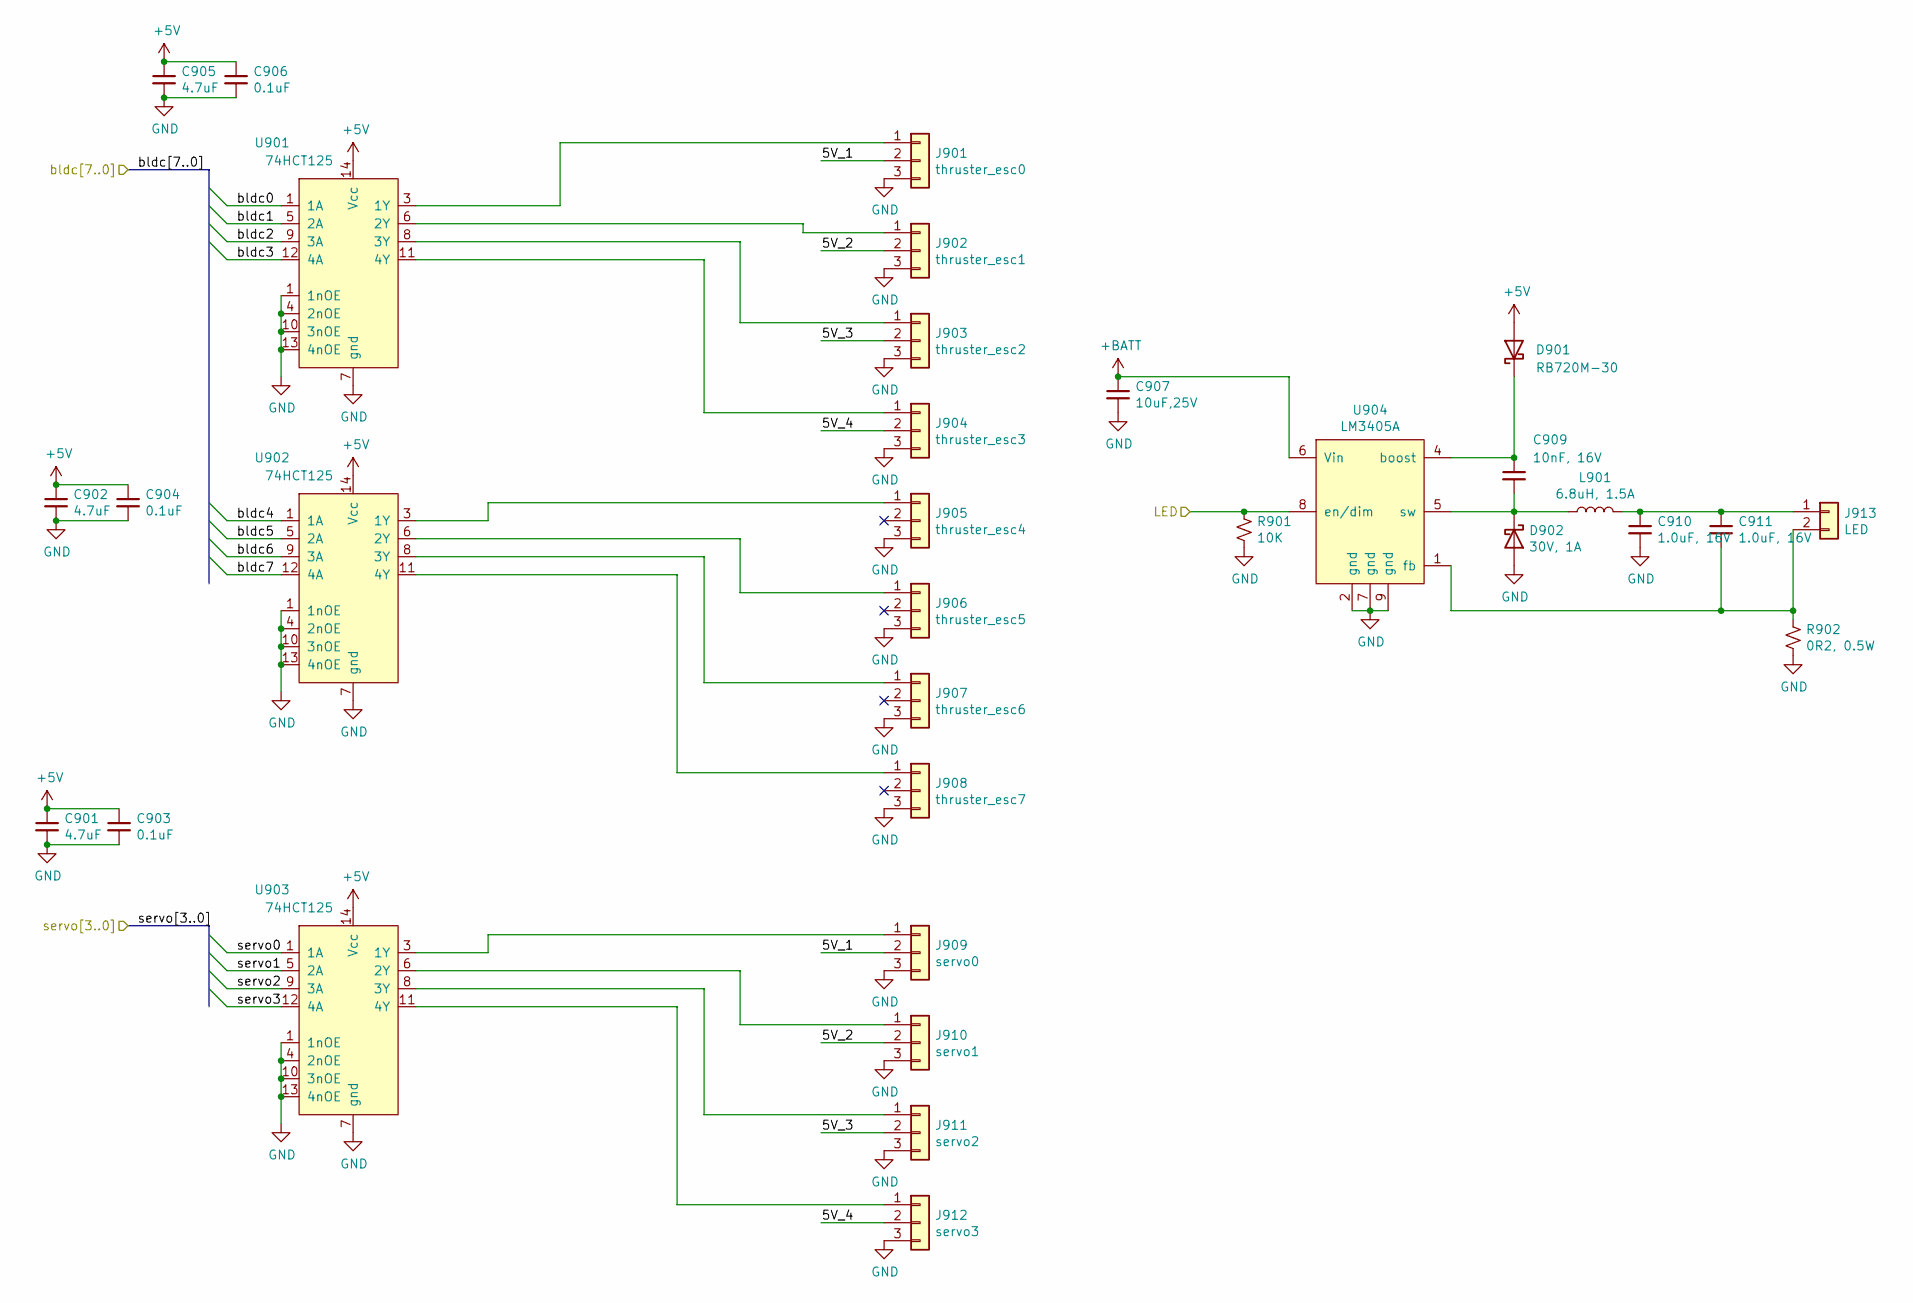
[picture p18: schematic ESC_servo_lights.sch]

Parts:
C901, C902, C905: 4.7uF; C_0603_1608Metric
C903, C904, C906: 0.1uF; C_0402_1005Metric
C907: 10uF,25V; C_1206_3216Metric
C909: 10nF, 16V; C_0402_1005Metric
C910, C911: 1.0uF, 16V; C_0603_1608Metric
D901: RB720M-30; SOD-923
D902: 30V, 1A; DO-219AD
J901: thruster_esc0; PinHeader_1x03_P2.54mm_Vertical
J902: thruster_esc1; PinHeader_1x03_P2.54mm_Vertical
J903: thruster_esc2; PinHeader_1x03_P2.54mm_Vertical
J904: thruster_esc3; PinHeader_1x03_P2.54mm_Vertical
J905: thruster_esc4; PinHeader_1x03_P2.54mm_Vertical
J906: thruster_esc5; PinHeader_1x03_P2.54mm_Vertical
J907: thruster_esc6; PinHeader_1x03_P2.54mm_Vertical
J908: thruster_esc7; PinHeader_1x03_P2.54mm_Vertical
J909: servo0; PinHeader_1x03_P2.54mm_Vertical
J910: servo1; PinHeader_1x03_P2.54mm_Vertical
J911: servo2; PinHeader_1x03_P2.54mm_Vertical
J912: servo3; PinHeader_1x03_P2.54mm_Vertical
J913: LED; Hirose_DF13C_CL535-0402-2-51_1x02-1MP_P1.25mm_Vertical
L901: 6.8uH, 1.5A; L_TDK_VLS3012
R901: 10K; R_0402_1005Metric
R902: 0R2, 0.5W; R_0805_2012Metric
U901, U902, U903: 74HCT125; SO-14_3.9x8.65mm_P1.27mm
U904: LM3405A; VSSOP-8_3.0x3.0mm_P0.65mm-EP

Connections:
+5V: C901.1, C902.1, C903.1, C904.1, C905.1, C906.1, D901.2 (A), U901.14 (Vcc), U902.14 (Vcc), U903.14 (Vcc); also elsewhere on the board
+BATT: C907.1, U904.6 (Vin); also elsewhere on the board
/ESC_servo_lights/5V_1: J901.2, J909.2
/ESC_servo_lights/5V_2: J902.2, J910.2
/ESC_servo_lights/5V_3: J903.2, J911.2
/ESC_servo_lights/5V_4: J904.2, J912.2
/ESC_servo_lights/bldc1: U901.5 (2A); also elsewhere on the board
/ESC_servo_lights/bldc2: U901.9 (3A); also elsewhere on the board
/ESC_servo_lights/bldc3: U901.12 (4A); also elsewhere on the board
/ESC_servo_lights/bldc5: U902.5 (2A); also elsewhere on the board
/ESC_servo_lights/bldc6: U902.9 (3A); also elsewhere on the board
/ESC_servo_lights/bldc7: U902.12 (4A); also elsewhere on the board
/ESC_servo_lights/servo1: U903.5 (2A); also elsewhere on the board
/ESC_servo_lights/servo2: U903.9 (3A); also elsewhere on the board
/ESC_servo_lights/servo3: U903.12 (4A); also elsewhere on the board
/lights: R901.1, U904.8 (en/dim); also elsewhere on the board
unnamed: C909.1, D901.1 (K), U904.4 (boost)
unnamed: C909.2, D902.1 (K), L901.1, U904.5 (sw)
unnamed: C910.1, C911.1, J913.1, L901.2
unnamed: C911.2, J913.2, R902.1, U904.1 (fb)
unnamed: J901.1, U901.3 (1Y)
unnamed: J902.1, U901.6 (2Y)
unnamed: J903.1, U901.8 (3Y)
unnamed: J904.1, U901.11 (4Y)
unnamed: J905.1, U902.3 (1Y)
unnamed: J906.1, U902.6 (2Y)
unnamed: J907.1, U902.8 (3Y)
unnamed: J908.1, U902.11 (4Y)
unnamed: J909.1, U903.3 (1Y)
unnamed: J910.1, U903.6 (2Y)
unnamed: J911.1, U903.8 (3Y)
unnamed: J912.1, U903.11 (4Y)

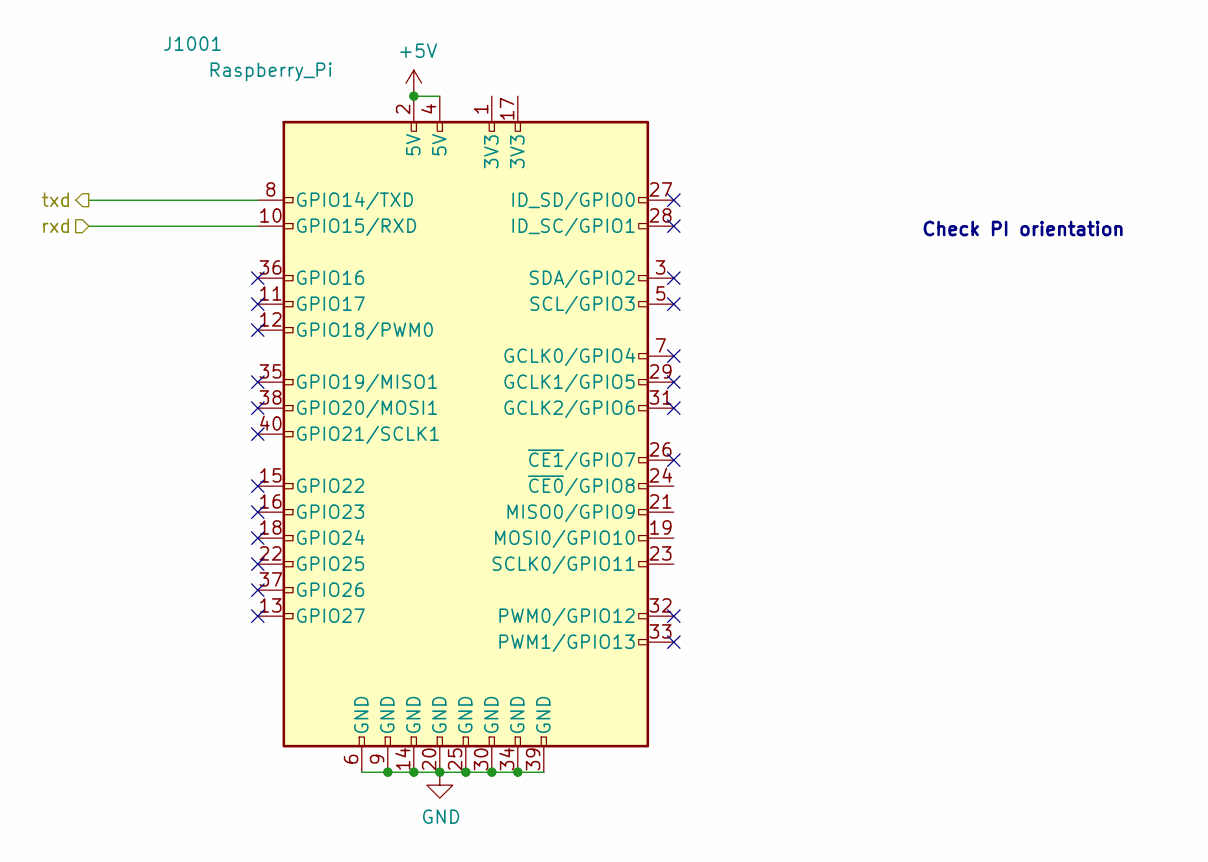
[picture p19: schematic RaspberryPIZero.sch]

Parts:
J1001: Raspberry_Pi; Raspberry_Pi_Zero_Socketed_THT_MountingHoles_SMT

Connections:
+5V: J1001.2 (5V), J1001.4 (5V); also elsewhere on the board
/RaspberryPIZero/rxd: J1001.10 (GPIO15/RXD); also elsewhere on the board
/micro/rxd: J1001.8 (GPIO14/TXD); also elsewhere on the board

Notes on the sheet:
Check PI orientation

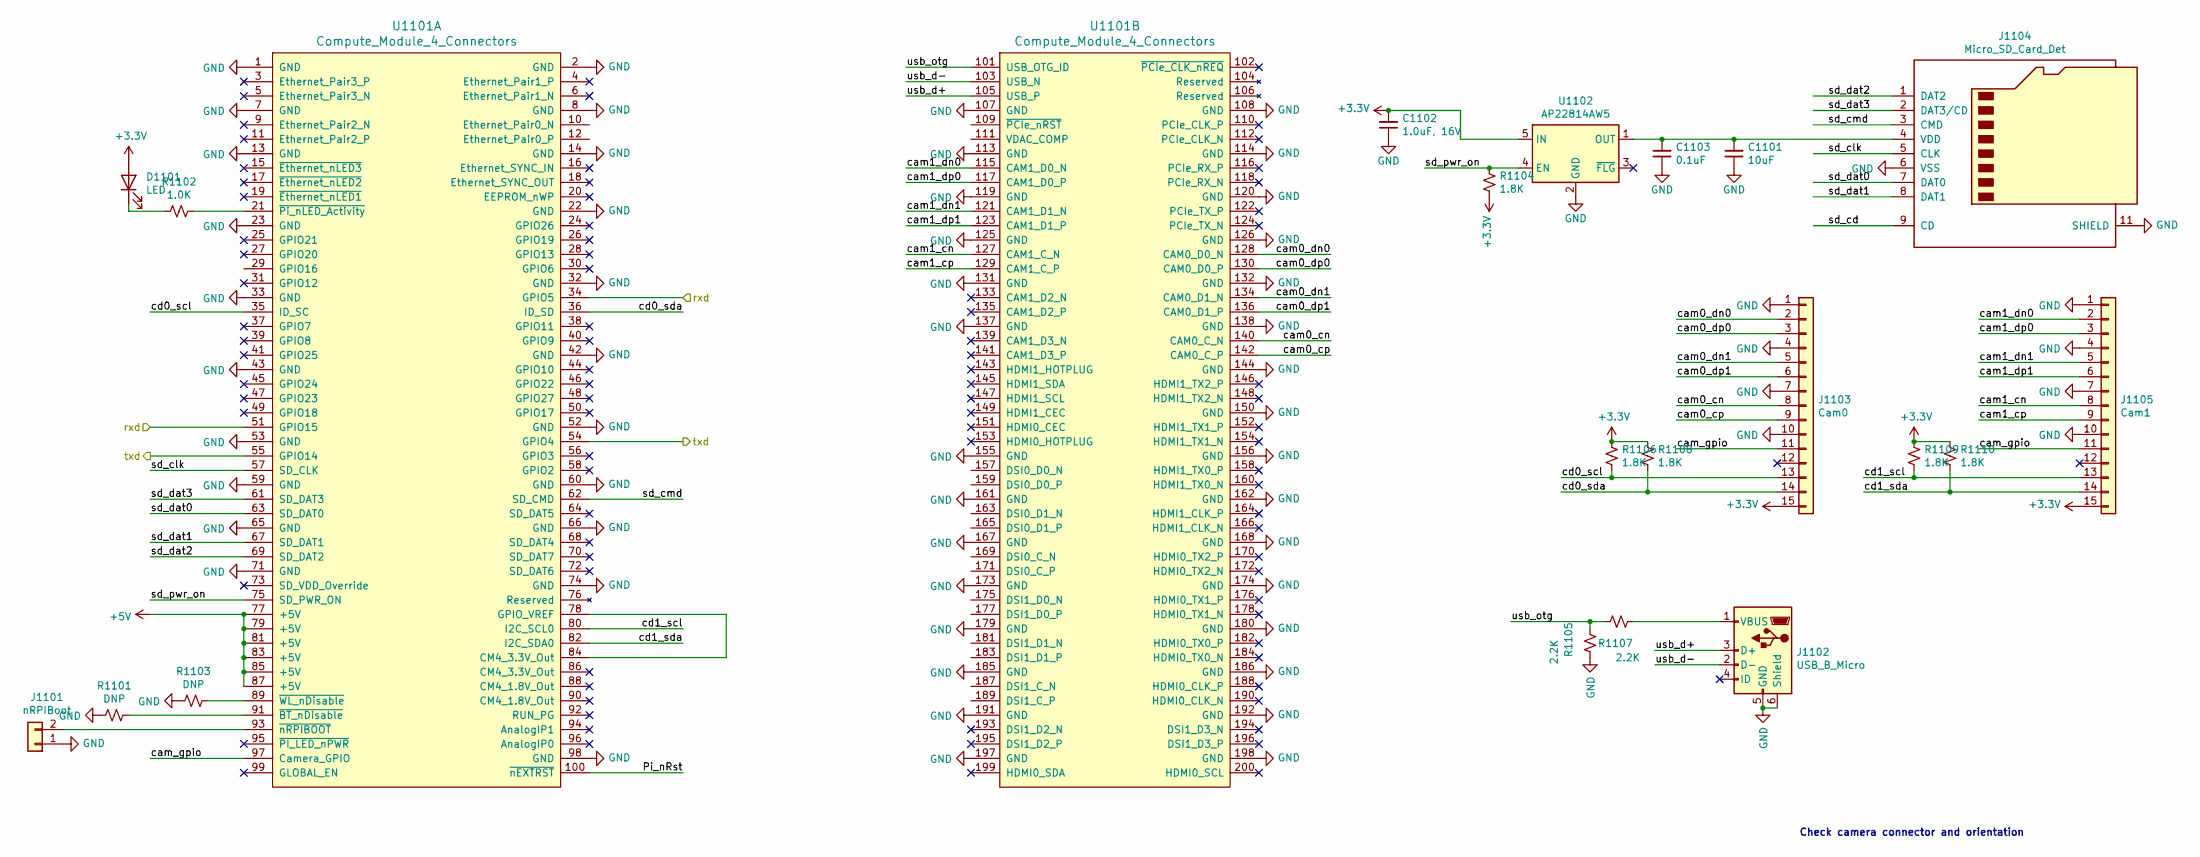
[picture p20: schematic RaspberryPiCM4.sch]

Parts:
C1101: 10uF; C_0805_2012Metric
C1102: 1.0uF, 16V; C_0603_1608Metric
C1103: 0.1uF; C_0402_1005Metric
D1101: LED; LED_0402_1005Metric
J1101: nRPIBoot; PinHeader_1x02_P1.27mm_Vertical
J1102: USB_B_Micro; USB_Micro-B_Wuerth_629105150521
J1103: Cam0; Molex_200528-0150_1x15-1MP_P1.00mm_Horizontal
J1104: Micro_SD_Card_Det; MEM2061
J1105: Cam1; Molex_200528-0150_1x15-1MP_P1.00mm_Horizontal
R1101, R1103: DNP; R_0402_1005Metric
R1102: 1.0K; R_0402_1005Metric
R1104, R1106, R1108, R1109, R1110: 1.8K; R_0402_1005Metric
R1105, R1107: 2.2K; R_0402_1005Metric
U1101: Compute_Module_4_Connectors; CM4
U1102: AP22814AW5; SOT-23-5

Connections:
+5V: U1101.77 (+5V), U1101.79 (+5V), U1101.81 (+5V), U1101.83 (+5V), U1101.85 (+5V), U1101.87 (+5V); also elsewhere on the board
/RaspberryPIZero/rxd: U1101.34 (GPIO5), U1101.51 (GPIO15); also elsewhere on the board
/RaspberryPiCM4/Pi_nRst: U1101.100 (~nEXTRST)
/RaspberryPiCM4/cam0_cn: J1103.8, U1101.140 (CAM0_C_N)
/RaspberryPiCM4/cam0_cp: J1103.9, U1101.142 (CAM0_C_P)
/RaspberryPiCM4/cam0_dn0: J1103.2, U1101.128 (CAM0_D0_N)
/RaspberryPiCM4/cam0_dn1: J1103.5, U1101.134 (CAM0_D1_N)
/RaspberryPiCM4/cam0_dp0: J1103.3, U1101.130 (CAM0_D0_P)
/RaspberryPiCM4/cam0_dp1: J1103.6, U1101.136 (CAM0_D1_P)
/RaspberryPiCM4/cam1_cn: J1105.8, U1101.127 (CAM1_C_N)
/RaspberryPiCM4/cam1_cp: J1105.9, U1101.129 (CAM1_C_P)
/RaspberryPiCM4/cam1_dn0: J1105.2, U1101.115 (CAM1_D0_N)
/RaspberryPiCM4/cam1_dn1: J1105.5, U1101.121 (CAM1_D1_N)
/RaspberryPiCM4/cam1_dp0: J1105.3, U1101.117 (CAM1_D0_P)
/RaspberryPiCM4/cam1_dp1: J1105.6, U1101.123 (CAM1_D1_P)
/RaspberryPiCM4/cam_gpio: J1103.11, J1105.11, U1101.97 (Camera_GPIO)
/RaspberryPiCM4/cd0_scl: J1103.13, R1106.2, U1101.35 (ID_SC)
/RaspberryPiCM4/cd0_sda: J1103.14, R1108.2, U1101.36 (ID_SD)
/RaspberryPiCM4/cd1_scl: J1105.13, R1109.2, U1101.80 (I2C_SCL0)
/RaspberryPiCM4/cd1_sda: J1105.14, R1110.2, U1101.82 (I2C_SDA0)
/RaspberryPiCM4/sd_cd: J1104.9 (CD)
/RaspberryPiCM4/sd_clk: J1104.5 (CLK), U1101.57 (SD_CLK)
/RaspberryPiCM4/sd_cmd: J1104.3 (CMD), U1101.62 (SD_CMD)
/RaspberryPiCM4/sd_dat0: J1104.7 (DAT0), U1101.63 (SD_DAT0)
/RaspberryPiCM4/sd_dat1: J1104.8 (DAT1), U1101.67 (SD_DAT1)
/RaspberryPiCM4/sd_dat2: J1104.1 (DAT2), U1101.69 (SD_DAT2)
/RaspberryPiCM4/sd_dat3: J1104.2 (DAT3/CD), U1101.61 (SD_DAT3)
/RaspberryPiCM4/sd_pwr_on: R1104.1, U1101.75 (SD_PWR_ON), U1102.4 (EN)
/RaspberryPiCM4/usb_d+: J1102.3 (D+), U1101.105 (USB_P)
/RaspberryPiCM4/usb_d-: J1102.2 (D-), U1101.103 (USB_N)
/RaspberryPiCM4/usb_otg: R1105.1, R1107.1, U1101.101 (USB_OTG_ID)
/micro/rxd: U1101.54 (GPIO4), U1101.55 (GPIO14); also elsewhere on the board
unnamed: C1101.2, C1103.2, J1104.4 (VDD), U1102.1 (OUT)
unnamed: D1101.1 (K), R1102.2
unnamed: J1101.2, U1101.93 (~nRPIBOOT)
unnamed: J1102.1 (VBUS), R1107.2
unnamed: R1101.1, U1101.91 (~BT_nDisable)
unnamed: R1102.1, U1101.21 (~Pi_nLED_Activity)
unnamed: R1103.1, U1101.89 (~WL_nDisable)
unnamed: U1101.78 (GPIO_VREF), U1101.84 (CM4_3.3V_Out)

Notes on the sheet:
Check camera connector and orientation

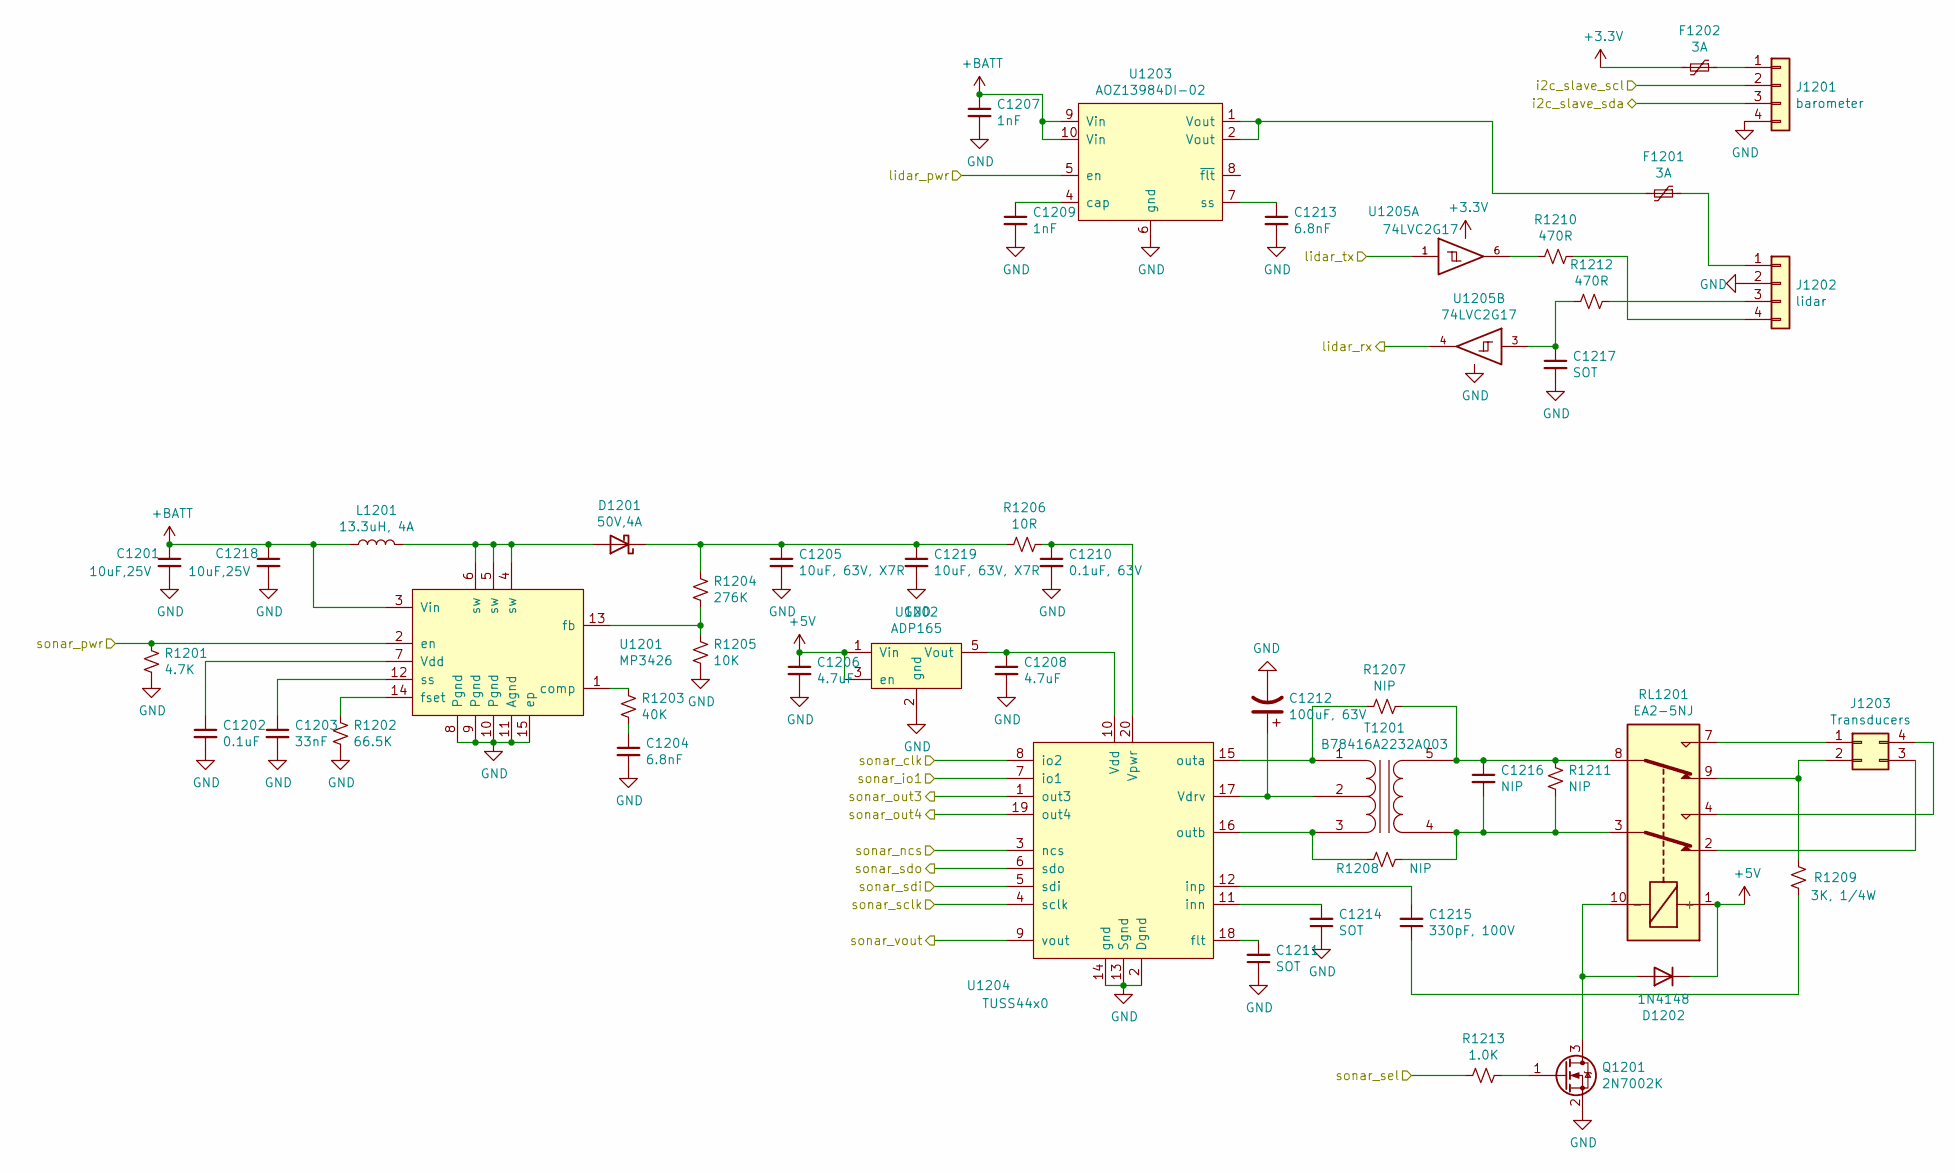
[picture p21: schematic water_sensors.sch]

Parts:
C1201, C1218: 10uF,25V; C_1206_3216Metric
C1202: 0.1uF; C_0402_1005Metric
C1203: 33nF; C_0402_1005Metric
C1204, C1213: 6.8nF; C_0402_1005Metric
C1205, C1219: 10uF, 63V, X7R; C_1210_3225Metric
C1206, C1208: 4.7uF; C_0603_1608Metric
C1207, C1209: 1nF; C_0402_1005Metric
C1210: 0.1uF, 63V; C_1206_3216Metric
C1211, C1214: SOT; C_0603_1608Metric
C1212: 100uF, 63V; CP_MS10
C1215: 330pF, 100V; R_0805_2012Metric
C1216: NIP; C_0603_1608Metric
C1217: SOT; C_0402_1005Metric
D1201: 50V,4A; D_SMC
D1202: 1N4148; D_SOD-123
F1201, F1202: 3A; 2016
J1201: barometer; Hirose_DF13C_CL535-0404-8-51_1x04-1MP_P1.25mm_Vertical
J1202: lidar; Hirose_DF13C_CL535-0404-8-51_1x04-1MP_P1.25mm_Vertical
J1203: Transducers; Hirose_DF11-4DP-2DSA_2x02_P2.00mm_Vertical
L1201: 13.3uH, 4A; L_7447706150
Q1201: 2N7002K; SOT-23
R1201: 4.7K; R_0402_1005Metric
R1202: 66.5K; R_0402_1005Metric
R1203: 40K; R_0402_1005Metric
R1204: 276K; R_0402_1005Metric
R1205: 10K; R_0402_1005Metric
R1206: 10R; R_0603_1608Metric
R1207, R1208: NIP; R_1206_3216Metric
R1209: 3K, 1/4W; R_1206_3216Metric
R1210, R1212: 470R; R_0402_1005Metric
R1211: NIP; R_0603_1608Metric
R1213: 1.0K; R_0402_1005Metric
RL1201: EA2-5NJ
T1201: B78416A2232A003; XFRMR_B78416
U1201: MP3426; DFN-14-1EP_3x4mm_P0.5mm_EP1.7x3.3mm
U1202: ADP165; SOT-23-5
U1203: AOZ13984DI-02; DFN-12-1EP_3x3mm_P0.5mm_EP1.5x2.5mm
U1204: TUSS44x0; WQFN-20
U1205: 74LVC2G17; SOT-363_SC-70-6

Connections:
+5V: C1206.1, D1202.1 (K), RL1201.1 (+), U1202.1 (Vin), U1202.3 (en); also elsewhere on the board
+BATT: C1201.1, C1207.1, C1218.1, L1201.1, U1201.3 (Vin), U1203.9 (Vin), U1203.10 (Vin); also elsewhere on the board
/micro/lidar_pwr: U1205.1; also elsewhere on the board
/micro/lidar_rx: U1205.4; also elsewhere on the board
/micro/sonar_ana_in: U1204.9 (vout); also elsewhere on the board
/micro/sonar_clk: U1204.8 (io2); also elsewhere on the board
/micro/sonar_io1: U1204.7 (io1); also elsewhere on the board
/micro/sonar_out3: U1204.1 (out3); also elsewhere on the board
/micro/sonar_out4: U1204.19 (out4); also elsewhere on the board
/micro/sonar_pwr: R1201.2, U1201.2 (en); also elsewhere on the board
/micro/sonar_sel: R1213.2; also elsewhere on the board
/scl1: J1201.2; also elsewhere on the board
/sda1: J1201.3; also elsewhere on the board
/water_sensors/lidar_pwr: U1203.5 (en); also elsewhere on the board
/water_sensors/sonar_ncs: U1204.3 (ncs); also elsewhere on the board
/water_sensors/sonar_sclk: U1204.4 (sclk); also elsewhere on the board
/water_sensors/sonar_sdi: U1204.5 (sdi); also elsewhere on the board
/water_sensors/sonar_sdo: U1204.6 (sdo); also elsewhere on the board
unnamed: C1202.1, U1201.7 (Vdd)
unnamed: C1203.1, U1201.12 (ss)
unnamed: C1204.1, R1203.1
unnamed: C1205.1, C1219.1, D1201.1 (K), R1204.2, R1206.2
unnamed: C1208.1, U1202.5 (Vout), U1204.10 (Vdd)
unnamed: C1209.1, U1203.4 (cap)
unnamed: C1210.1, R1206.1, U1204.20 (Vpwr)
unnamed: C1211.2, U1204.18 (flt)
unnamed: C1212.1, T1201.2 (PM), U1204.17 (Vdrv)
unnamed: C1213.1, U1203.7 (ss)
unnamed: C1214.2, U1204.11 (inn)
unnamed: C1215.1, R1209.1
unnamed: C1215.2, U1204.12 (inp)
unnamed: C1216.1, R1207.1, R1211.1, RL1201.8, T1201.5 (S2)
unnamed: C1216.2, R1208.1, R1211.2, RL1201.3, T1201.4 (S1)
unnamed: C1217.1, R1212.2, U1205.3
unnamed: D1201.2 (A), L1201.2, U1201.4 (sw~), U1201.5 (sw), U1201.6 (sw)
unnamed: D1202.2 (A), Q1201.3 (D), RL1201.10 (-)
unnamed: F1201.1, J1202.1
unnamed: F1201.2, U1203.1 (Vout), U1203.2 (Vout)
unnamed: F1202.1, J1201.1
unnamed: J1202.3, R1212.1
unnamed: J1202.4, R1210.1
unnamed: J1203.1, RL1201.7
unnamed: J1203.2, R1209.2, RL1201.9
unnamed: J1203.3, RL1201.2
unnamed: J1203.4, RL1201.4
unnamed: Q1201.1 (G), R1213.1
unnamed: R1202.2, U1201.14 (fset)
unnamed: R1203.2, U1201.1 (comp)
unnamed: R1204.1, R1205.2, U1201.13 (fb)
unnamed: R1207.2, T1201.1 (PR1), U1204.15 (outa)
unnamed: R1208.2, T1201.3 (PR2), U1204.16 (outb)
unnamed: R1210.2, U1205.6
