highpeng/sub/electrical/sub board 5.99/board/board.kicad_pcb

## KiCad design electrical/sub board 5.99/board/board.kicad_pcb (continued)

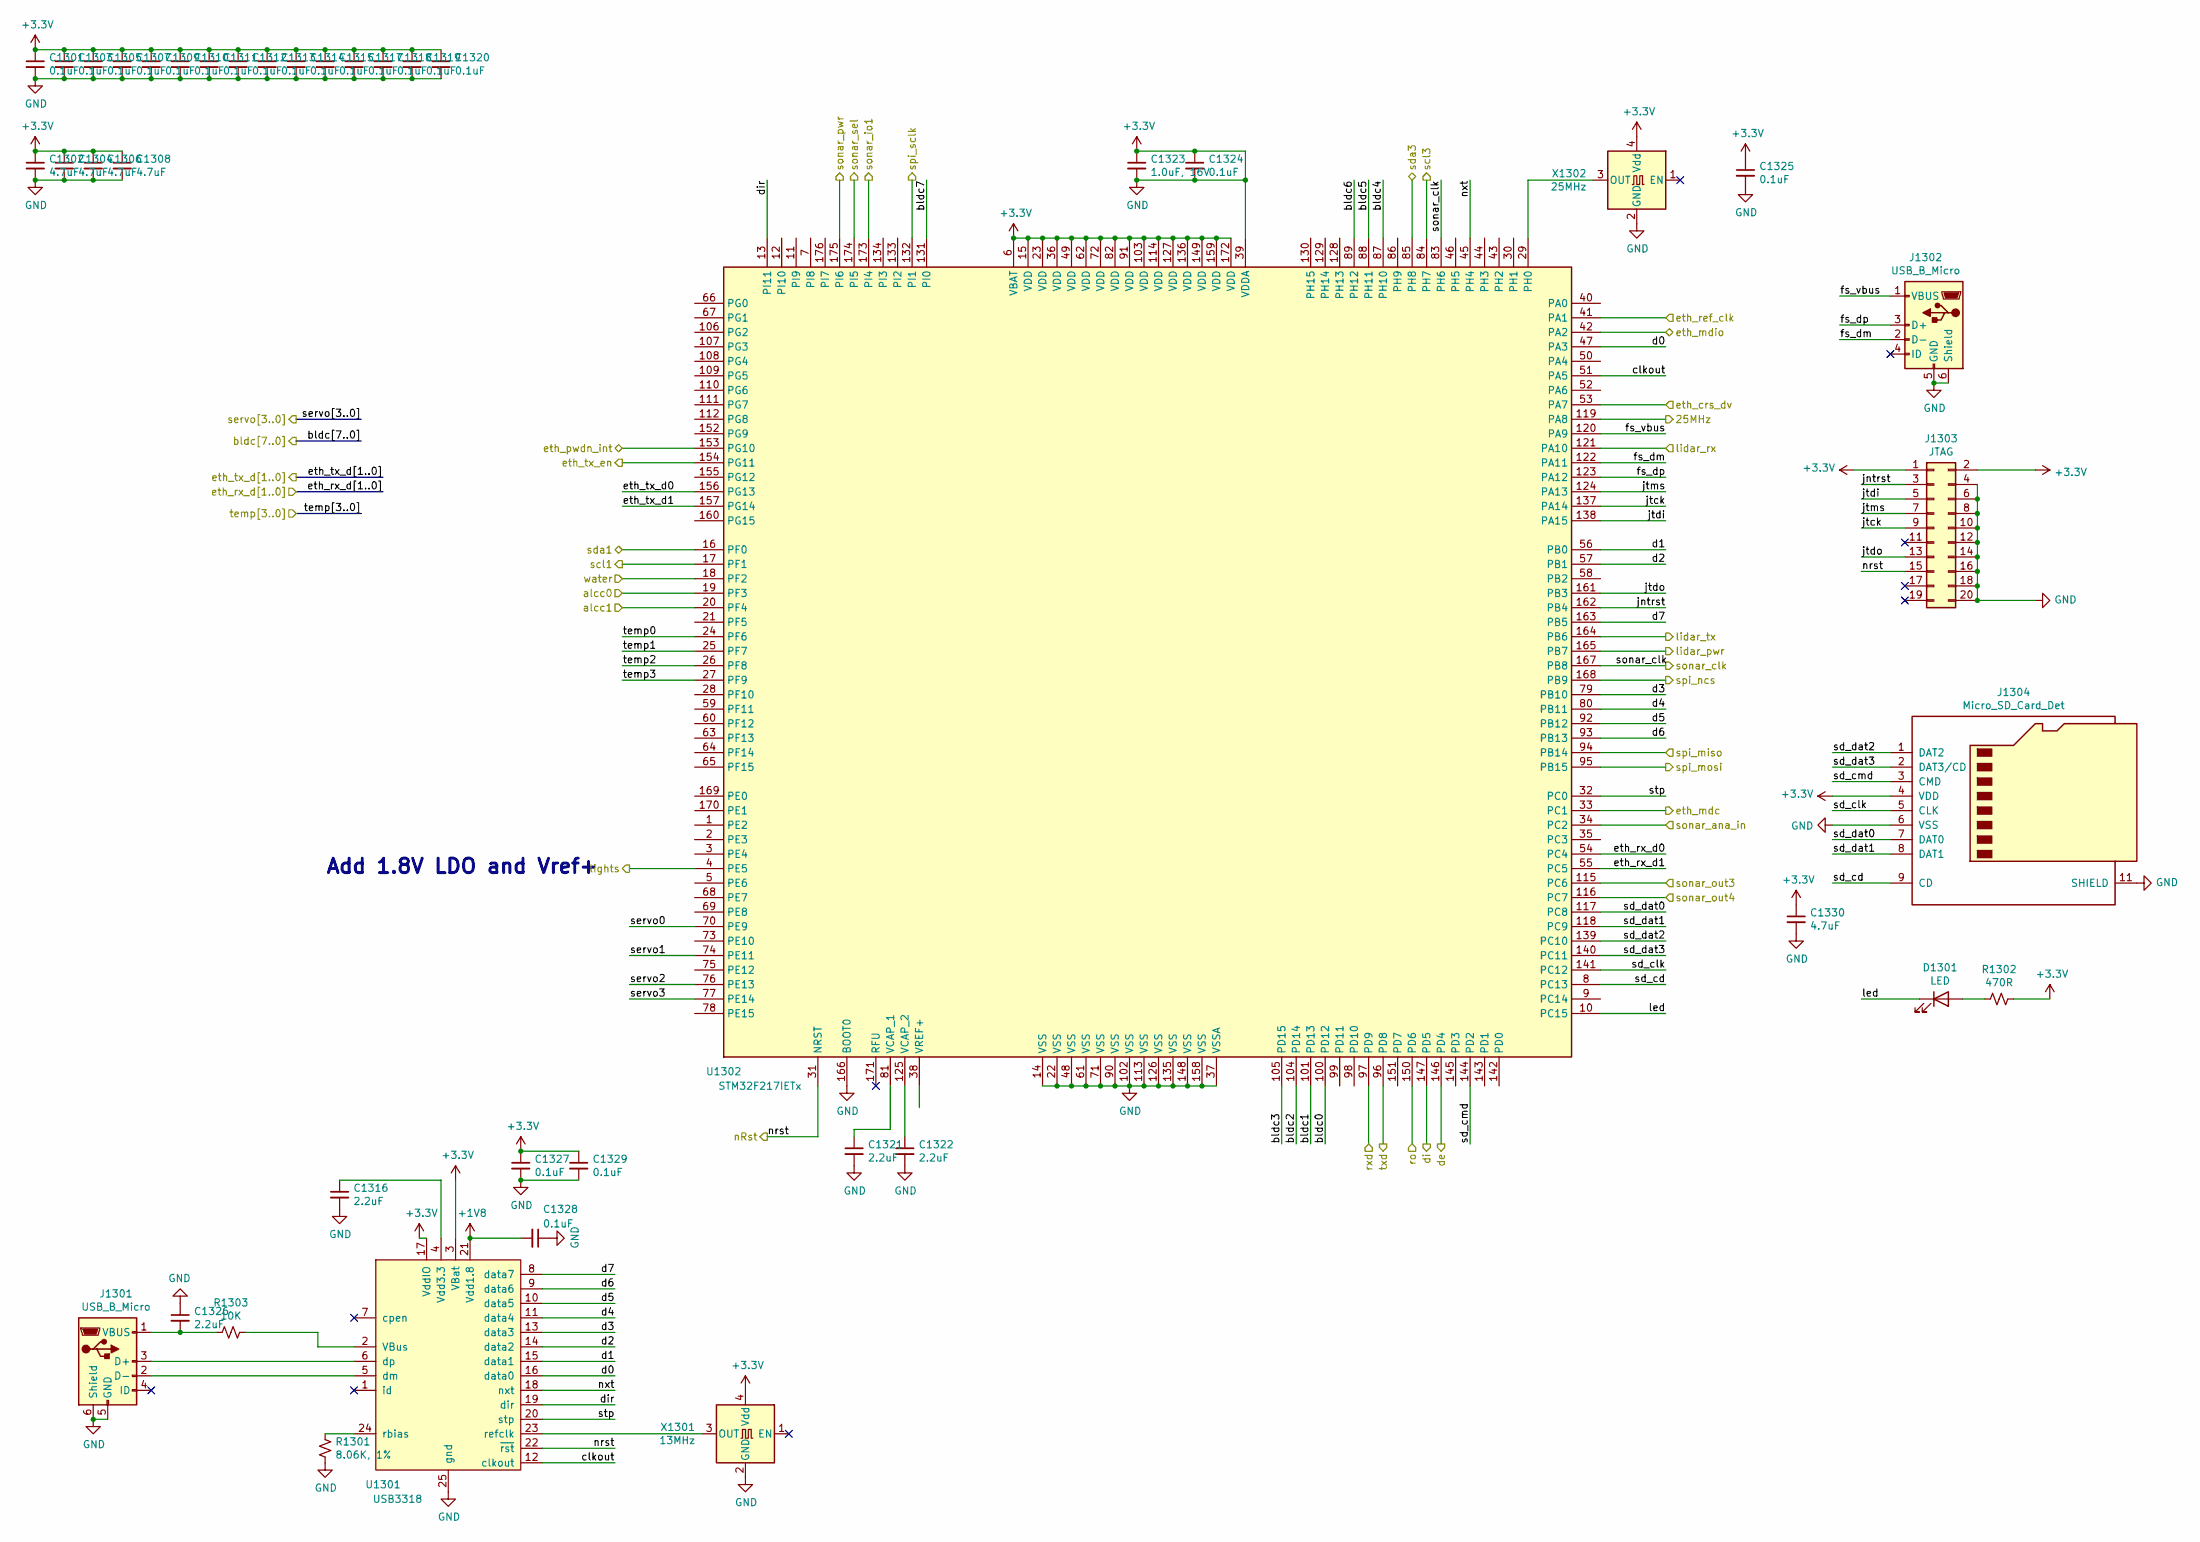
[picture p22: schematic micro.sch]

Parts:
C1301, C1303, C1305, C1307, C1309, C1310, C1311, C1312, C1313, C1314, C1315, C1317, C1318, C1319, C1320, C1324, C1325, C1327, C1328, C1329: 0.1uF; C_0402_1005Metric
C1302, C1304, C1306, C1308, C1330: 4.7uF; C_0603_1608Metric
C1316, C1321, C1322, C1326: 2.2uF; C_0603_1608Metric
C1323: 1.0uF, 16V; C_0603_1608Metric
D1301: LED; LED_0402_1005Metric
J1301, J1302: USB_B_Micro; USB_Micro-B_Wuerth_629105150521
J1303: JTAG; IDC-Header_2x10_P2.54mm_Vertical
J1304: Micro_SD_Card_Det; MEM2061
R1301: 8.06K, 1%; R_0402_1005Metric
R1302: 470R; R_0402_1005Metric
R1303: 10K; R_0402_1005Metric
U1301: USB3318; QFN-24-1EP_4x4mm_P0.5mm_EP2.6x2.6mm
U1302: STM32F217IETx; LQFP-176_24x24mm_P0.5mm
X1301: 13MHz; 831056290
X1302: 25MHz; ASFL1

Connections:
+1V8: C1328.2, U1301.21 (Vdd1.8); also elsewhere on the board
/ESC_servo_lights/bldc0: U1302.100 (PD12)
/ESC_servo_lights/bldc1: U1302.101 (PD13); also elsewhere on the board
/ESC_servo_lights/bldc2: U1302.104 (PD14); also elsewhere on the board
/ESC_servo_lights/bldc3: U1302.105 (PD15); also elsewhere on the board
/ESC_servo_lights/bldc4: U1302.87 (PH10)
/ESC_servo_lights/bldc5: U1302.88 (PH11); also elsewhere on the board
/ESC_servo_lights/bldc6: U1302.89 (PH12); also elsewhere on the board
/ESC_servo_lights/bldc7: U1302.131 (PI0); also elsewhere on the board
/ESC_servo_lights/servo0: U1302.70 (PE9)
/ESC_servo_lights/servo1: U1302.74 (PE11); also elsewhere on the board
/ESC_servo_lights/servo2: U1302.76 (PE13); also elsewhere on the board
/ESC_servo_lights/servo3: U1302.77 (PE14); also elsewhere on the board
/RS485/DE: U1302.146 (PD4); also elsewhere on the board
/RS485/DI: U1302.147 (PD5); also elsewhere on the board
/RS485/RO: U1302.150 (PD6); also elsewhere on the board
/RaspberryPIZero/rxd: U1302.96 (PD8); also elsewhere on the board
/battery/alcc: U1302.19 (PF3); also elsewhere on the board
/ethernet/50MHz: U1302.41 (PA1); also elsewhere on the board
/ethernet/crs_dv: U1302.53 (PA7); also elsewhere on the board
/internal_sensors/temp0: U1302.24 (PF6); also elsewhere on the board
/internal_sensors/temp1: U1302.25 (PF7); also elsewhere on the board
/internal_sensors/temp2: U1302.26 (PF8); also elsewhere on the board
/internal_sensors/temp3: U1302.27 (PF9); also elsewhere on the board
/internal_sensors/water: U1302.18 (PF2); also elsewhere on the board
/lights: U1302.4 (PE5); also elsewhere on the board
/micro/25MHz: U1302.119 (PA8)
/micro/clkout: U1301.12 (clkout), U1302.51 (PA5)
/micro/d0: U1301.16 (data0), U1302.47 (PA3)
/micro/d1: U1301.15 (data1), U1302.56 (PB0)
/micro/d2: U1301.14 (data2), U1302.57 (PB1)
/micro/d3: U1301.13 (data3), U1302.79 (PB10)
/micro/d4: U1301.11 (data4), U1302.80 (PB11)
/micro/d5: U1301.10 (data5), U1302.92 (PB12)
/micro/d6: U1301.9 (data6), U1302.93 (PB13)
/micro/d7: U1301.8 (data7), U1302.163 (PB5)
/micro/dir: U1301.19 (dir), U1302.13 (PI11)
/micro/eth_mdc: U1302.33 (PC1); also elsewhere on the board
/micro/eth_mdio: U1302.42 (PA2); also elsewhere on the board
/micro/eth_pwdn_int: U1302.153 (PG10); also elsewhere on the board
/micro/eth_rx_d0: U1302.54 (PC4)
/micro/eth_rx_d1: U1302.55 (PC5)
/micro/eth_tx_d0: U1302.156 (PG13)
/micro/eth_tx_d1: U1302.157 (PG14)
/micro/eth_tx_en: U1302.154 (PG11); also elsewhere on the board
/micro/fs_dm: J1302.2 (D-), U1302.122 (PA11)
/micro/fs_dp: J1302.3 (D+), U1302.123 (PA12)
/micro/fs_vbus: J1302.1 (VBUS), U1302.120 (PA9)
/micro/jntrst: J1303.3, U1302.162 (PB4)
/micro/jtck: J1303.9, U1302.137 (PA14)
/micro/jtdi: J1303.5, U1302.138 (PA15)
/micro/jtdo: J1303.13, U1302.161 (PB3)
/micro/jtms: J1303.7, U1302.124 (PA13)
/micro/led: D1301.1 (K), U1302.10 (PC15)
/micro/lidar_pwr: U1302.165 (PB7); also elsewhere on the board
/micro/lidar_rx: U1302.121 (PA10); also elsewhere on the board
/micro/nRst: J1303.15, U1301.22 (~rst), U1302.31 (NRST); also elsewhere on the board
/micro/nxt: U1301.18 (nxt), U1302.45 (PH4)
/micro/rxd: U1302.97 (PD9); also elsewhere on the board
/micro/sd_cd: J1304.9 (CD), U1302.8 (PC13)
/micro/sd_clk: J1304.5 (CLK), U1302.141 (PC12)
/micro/sd_cmd: J1304.3 (CMD), U1302.144 (PD2)
/micro/sd_dat0: J1304.7 (DAT0), U1302.117 (PC8)
/micro/sd_dat1: J1304.8 (DAT1), U1302.118 (PC9)
/micro/sd_dat2: J1304.1 (DAT2), U1302.139 (PC10)
/micro/sd_dat3: J1304.2 (DAT3/CD), U1302.140 (PC11)
/micro/sonar_ana_in: U1302.34 (PC2); also elsewhere on the board
/micro/sonar_clk: U1302.83 (PH6), U1302.167 (PB8); also elsewhere on the board
/micro/sonar_io1: U1302.173 (PI4); also elsewhere on the board
/micro/sonar_out3: U1302.115 (PC6); also elsewhere on the board
/micro/sonar_out4: U1302.116 (PC7); also elsewhere on the board
/micro/sonar_pwr: U1302.175 (PI6); also elsewhere on the board
/micro/sonar_sel: U1302.174 (PI5); also elsewhere on the board
/micro/stp: U1301.20 (stp), U1302.32 (PC0)
/scl0: U1302.84 (PH7); also elsewhere on the board
/scl1: U1302.17 (PF1); also elsewhere on the board
/sda0: U1302.85 (PH8); also elsewhere on the board
/sda1: U1302.16 (PF0); also elsewhere on the board
/sheet6168BB46/alcc: U1302.20 (PF4); also elsewhere on the board
/water_sensors/lidar_pwr: U1302.164 (PB6); also elsewhere on the board
/water_sensors/sonar_ncs: U1302.168 (PB9); also elsewhere on the board
/water_sensors/sonar_sclk: U1302.132 (PI1); also elsewhere on the board
/water_sensors/sonar_sdi: U1302.95 (PB15); also elsewhere on the board
/water_sensors/sonar_sdo: U1302.94 (PB14); also elsewhere on the board
unnamed: C1316.1, U1301.4 (Vdd3.3)
unnamed: C1321.1, U1302.81 (VCAP_1)
unnamed: C1322.1, U1302.125 (VCAP_2)
unnamed: C1326.2, J1301.1 (VBUS), R1303.2
unnamed: D1301.2 (A), R1302.2
unnamed: J1301.2 (D-), U1301.5 (dm)
unnamed: J1301.3 (D+), U1301.6 (dp)
unnamed: R1301.2, U1301.24 (rbias)
unnamed: R1303.1, U1301.2 (VBus)
unnamed: U1301.23 (refclk), X1301.3 (OUT)
unnamed: U1302.29 (PH0), X1302.3 (OUT)

Notes on the sheet:
Add 1.8V LDO and Vref+

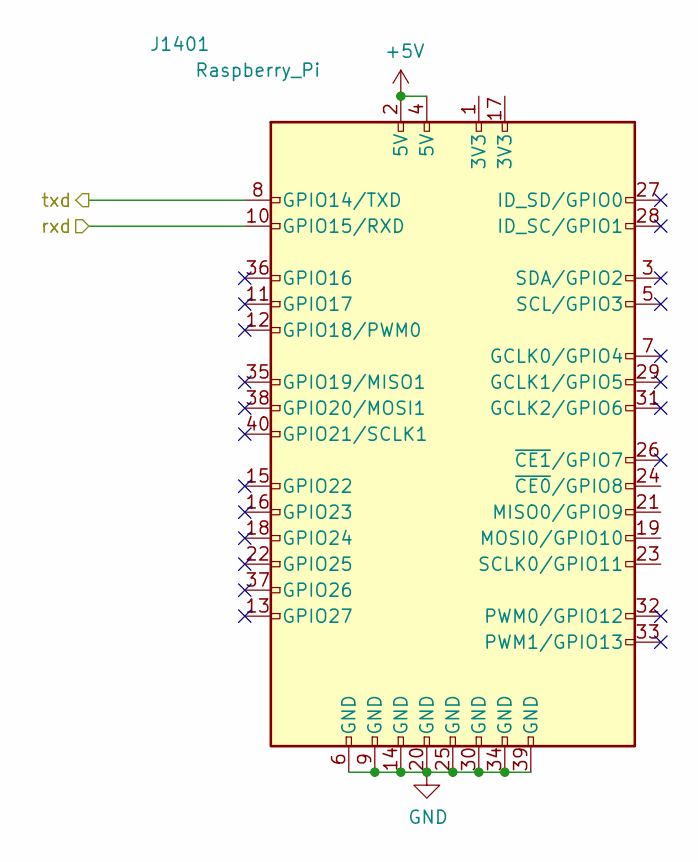
[picture p23: schematic RaspberryPi.sch]

Parts:
J1401: Raspberry_Pi; MODULE_RASPBERRY_PI_3_MODEL_B+

Connections:
+5V: J1401.2 (5V), J1401.4 (5V); also elsewhere on the board
/RaspberryPIZero/rxd: J1401.10 (GPIO15/RXD); also elsewhere on the board
/micro/rxd: J1401.8 (GPIO14/TXD); also elsewhere on the board

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
Board: 2 copper layers, 279 parts (0 on the bottom side), 260 nets, no tracks yet.

Other parts of the board:
C908: 0.1uF,25V; C_01005_0402Metric
R502: 0m5; R_Shunt_Yaego_PU3921

Their connections:
+BATT: C908.1; also elsewhere on the board
/sheet6168BB46/Vbatt: R502.1; also elsewhere on the board
unnamed 153: R502.2; also elsewhere on the board
