highpeng/sub/electrical/lidar board/lidar/power.sch

## KiCad design electrical/lidar board/lidar/power.sch (2021-10-03)

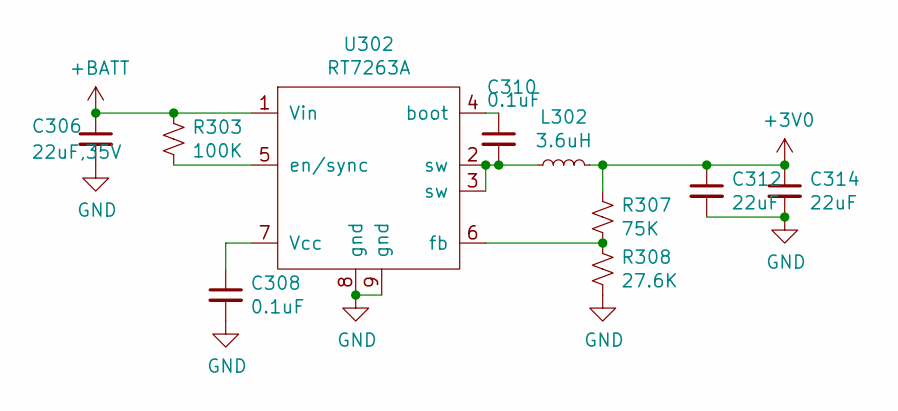
[picture p24: schematic power.sch]

Parts:
C306: 22uF,35V; C_1210_3225Metric
C308, C310: 0.1uF; C_0402_1005Metric
C312, C314: 22uF; C_1210_3225Metric
L302: 3.6uH; NR8040
R303: 100K; R_0402_1005Metric
R307: 75K; R_0402_1005Metric
R308: 27.6K; R_0402_1005Metric
U302: RT7263A; SOP-EP-8_3.9x4.9mm_P1.27mm

Connections:
+3V0: C312.1, C314.1, L302.2, R307.1
+BATT: C306.1, R303.1, U302.1 (Vin)
GND: C306.2, C308.2, C312.2, C314.2, R308.2, U302.8 (gnd), U302.9 (gnd)
unnamed: C308.1, U302.7 (Vcc)
unnamed: C310.1, U302.4 (boot)
unnamed: C310.2, L302.1, U302.2 (sw), U302.3 (sw)
unnamed: R303.2, U302.5 (en/sync)
unnamed: R307.2, R308.1, U302.6 (fb)
