highpeng/sub/electrical/sub board 5.99/sub board.ioc

Mcu.UserName=STM32F217IETx
PA0-WKUP.Signal=S_TIM2_CH1_ETR
PA1.Signal=ETH_REF_CLK
PA10.Signal=USART1_RX
PA11.Signal=USB_OTG_FS_DM
PA12.Signal=USB_OTG_FS_DP
PA13.Signal=SYS_JTMS-SWDIO
PA14.Signal=SYS_JTCK-SWCLK
PA15.Signal=SYS_JTDI
PA2.Signal=ETH_MDIO
PA3.Signal=USB_OTG_HS_ULPI_D0
PA5.Signal=USB_OTG_HS_ULPI_CK
PA7.Signal=ETH_CRS_DV
PA8.Signal=RCC_MCO_1
PA9.Signal=USB_OTG_FS_VBUS
PB0.Signal=USB_OTG_HS_ULPI_D1
PB1.Signal=USB_OTG_HS_ULPI_D2
PB10.Signal=USB_OTG_HS_ULPI_D3
PB11.Signal=USB_OTG_HS_ULPI_D4
PB12.Signal=USB_OTG_HS_ULPI_D5
PB13.Signal=USB_OTG_HS_ULPI_D6
PB14.Signal=SPI2_MISO
PB15.Signal=SPI2_MOSI
PB3.Signal=SYS_JTDO-SWO
PB4.Signal=SYS_JTRST
PB5.Signal=USB_OTG_HS_ULPI_D7
PB6.Signal=USART1_TX
PB8.GPIO_Label=sonar_clk
PB8.Signal=S_TIM10_CH1
PB9.Signal=SPI2_NSS
PC0.Signal=USB_OTG_HS_ULPI_STP
PC1.Signal=ETH_MDC
PC10.Signal=SDIO_D2
PC11.Signal=SDIO_D3
PC12.Signal=SDIO_CK
PC13.Signal=GPIO_Input
PC15-OSC32_OUT.GPIO_Label=led
PC15-OSC32_OUT.Signal=GPIO_Output
PC2.Signal=ADCx_IN12
PC4.Signal=ETH_RXD0
PC5.Signal=ETH_RXD1
PC6.GPIO_Label=sonar_out3
PC6.Signal=S_TIM8_CH1
PC7.GPIO_Label=sonar_out4
PC7.Signal=S_TIM8_CH2
PC8.Signal=SDIO_D0
PC9.Signal=SDIO_D1
PD12.GPIO_Label=bdlc0
PD12.Signal=S_TIM4_CH1
PD13.GPIO_Label=bdlc1
PD13.Signal=S_TIM4_CH2
PD14.GPIO_Label=bdlc2
PD14.Signal=S_TIM4_CH3
PD15.GPIO_Label=bdlc3
PD15.Signal=S_TIM4_CH4
PD2.Signal=SDIO_CMD
PD4.Signal=USART2_RTS
PD5.Signal=USART2_TX
PD6.Signal=USART2_RX
PD8.Signal=USART3_TX
PD9.Signal=USART3_RX
PE11.GPIO_Label=servo1
PE11.Signal=S_TIM1_CH2
PE13.GPIO_Label=servo2
PE13.Signal=S_TIM1_CH3
PE14.GPIO_Label=servo3
PE14.Signal=S_TIM1_CH4
PE5.GPIO_Label=lights
PE5.Signal=S_TIM9_CH1
PE9.GPIO_Label=servo0
PE9.Signal=S_TIM1_CH1
PF0.Signal=I2C2_SDA
PF1.Signal=I2C2_SCL
PF2.GPIO_Label=water
PF2.Signal=GPIO_Input
PF3.GPIO_Label=alcc0
PF3.Signal=GPIO_Input
PF4.GPIO_Label=alcc1
PF4.Signal=GPIO_Input
PF6.Signal=ADC3_IN4
PF7.Signal=ADC3_IN5
PF8.Signal=ADC3_IN6
PF9.Signal=ADC3_IN7
PG10.GPIO_Label=eth_pwd_int
PG10.Signal=GPIO_Input
PG11.Signal=ETH_TX_EN
PG13.Signal=ETH_TXD0
PG14.Signal=ETH_TXD1
PH0-OSC_IN.Signal=RCC_OSC_IN
PH1-OSC_OUT.Signal=RCC_OSC_OUT
PH10.GPIO_Label=bdlc4
PH10.Signal=S_TIM5_CH1
PH11.GPIO_Label=bdlc5
PH11.Signal=S_TIM5_CH2
PH12.GPIO_Label=bdlc6
PH12.Signal=S_TIM5_CH3
PH4.Signal=USB_OTG_HS_ULPI_NXT
PH6.GPIO_Label=sonar_clk_in
PH6.Signal=S_TIM12_CH1
PH7.Signal=I2C3_SCL
PH8.Signal=I2C3_SDA
PI0.GPIO_Label=bdlc7
PI0.Signal=S_TIM5_CH4
PI1.Signal=SPI2_SCK
PI11.Signal=USB_OTG_HS_ULPI_DIR
PI4.GPIO_Label=sonar_io1
PI4.Signal=GPIO_Output
PI5.GPIO_Label=sonar_sel
PI5.Signal=GPIO_Output
PI6.GPIO_Label=sonar_pwr
PI6.Signal=GPIO_Output
