highpeng/sub/(commit log)

2021-10-14 updated sub board
    [ESC_servo_lights.sch, Power.sch, RS485.sch, RaspberryPIZero.sch, RaspberryPI_CM3+.sch, RaspberryPI_CM4.sch, RaspberryPI_Zero.sch, RaspberryPi.sch]
2021-10-24 base board layout
    [ESC.sch, ESC_servo.sch, ESC_servo_lights.sch, Power.kicad_sch, Power.sch, RS485.kicad_sch, RS485.sch, RaspberryPIZero.sch]
